samuelparlindungan/ML-Q-Learning/Artifacts/task.md

# Project Restoration: Hydroponic AI (Q-Learning)

## 📋 Task Checklist
- [x] Analyze workspace files (ESP32, Python, MD docs)
- [x] Identify hardware & software architecture
- [x] Read [summary_all.txt](file:///d:/GitHub/Tes%20Antigravity+Opencode/summary_all.txt) for academic & theoretical alignment
- [x] Complete comprehensive codebase analysis (.ino & .py)
- [x] Develop [ESP32_Aktuator_Maintenance.ino](file:///d:/GitHub/Tes%20Antigravity+Opencode/ESP32_Aktuator_Maintenance/ESP32_Aktuator_Maintenance.ino)
- [x] Verify Maintenance Mode (Serial & MQTT)
- [x] Align with user on next steps (Training vs Testing Bab 4)
- [x] Reorganize files into `Sistem_Kontrol_AI` folder
- [x] Mapping Data Collection Workflow for Thesis
- [x] Aligning Maintenance Firmware with Hardware Changes
- [x] Refining Data Collection Robustness
- [x] Troubleshooting EC Calibration Failure
- [x] Integrate Safety Interlock into Maintenance Firmware
- [x] Implement Training Versioning (Output Folders)
- [x] Relocate and Update Visualization Tools (Training & Dataset)
- [x] Implement Session-Aware Resume & Retry in Random Explorer
- [x] Synchronize stable Moving Average filter to [ESP_Sensor.ino](file:///d:/GitHub/Tes%20Antigravity+Opencode/ESP_Sensor.ino)
- [x] Verify EC/TDS high-point (12.88) with K:1.34
- [x] Calibrate EC low-point (1413) to sync TDS Pen 2x ratio
- [x] Collect 20-30 cycles of factual data via [random_explorer_v1.py](file:///d:/GitHub/Tes%20Antigravity+Opencode/random_explorer_v1.py)
- [x] Update [env_ph_ec.py](file:///d:/GitHub/Tes%20Antigravity+Opencode/env_ph_ec.py) with factual Delta_pH and Delta_EC values
- [x] Implement `ACTIVE_VERSION` switch in [env_ph_ec.py](file:///d:/GitHub/Tes%20Antigravity+Opencode/env_ph_ec.py)
- [x] Automate Output Directory Naming in [main_training.py](file:///d:/GitHub/Tes%20Antigravity+Opencode/main_training.py)
- [x] Automate PNG Generation in [visualize.py](file:///d:/GitHub/Tes%20Antigravity+Opencode/visualize.py)
- [x] Automate [buat_grafik.py](file:///d:/GitHub/Tes%20Antigravity+Opencode/buat_grafik.py) and [cek_nilai_q.py](file:///d:/GitHub/Tes%20Antigravity+Opencode/cek_nilai_q.py) naming
- [x] Create and Automate [main_test_model.py](file:///d:/GitHub/Tes%20Antigravity+Opencode/Sistem_Kontrol_AI/main_test_model.py)
- [x] Upgrade Reporting Scripts to Batch Processing (v1, v2, v3)
- [x] Hardware Safety Optimization (Non-Blocking Reconnect)
- [x] Final Auto-Control Deployment (Model v3 + Retry Logic)
- [x] Digital Twin ([env_ph_ec.py](file:///d:/GitHub/Tes%20Antigravity+Opencode/env_ph_ec.py)) Refactoring (Toggle-Friendly)

## 🏗️ Core Components Identified
- **Hardware**: ESP32 (Sensors & Actuators), Raspberry Pi (RL Agent).
- **Firmware**: 
    - [ESP32_Sensor.ino](file:///d:/GitHub/Tes%20Antigravity+Opencode/ESP32_Sensor/ESP32_Sensor.ino): 40-sample averaging, temperature compensation, MQTT.
    - `ESP32_Aktuator_Bypass`: JSON-based pump control.
- **AI Logic**: 
    - [env_ph_ec.py](file:///d:/GitHub/Tes%20Antigravity+Opencode/env_ph_ec.py): Gymnasium environment with real-world delta values.
    - [qlearning_agent.py](file:///d:/GitHub/Tes%20Antigravity+Opencode/qlearning_agent.py): Agent with Dual Decay (Alpha & Epsilon).
    - [main_training.py](file:///d:/GitHub/Tes%20Antigravity+Opencode/main_training.py): Training script.
- **Next Step Goal**: Finalize simulation vs real-tank data synchronization.
