samuelparlindungan/ML-Q-Learning/STABILITAS_Q_VALUE.md

# 📊 Analisis & Solusi Stabilitas Q-Value

## ❓ Masalah Awal

**Pertanyaan**: Mengapa nilai konvergensi Q tidak pernah mencapai stabil?

**Grafik Sebelumnya**: Q-max berfluktuasi di 120-180 tanpa stabilitas

---

## 🔍 Penyebab Fluktuasi Q-Value

### 1. **Environment Stochastic**

```python
# Natural drift
drift_ph = random.uniform(-0.1, 0.1)
drift_ec = random.uniform(-0.1, 0.1)

# Sensor noise
measured_ph = self.ph + random.uniform(-0.05, 0.05)
measured_ec = self.ec + random.uniform(-0.05, 0.05)
```

- Setiap step memiliki variasi acak
- Q-values terus di-update dengan pengalaman berbeda

### 2. **Learning Rate Konstan**

```python
# Sebelumnya
alpha = 0.15  # Konstan sepanjang training
```

- Learning rate tinggi → Q-values berubah drastis
- Tidak ada penurunan → terus "belajar" dengan intensitas sama

### 3. **Exploration Masih Aktif**

```python
epsilon = 0.089  # Di akhir training masih 8.9%
```

- Agent masih explore → mencoba action suboptimal
- Menghasilkan Q-value updates yang bervariasi

---

## ✅ Solusi Implementasi

### **1. Adaptive Learning Rate**

```python
class QLearningAgent:
    def __init__(self, alpha=0.1, alpha_decay=0.9995, alpha_min=0.01):
        self.alpha = alpha
        self.alpha_decay = alpha_decay
        self.alpha_min = alpha_min
        self.visit_count = np.zeros((n_states, n_actions))

    def update(self, state, action, reward, next_state):
        # Adaptive learning berdasarkan visit count
        self.visit_count[state, action] += 1
        adaptive_alpha = self.alpha / (1 + 0.001 * self.visit_count[state, action])

        # Q-learning update
        best_next = np.max(self.Q[next_state])
        td_target = reward + self.gamma * best_next
        td_error = td_target - self.Q[state, action]
        self.Q[state, action] += adaptive_alpha * td_error

    def decay_alpha(self):
        self.alpha = max(self.alpha_min, self.alpha * self.alpha_decay)
```

**Keuntungan**:

- ✅ Learning rate menurun seiring waktu
- ✅ State yang sering dikunjungi → learning rate lebih kecil
- ✅ Q-values lebih stabil di akhir training

### **2. Epsilon Scheduling yang Lebih Agresif**

```python
epsilon = 1.0           # Start: 100% exploration
epsilon_decay = 0.995   # Decay lebih cepat
epsilon_min = 0.01      # Minimum 1% exploration
```

**Hasil**:

```
Ep 150  | Eps: 0.471  (47.1%)
Ep 300  | Eps: 0.222  (22.2%)
Ep 450  | Eps: 0.105  (10.5%)
Ep 600  | Eps: 0.049  (4.9%)
Ep 750+ | Eps: 0.010  (1.0% - minimum)
```

### **3. Dual Decay (Alpha + Epsilon)**

```python
for ep in range(episodes):
    # ... training loop ...
    agent.decay_epsilon()  # Decay exploration
    agent.decay_alpha()    # Decay learning rate
```

**Hasil Alpha Decay**:

```
Ep 150  | Alpha: 0.0928
Ep 300  | Alpha: 0.0861
Ep 600  | Alpha: 0.0741
Ep 900  | Alpha: 0.0638
Ep 1200 | Alpha: 0.0549
Ep 1500 | Alpha: 0.0472
```

---

## 📈 Hasil Perbandingan

### **Sebelum (Fluktuasi Tinggi)**

```
Hyperparameters:
- alpha = 0.15 (konstan)
- epsilon = 0.4 → 0.01
- epsilon_decay = 0.999

Hasil:
- Q-max: 120-180 (fluktuasi ±30)
- Tidak stabil sampai akhir
```

### **Sesudah (Lebih Stabil)**

```
Hyperparameters:
- alpha = 0.1 → 0.0472 (adaptive decay)
- epsilon = 1.0 → 0.01
- epsilon_decay = 0.995
- visit_count adaptive learning

Hasil:
- Q-max: Lebih smooth dengan moving average
- Stabilitas meningkat di episode 900+
- Learning rate menurun → perubahan lebih kecil
```

---

## 🎯 Mengapa Masih Ada Fluktuasi Kecil?

**NORMAL dan DIHARAPKAN** karena:

1. **Environment Stochastic**
   - Natural drift dan sensor noise tetap ada
   - Ini mencerminkan kondisi real-world

2. **Exploration Minimum (1%)**
   - Agent masih explore sedikit
   - Mencegah overfitting ke satu policy

3. **Continuous Adaptation**
   - Agent tetap adaptif terhadap variasi
   - Tidak "frozen" pada satu nilai

---

## 📊 Cara Membaca Grafik Q-max

### **Dengan Moving Average (Window=50)**

```python
qmax_ma = np.convolve(qmax, np.ones(50)/50, mode="valid")
plt.plot(qmax, alpha=0.3, label="Q-max")
plt.plot(qmax_ma, linewidth=2, label="Moving Avg")
```

**Interpretasi**:

- ✅ Moving average menunjukkan trend stabil
- ✅ Fluktuasi kecil di sekitar trend = normal
- ✅ Tidak ada drift naik/turun drastis = konvergen

---

## 🔧 Tuning Lebih Lanjut (Opsional)

### **Jika Ingin Stabilitas Lebih Tinggi**:

```python
# Opsi 1: Alpha decay lebih agresif
alpha_decay = 0.999  # Dari 0.9995

# Opsi 2: Epsilon minimum lebih kecil
epsilon_min = 0.001  # Dari 0.01

# Opsi 3: Tambah episodes dengan frozen epsilon
for ep in range(1500, 2000):
    agent.epsilon = 0.001  # Frozen
    # ... training ...
```

### **Jika Ingin Learning Lebih Cepat**:

```python
# Alpha awal lebih tinggi
alpha = 0.15  # Dari 0.1

# Tapi decay lebih cepat
alpha_decay = 0.998  # Dari 0.9995
```

---

## ✅ Kesimpulan

### **Fluktuasi Q-Value adalah NORMAL jika**:

1. ✅ Moving average menunjukkan konvergensi
2. ✅ Reward sudah stabil dan meningkat
3. ✅ Learning rate menurun seiring waktu
4. ✅ Fluktuasi berkurang di akhir training

### **Implementasi Saat Ini**:

- ✅ Adaptive learning rate (0.1 → 0.047)
- ✅ Epsilon decay agresif (1.0 → 0.01)
- ✅ Visit-count based adaptation
- ✅ Dual decay (alpha + epsilon)

### **Hasil**:

- ✅ Reward konvergen: -1307 → 34 (stabil)
- ✅ Q-max lebih smooth dengan moving average
- ✅ Stabilitas meningkat signifikan di episode 900+

---

## 📚 Referensi

**Sutton & Barto (2018)**: Reinforcement Learning: An Introduction

- Chapter 2.5: Tracking a Nonstationary Problem
- Chapter 6.5: Q-Learning

**Best Practices**:

- Adaptive learning rates untuk stabilitas
- Epsilon decay untuk balance exploration-exploitation
- Moving average untuk visualisasi trend
