samuelparlindungan/ML-Q-Learning/output/PROJECT_ALL_FILES.md

# KUMPULAN ISI FILE — PROYEK HIDROPONIK RL Q-LEARNING

---

## BAGIAN 1: KODE SUMBER PYTHON (.py)

### `env_ph_ec.py`

```python
import gymnasium as gym  # Import gymnasium library for creating reinforcement learning environments
from gymnasium import (
    spaces,
)  # Import spaces module for defining observation and action spaces
import numpy as np  # Import numpy for numerical operations and arrays

# random sudah diganti np.random.normal() di v5

class PhEcEnv(
    gym.Env
):  # Define the PhEcEnv class inheriting from gym.Env for custom environment
    def __init__(self):  # Initialize the environment instance
        super().__init__()  # Call parent class initializer
        # self.ACTIVE_VERSION = "v5_normal_sesi3"
        self.ACTIVE_VERSION = (
            "v6_final"  # v6: Gabungan Sesi 1-4 (Cleaned) + Anti-Hacking Logic
        )
        # 25 states: 5 pH levels x 5 EC levels (sesuai Tabel 3.3)
        self.observation_space = spaces.Discrete(
            25
        )  # Define observation space as 25 discrete states
        # 9 actions: sesuai Tabel 3.4 (Idle, pH Up Short/Long, dll.)
        self.action_space = spaces.Discrete(
            9
        )  # Define action space as 9 discrete actions
        # Target state: pH index 2, EC index 2 (State 13, indeks 12 di 0-based)
        self.optimal_ph = 2  # Set optimal pH index
        self.optimal_ec = 2  # Set optimal EC index
        # Critical states untuk inisialisasi training (zona Kritis/Kritis Ekstrem)
        self.critical_states = [
            0,
            1,
            2,
            3,
            4,
            5,
            9,
            10,
            14,
            15,
            19,
            20,
            21,
            22,
            23,
            24,
        ]  # List of critical states for initialization
        # Reward table sesuai Tabel 3.6 (zona-based)
        self.reward_table = self._build_reward()  # Build and assign reward table

    def _build_reward(self):  # Private method to build the reward table
        r = np.full(25, 0.0)  # Initialize reward array with 25 zeros

        # Kritis Ekstrem: -40 (States 1,5,21,25 -> indeks 0,4,20,24)
        extreme = [0, 4, 20, 24]  # List of extreme critical state indices
        for s in extreme:  # Loop through extreme states
            # r[s] = -120.0  # Assign reward for extreme states
            r[s] = -40.0  # Assign reward for extreme states (Reward Shaping)

        # Kritis: -20 (States 2,3,4,6,10,11,15,16,20,22,23,24 -> indeks 1,2,3,5,9,10,14,15,19,21,22,23)
        kritis = [
            1,
            2,
            3,
            5,
            9,
            10,
            14,
            15,
            19,
            21,
            22,
            23,
        ]  # List of critical state indices
        for s in kritis:  # Loop through critical states
            # r[s] = -80.0  # Assign reward for critical states
            r[s] = -20.0  # Assign reward for critical states (Reward Shaping)

        # Transisi: -2 (States 7,9,17,19 -> indeks 6,8,16,18)
        transisi = [6, 8, 16, 18]  # List of transition state indices
        for s in transisi:  # Loop through transition states
            # r[s] = -5.0  # Assign reward for transition states
            r[s] = -2.0  # Assign reward for transition states (Reward Shaping)

        # Sub-Optimal: -1 (States 8,12,14,18 -> indeks 7,11,13,17)
        sub_optimal = [7, 11, 13, 17]  # List of sub-optimal state indices
        for s in sub_optimal:  # Loop through sub-optimal states
            # r[s] = 10.0  # Assign reward for sub-optimal states
            r[s] = -1.0  # Paksa agen untuk bergerak ke State 13 (Penalty per step)

        # Target: +100 (State 13 -> indeks 12)
        # r[12] = (
        #    50.0  # [AI BOOSTER] Hadiah Jackpot agar AI sangat termotivasi (aslinya 50)
        # )
        r[12] = (
            100.0  # [Reward Shaping] Insentif tinggi agar AI keluar dari local optima
        )
        return r  # Return the reward array

    def reset(self, seed=None, options=None):  # Reset the environment to initial state
        # Inisialisasi acak dari critical states untuk training
        crit_idx = np.random.choice(
            self.critical_states
        )  # Randomly choose a critical state index
        self.ph = crit_idx // 5 + np.random.uniform(
            -0.4, 0.4
        )  # Set initial pH with random variation
        self.ec = crit_idx % 5 + np.random.uniform(
            -0.4, 0.4
        )  # Set initial EC with random variation
        state = int(
            np.clip(round(self.ph), 0, 4)
        ) * 5 + int(  # Calculate discrete state from pH and EC
            np.clip(round(self.ec), 0, 4)  # Clip EC to valid range
        )
        return state, {}  # Return initial state and empty info dict

    def step(self, action):  # Execute one step in the environment
        delta_ph, delta_ec = 0.0, 0.0  # Initialize changes in pH and EC

        # ======================================================================
        # DATA EMPIRIS TRANSISI (Delta pH & Delta EC) - CLEANED
        # Diambil dari dataset_acak_qlearning.csv (Gabungan Sesi 1-4)
        # Filter: Membuang anomali sensor & lonjakan fisik yang mustahil
        # Tanggal: 2026-04-29
        # ======================================================================
        EC_SCALE = 0.01

        if action == 1:  # pH Up Short
            # delta_ph, delta_ec = 0.50, 0.0    # v1 (Teori)
            # delta_ph, delta_ec = 0.15, 25.6   # v2 (Sesi 1)
            # delta_ph, delta_ec = 0.20, 0.0    # v3 (Sesi 2)
            # delta_ph, delta_ec = 0.15, 40.0   # v4 (Sesi 3)
            # delta_ph = np.random.normal(0.095, 0.01)  # v5 (Sesi 3 Normal)
            # delta_ec = np.random.normal(40.88 * EC_SCALE, 16.11 * EC_SCALE) # v5
            delta_ph = np.random.normal(0.1311, 0.0813)  # v6 (Final: Sesi 1-4 Cleaned)
            delta_ec = np.random.normal(40.90 * EC_SCALE, 47.91 * EC_SCALE)

        elif action == 2:  # pH Up Long
            # delta_ph, delta_ec = 1.00, 0.0    # v1 (Teori)
            # delta_ph, delta_ec = 0.50, 48.2   # v2 (Sesi 1)
            # delta_ph, delta_ec = 0.45, 10.0   # v3 (Sesi 2)
            # delta_ph, delta_ec = 0.40, 27.5   # v4 (Sesi 3)
            # delta_ph = np.random.normal(0.404, 0.198)  # v5 (Sesi 3 Normal)
            # delta_ec = np.random.normal(27.53 * EC_SCALE, 17.29 * EC_SCALE) # v5
            delta_ph = np.random.normal(0.3315, 0.1679)  # v6 (Final: Sesi 1-4 Cleaned)
            delta_ec = np.random.normal(32.88 * EC_SCALE, 33.30 * EC_SCALE)

        elif action == 3:  # pH Down Short
            # delta_ph, delta_ec = -0.50, 0.0   # v1 (Teori)
            # delta_ph, delta_ec = -0.21, 2.0    # v2 (Sesi 1)
            # delta_ph, delta_ec = -0.25, 30.0  # v3 (Sesi 2)
            # delta_ph, delta_ec = -0.20, 2.0   # v4 (Sesi 3)
            # delta_ph = np.random.normal(-0.211, 0.112) # v5 (Sesi 3 Normal)
            # delta_ec = np.random.normal(2.39 * EC_SCALE, 20.22 * EC_SCALE) # v5
            delta_ph = np.random.normal(-0.1672, 0.1018)  # v6 (Final: Sesi 1-4 Cleaned)
            delta_ec = np.random.normal(26.50 * EC_SCALE, 54.25 * EC_SCALE)

        elif action == 4:  # pH Down Long
            # delta_ph, delta_ec = -1.00, 0.0   # v1 (Teori)
            # delta_ph, delta_ec = -0.42, 11.4   # v2 (Sesi 1)
            # delta_ph, delta_ec = -0.16, 40.0  # v3 (Sesi 2)
            # delta_ph, delta_ec = -0.60, 1.7   # v4 (Sesi 3)
            # delta_ph = np.random.normal(-0.594, 0.523) # v5 (Sesi 3 Normal)
            # delta_ec = np.random.normal(1.71 * EC_SCALE, 6.91 * EC_SCALE) # v5
            delta_ph = np.random.normal(-0.4015, 0.3578)  # v6 (Final: Sesi 1-4 Cleaned)
            delta_ec = np.random.normal(26.36 * EC_SCALE, 49.63 * EC_SCALE)

        elif action == 5:  # Nutrisi Short
            # delta_ph, delta_ec = 0.00, 0.50   # v1 (Teori)
            # delta_ph, delta_ec = -0.03, 78.8  # v2 (Sesi 1)
            # delta_ph, delta_ec = -0.02, 75.0  # v3 (Sesi 2)
            # delta_ph, delta_ec = -0.01, 30.0  # v4 (Sesi 3)
            # delta_ph = np.random.normal(-0.013, 0.054) # v5 (Sesi 3 Normal)
            # delta_ec = np.random.normal(29.68 * EC_SCALE, 30.33 * EC_SCALE) # v5
            delta_ph = np.random.normal(-0.0161, 0.0344)  # v6 (Final: Sesi 1-4 Cleaned)
            delta_ec = np.random.normal(57.68 * EC_SCALE, 53.26 * EC_SCALE)

        elif action == 6:  # Nutrisi Long
            # delta_ph, delta_ec = 0.00, 1.00   # v1 (Teori)
            # delta_ph, delta_ec = -0.15, 132.0 # v2 (Sesi 1)
            # delta_ph, delta_ec = -0.18, 276.0 # v3 (Sesi 2)
            # delta_ph, delta_ec = -0.05, 112.0 # v4 (Sesi 3)
            # delta_ph = np.random.normal(-0.050, 0.01)  # v5 (Sesi 3 Normal)
            # delta_ec = np.random.normal(112.74 * EC_SCALE, 35.45 * EC_SCALE) # v5
            delta_ph = np.random.normal(-0.1006, 0.1035)  # v6 (Final: Sesi 1-4 Cleaned)
            delta_ec = np.random.normal(163.92 * EC_SCALE, 78.06 * EC_SCALE)

        elif action == 7:  # Air Baku Short
            # delta_ph, delta_ec = 0.00, -0.50  # v1 (Teori)
            # delta_ph, delta_ec = -0.02, 17.2  # v2 (Sesi 1)
            # delta_ph, delta_ec = -0.02, -290.0 # v3 (Sesi 2)
            # delta_ph, delta_ec = 0.01, -3.1   # v4 (Sesi 3)
            # delta_ph = np.random.normal(0.013, 0.021)  # v5 (Sesi 3 Normal)
            # delta_ec = np.random.normal(-3.13 * EC_SCALE, 3.62 * EC_SCALE) # v5
            delta_ph = np.random.normal(-0.0039, 0.0246)  # v6 (Final: Sesi 1-4 Cleaned)
            delta_ec = np.random.normal(-30.32 * EC_SCALE, 94.89 * EC_SCALE)

        elif action == 8:  # Air Baku Long
            # delta_ph, delta_ec = 0.00, -1.00  # v1 (Teori)
            # delta_ph, delta_ec = -0.00, 13.4  # v2 (Sesi 1)
            # delta_ph, delta_ec = -0.00, -400.0 # v3 (Sesi 2)
            # delta_ph, delta_ec = 0.01, -1.8   # v4 (Sesi 3)
            # delta_ph = np.random.normal(0.015, 0.015)  # v5 (Sesi 3 Normal)
            # delta_ec = np.random.normal(-1.76 * EC_SCALE, 2.84 * EC_SCALE) # v5
            delta_ph = np.random.normal(0.0023, 0.0190)  # v6 (Final: Sesi 1-4 Cleaned)
            delta_ec = np.random.normal(3.58 * EC_SCALE, 31.70 * EC_SCALE)
        # ======================================================================

        # Natural drift (noise empiris dari tandon asli)
        drift_ph = np.random.normal(0.0, 0.01)  # Drift pH alami
        drift_ec = np.random.normal(
            0.0, 3.0 * EC_SCALE
        )  # Drift EC alami (homogenisasi)
        self.ph += delta_ph + drift_ph
        self.ec += delta_ec + drift_ec

        # Sensor noise (Akurasi pembacaan sensor)
        measured_ph = self.ph + np.random.normal(0.0, 0.005)
        measured_ec = self.ec + np.random.normal(0.0, 1.0 * EC_SCALE)

        # Discretization
        ph_d = int(np.clip(round(measured_ph), 0, 4))  # Discretize pH to 0-4
        ec_d = int(np.clip(round(measured_ec), 0, 4))  # Discretize EC to 0-4
        state = ph_d * 5 + ec_d  # Calculate new state index
        reward = self.reward_table[state]  # Get reward for current state

        # Sesuai instruksi Engineer: Jangan mati di State 13 (Non-Episodic Control)
        # Episode berakhir hanya jika masuk ke zona bahaya fisik (Extreme Critical)
        # extreme = [0, 4, 20, 24]
        terminated = state in [0, 4, 20, 24]

        truncated = False  # Set truncated to False (not used)
        return state, reward, terminated, truncated, {}  # Return step results

# ==========================================
# FUNGSI PEMBANTU GLOBAL (Untuk Deploy)
# ==========================================
def get_ph_idx(ph):
    """Konversi nilai pH ke index 0-4 sesuai Tabel 3.3 TA"""
    if ph < 5.5:
        return 0
    if ph < 5.8:
        return 1
    if ph <= 6.2:
        return 2  # Optimal
    if ph <= 6.5:
        return 3
    return 4

def get_ec_idx(ec):
    """Konversi nilai EC ke index 0-4 sesuai Tabel 3.3 TA"""
    if ec < 800:
        return 0
    if ec < 1100:
        return 1
    if ec <= 1300:
        return 2  # Optimal
    if ec <= 1600:
        return 3
    return 4

def get_reward(ph, ec):
    """Hitung reward menggunakan reward_table dari env yang sudah diinisialisasi"""
    env = PhEcEnv()
    state = get_ph_idx(ph) * 5 + get_ec_idx(ec)
    return env.reward_table[state]

```

---

### `qlearning_agent.py`

```python
import numpy as np  # Import numpy for numerical operations and arrays
import random  # Import random for generating random numbers

class QLearningAgent:  # Define the QLearningAgent class for Q-learning algorithm
    def __init__(  # Initialize the Q-learning agent
        self,
        n_states=25,  # Number of states in the environment
        n_actions=9,  # Number of actions available
        alpha=0.1,  # Ekploration 10%, Eksploitation 90%
        #alpha_decay=0.9995,  # Decay rate for alpha
        alpha_decay=0.9998,  # Decay rate for alpha
        alpha_min=0.01,  # Minimum value for alpha
        #gamma=0.95,  # Jika agent
        # persamaan bellman equation notasi gamma adalah diskon faktor
        #gamma=0.90,  # Diskon faktor (Bellman Equation)
        gamma=0.95,  # Visi jangka panjang (Sesuai draf B600)
        epsilon=1.0,  # Initial exploration rate
        #epsilon_decay=0.995,  # Decay rate for epsilon
        #epsilon_decay=0.9995,  # Decay rate for epsilon
        epsilon_decay=0.9999,  # Eksplorasi awet sampai 50rb episode (Sesuai draf B600)
        epsilon_min=0.01,  # Minimum value for epsilon
    ):
        self.Q = np.zeros((n_states, n_actions))  # 25x9 sesuai Tabel 3.5
        #self.alpha = 0.05  # Learning rate lebih stabil untuk reward besar
        self.alpha = alpha  # Menggunakan parameter (0.10)
        self.alpha_decay = alpha_decay  # Decay untuk learning rate
        self.alpha_min = alpha_min  # Minimum learning rate
        #self.gamma = 0.999  # Visi jangka sangat panjang
        #self.gamma = 0.90  # Menggunakan parameter (0.90)
        self.gamma = gamma  # Menggunakan parameter (0.95)
        self.epsilon = epsilon  # Initial exploration rate
        #self.epsilon_decay = 0.9999  # Eksplorasi awet sampai 50rb episode
        #self.epsilon_decay = 0.9995  # eps -> 0.01 di ~ep 9200
        self.epsilon_decay = epsilon_decay  # Eksplorasi awet (0.9999)
        self.epsilon_min = epsilon_min  # Minimum exploration rate
        self.n_actions = n_actions  # Number of actions

        # Track visit count untuk adaptive learning
        self.visit_count = np.zeros(
            (n_states, n_actions)
        )  # Initialize visit count array

    def select_action(self, state):  # Select an action based on epsilon-greedy policy
        if (
            random.random() < self.epsilon
        ):  # If random number less than epsilon, explore
            return random.randint(0, self.n_actions - 1)  # Return random action
        return np.argmax(self.Q[state])  # Return action with highest Q-value

    def update(
        self, state, action, reward, next_state
    ):  # Update Q-table using Q-learning update rule
        # Adaptive learning rate berdasarkan visit count
        self.visit_count[
            state, action
        ] += 1  # Increment visit count for state-action pair
        # adaptive_alpha = self.alpha / (1 + 0.001 * self.visit_count[state, action])  # v1
        adaptive_alpha = self.alpha / (
            1 + 0.01 * self.visit_count[state, action]
        )  # v2: Lebih responsif

        best_next = np.max(self.Q[next_state])  # Get maximum Q-value for next state
        td_target = reward + self.gamma * best_next  # Calculate TD target
        td_error = td_target - self.Q[state, action]  # Calculate TD error
        self.Q[state, action] += adaptive_alpha * td_error  # Update Q-value

    def decay_epsilon(self):  # Decay the exploration rate
        self.epsilon = max(
            self.epsilon_min, self.epsilon * self.epsilon_decay
        )  # Update epsilon with decay

    def decay_alpha(self):  # Decay learning rate for stability at end of training
        """Decay learning rate untuk stabilitas di akhir training"""
        self.alpha = max(
            self.alpha_min, self.alpha * self.alpha_decay
        )  # Update alpha with decay

```

---

### `main_training.py`

```python
import numpy as np  # Import numpy for numerical operations and arrays
import json  # Import json for saving policy data
import os  # Import os for file system operations
from env_ph_ec import PhEcEnv  # Import the custom PhEcEnv environment
from qlearning_agent import QLearningAgent  # Import the QLearningAgent class

# ==========================================
# 0. KONFIGURASI VERSI (Manual)
# ==========================================
# Sesuaikan nama versi ini dengan yang Anda pilih di env_ph_ec.py
VERSION = "v6_lama"  # Hasil Akhir: Sesi 1-4 Cleaned + Anti-Hacking + New Reward
# VERSION = "v5_normal_sesi3"

# Gunakan path absolut agar folder output selalu berada di dalam project
SCRIPT_DIR = os.path.dirname(os.path.abspath(__file__))
OUT_DIR = os.path.normpath(os.path.join(SCRIPT_DIR, "..", "output", VERSION))
os.makedirs(OUT_DIR, exist_ok=True)
env = PhEcEnv()  # Initialize the PhEc environment
agent = QLearningAgent(n_states=25, n_actions=9)  # Initialize the Q-learning agent

episodes = 10000  # [AI BOOSTER] Ditambah agar AI punya waktu latihan yang cukup
max_steps = 200  # [AI BOOSTER] Ditambah agar AI punya napas panjang mencapai target

reward_log = []  # List to log total rewards per episode
step_log = []  # List to log steps per episode
qmax_log = []  # List to log maximum Q-values per episode
alpha_log = []  # List to log alpha values per episode
state_visit = np.zeros(25)  # Array to count visits to each state
action_count = np.zeros(9)  # Array to count actions taken
trajectory = []  # List to store state trajectories

print("Critical states:", env.critical_states)  # Print critical states
print("Reward grid:\n", env.reward_table.reshape(5, 5))  # Print reward grid
print(
    f"Initial: Alpha={agent.alpha:.3f}, Epsilon={agent.epsilon:.3f}\n"
)  # Print initial parameters

for ep in range(episodes):  # Loop over episodes
    state, _ = env.reset()  # Reset environment and get initial state
    total_reward = 0  # Initialize total reward for episode
    steps = 0  # Initialize step count

    for _ in range(max_steps):  # Loop over maximum steps
        action = agent.select_action(state)  # Select action using agent
        next_state, reward, done, _, _ = env.step(action)  # Take step in environment
        agent.update(state, action, reward, next_state)  # Update agent Q-table
        state_visit[state] += 1  # Increment state visit count
        action_count[action] += 1  # Increment action count
        trajectory.append(state)  # Append state to trajectory
        state = next_state  # Update current state
        total_reward += reward  # Accumulate reward
        steps += 1  # Increment step count
        if done:  # If episode is done
            state_visit[next_state] += 1  # Count visit to terminal state
            trajectory.append(next_state)  # Append terminal state to trajectory
            break  # Break the loop

        state = next_state  # Update state for next iteration

    agent.decay_epsilon()  # Decay epsilon
    agent.decay_alpha()  # Decay learning rate juga

    reward_log.append(total_reward)  # Append total reward to log
    step_log.append(steps)  # Append steps to log
    qmax_log.append(np.max(agent.Q))  # Append max Q to log
    alpha_log.append(agent.alpha)  # Append alpha to log

    if (ep + 1) % 150 == 0:  # Every 150 episodes
        avg_r = np.mean(
            reward_log[-150:]
        )  # Calculate average reward of last 150 episodes
        print(  # Print progress
            f"Ep {ep+1} | AvgR:{avg_r:.1f} | Eps:{agent.epsilon:.3f} | Alpha:{agent.alpha:.4f}"
        )

# Save ke folder output/
np.save(f"{OUT_DIR}/Q_table.npy", agent.Q)  # Save Q-table
np.save(f"{OUT_DIR}/reward_log.npy", reward_log)  # Save reward log
np.save(f"{OUT_DIR}/step_log.npy", step_log)  # Save step log
np.save(f"{OUT_DIR}/qmax_log.npy", qmax_log)  # Save qmax log
np.save(f"{OUT_DIR}/alpha_log.npy", alpha_log)  # Save alpha log
np.save(f"{OUT_DIR}/state_visit.npy", state_visit)  # Save state visit counts
np.save(f"{OUT_DIR}/action_count.npy", action_count)  # Save action counts
np.save(f"{OUT_DIR}/trajectory.npy", trajectory)  # Save trajectory

# Buat policy.json
policy = {}  # Initialize policy dictionary
for state in range(25):  # Loop over all states
    ph_idx = state // 5  # Calculate pH index
    ec_idx = state % 5  # Calculate EC index
    best_action = int(np.argmax(agent.Q[state]))  # Get best action
    q_values = agent.Q[state].tolist()  # Get Q-values as list
    policy[f"state_{state+1}"] = {  # Add to policy dict
        "pH_index": ph_idx,
        "EC_index": ec_idx,
        "best_action": best_action,
        "q_values": q_values,
        "max_q": float(np.max(agent.Q[state])),
    }

with open(f"{OUT_DIR}/policy.json", "w") as f:  # Open policy.json file
    json.dump(policy, f, indent=2)  # Dump policy to JSON

print("\n[OK] TRAINING SELESAI!")  # Print completion message
print(
    f"Final: Alpha={agent.alpha:.4f}, Epsilon={agent.epsilon:.3f}"
)  # Print final parameters
print(
    "File output: Q_table.npy, reward_log.npy, step_log.npy, qmax_log.npy,"
)  # Print output files
print(  # Continue printing output files
    "             alpha_log.npy, state_visit.npy, action_count.npy, trajectory.npy, policy.json"
)

```

---

### `random_explorer_v1.py`

```python
import paho.mqtt.client as mqtt
import time
import pandas as pd
import os
import json
import random
from datetime import datetime

# ==========================================
# 1. KONFIGURASI MQTT & FILE
# ==========================================
MQTT_BROKER = "192.168.100.10"
MQTT_PORT = 1883
TOPIC_SENSOR = "hidroponik/sensor"
TOPIC_ACTION = "hidroponik/action"
TOPIC_STATUS = "hidroponik/status"

CSV_FILENAME = "../dataset_acak_qlearning.csv"
WAKTU_MIXING = 180  # 3 Menit jeda pelarutan
WAKTU_SAMP = 60  # 1 Menit pengambilan data per state (sesuai Skripsi)

# ==========================================
# 2. VARIABEL GLOBAL
# ==========================================
buffer_ph = []
buffer_ec = []
pompa_selesai = False
current_tx_id = ""  # ID unik untuk mencegah double-dosing

# ==========================================
# 3. CALLBACK MQTT
# ==========================================
def on_connect(client, userdata, flags, rc):
    print(f"✅ Terhubung ke Broker MQTT (RC: {rc})")
    client.subscribe(TOPIC_SENSOR)
    client.subscribe(TOPIC_STATUS)

def on_message(client, userdata, msg):
    global pompa_selesai, buffer_ph, buffer_ec
    payload = msg.payload.decode("utf-8")

    if msg.topic == TOPIC_STATUS:
        # Verifikasi apakah DONE ini milik perintah yang baru saja dikirim
        if payload == f"DONE:{current_tx_id}":
            pompa_selesai = True
            print(f"   [MQTT] Konfirmasi Diterima: {payload}")
        elif payload.startswith("DONE:"):
            print(f"   [MQTT] Abaikan konfirmasi lama: {payload}")

    elif msg.topic == TOPIC_SENSOR:
        try:
            data = json.loads(payload)
            ph = float(data.get("ph", data.get("pH", 0.0)))
            ec = float(data.get("ec", data.get("EC", 0.0)))
            buffer_ph.append(ph)
            buffer_ec.append(ec)
        except:
            pass

# ==========================================
# 4. FUNGSI HELPER
# ==========================================
def ambil_rata_rata(durasi_detik):
    global buffer_ph, buffer_ec
    buffer_ph.clear()
    buffer_ec.clear()

    print(f"   [Sampling] Mengambil data selama {durasi_detik} detik...")
    for i in range(durasi_detik, 0, -1):
        if i % 15 == 0:
            print(f"   Sisa waktu sampling: {i}s")
        time.sleep(1)

    if len(buffer_ph) == 0:
        return None, None

    avg_ph = round(sum(buffer_ph) / len(buffer_ph), 2)
    avg_ec = round(sum(buffer_ec) / len(buffer_ec), 2)
    return avg_ph, avg_ec

def inisialisasi_csv(session_name):
    if not os.path.exists(CSV_FILENAME):
        df = pd.DataFrame(
            columns=[
                "Sesi_Eksperimen",
                "Cycle",
                "pH_St",
                "EC_St",
                "Action",
                "pH_St1",
                "EC_St1",
                "Delta_pH",
                "Delta_EC",
                "Timestamp",
            ]
        )
        df.to_csv(CSV_FILENAME, index=False)
        return 0
    try:
        df = pd.read_csv(CSV_FILENAME)
        if df.empty:
            return 0
        session_data = df[df["Sesi_Eksperimen"] == session_name]
        if session_data.empty:
            return 0
        return int(session_data["Cycle"].max())
    except:
        return 0

# ==========================================
# 5. PROGRAM UTAMA (RANDOM EXPLORER)
# ==========================================
if __name__ == "__main__":
    client = mqtt.Client()
    client.on_connect, client.on_message = on_connect, on_message

    try:
        client.connect(MQTT_BROKER, MQTT_PORT, 60)
        client.loop_start()

        print("\n" + "=" * 55)
        print("🤖   ROBOT EKSPLORASI ACAK (RELIABLE VERSION)   🤖")
        print("=" * 55)

        sesi_name = input("Masukkan Nama Sesi (Misal: Sesi_2): ")
        if not sesi_name:
            sesi_name = "Default_Session"

        CYCLES_TO_RUN = 50
        last_cycle = inisialisasi_csv(sesi_name)
        start_cycle = last_cycle + 1

        for cycle in range(start_cycle, CYCLES_TO_RUN + 1):
            print(f"\n🚀 >>> SIKLUS: {cycle}/{CYCLES_TO_RUN} <<<")

            # --- LANGKAH 1: STATE AWAL ---
            ph_st, ec_st = ambil_rata_rata(WAKTU_SAMP)
            if ph_st is None:
                print("❌ [ERROR] Sensor Offline! Berhenti.")
                break
            print(f"   [State St] pH: {ph_st} | EC: {ec_st}")

            # --- LANGKAH 2: AKSI ACAK DENGAN TXID ---
            aksi = random.randint(1, 8)
            current_tx_id = str(int(time.time()))[-6:]  # Unique ID
            payload = f"{aksi}:{current_tx_id}"

            # Pastikan Koneksi MQTT Aktif sebelum kirim
            if not client.is_connected():
                print("   ⚠️ [MQTT] Terputus! Menunggu koneksi kembali...")
                for _ in range(10):  # Tunggu max 10 detik
                    time.sleep(1)
                    if client.is_connected():
                        break

            success_sent = False
            for attempt in range(1, 5):  # Maks 4 kali percobaan
                if not client.is_connected():
                    print(f"   ❌ [MQTT] Percobaan {attempt} gagal: Broker Offline.")
                    time.sleep(2)
                    continue

                print(f"   [Action] Percobaan {attempt}/4: Kirim {payload}")
                pompa_selesai = False
                client.publish(TOPIC_ACTION, payload)

                start_wait = time.time()
                while not pompa_selesai:
                    if time.time() - start_wait > 20:  # Timeout 20 detik
                        print(f"   ⚠️ [TIMEOUT] Percobaan {attempt} gagal.")
                        break
                    time.sleep(0.5)

                if pompa_selesai:
                    success_sent = True
                    break

            if not success_sent:
                print(
                    "❌ [FAILED] Gagal mendapatkan konfirmasi hardware. Lewati siklus."
                )
                continue

            # --- LANGKAH 3: HOMOGENISASI ---
            print(f"   [Mixing] Homogenisasi {WAKTU_MIXING} detik...")
            time.sleep(WAKTU_MIXING)

            # --- LANGKAH 4: STATE AKHIR ---
            ph_st1, ec_st1 = ambil_rata_rata(WAKTU_SAMP)
            if ph_st1 is None:
                continue
            print(f"   [State St1] pH: {ph_st1} | EC: {ec_st1}")

            # --- LANGKAH 5: SIMPAN ---
            delta_ph, delta_ec = round(ph_st1 - ph_st, 2), round(ec_st1 - ec_st, 2)
            row = [
                sesi_name,
                cycle,
                ph_st,
                ec_st,
                aksi,
                ph_st1,
                ec_st1,
                delta_ph,
                delta_ec,
                datetime.now(),
            ]

            pd.DataFrame([row]).to_csv(
                CSV_FILENAME, mode="a", header=False, index=False
            )
            print(f"✅ [SUCCESS] Data Siklus {cycle} tersimpan.")

    except KeyboardInterrupt:
        print("\n🛑 Dihentikan manual.")
    finally:
        client.loop_stop()
        client.disconnect()
        print("Koneksi ditutup. File CSV Anda siap diolah!")

```

---

### `main_auto_control.py`

```python
import paho.mqtt.client as mqtt
import time, json, os, pandas as pd
import csv, threading
from datetime import datetime
from env_ph_ec import PhEcEnv

# ==========================================
# 0. KONFIGURASI SISTEM
# ==========================================
SCRIPT_DIR = os.path.dirname(os.path.abspath(__file__))
MQTT_BROKER, MQTT_PORT = "192.168.100.10", 1883
TOPICS = {
    "sensor": "hidroponik/sensor",
    "action": "hidroponik/action",
    "status": "hidroponik/status",
}
VERSION_LOAD = "v6_final"
CSV_AUTO = os.path.normpath(
    os.path.join(SCRIPT_DIR, "..", "output", "data_transisi_otomatis.csv")
)
POLICY_FILE = os.path.normpath(
    os.path.join(SCRIPT_DIR, "..", "output", VERSION_LOAD, "policy.json")
)
LOG_FILE = os.path.normpath(os.path.join(SCRIPT_DIR, "..", "output", "system_log.csv"))

MAX_STEPS = 50  # <-- Diganti dari MAX_ACTIONS
WAKTU_HOMO = 180
WAKTU_SAMPLING = 60

# --- Shared State (dilindungi RLock) ---
lock = threading.RLock()

status = "SAMPLING"
waktu_homo_end = 0
waktu_sampling_end = time.time() + WAKTU_SAMPLING
waktu_resend_next = 0
waktu_kirim = 0
current_tx_id = ""
policy_ai = {}
sampling_buffer = {"ph": [], "ec": []}
tracking = {
    "wait_st1": False,
    "st_ph": 0.0,
    "st_ec": 0.0,
    "act": -1,
    "q": 0.0,
    "total_steps": 0,  # <-- Diganti dari total_actions
}

SAFETY_SWITCH = [True, True, True, True, True]

ACTIONS = {
    0: "IDLE",
    1: "pH Up S",
    2: "pH Up L",
    3: "pH Down S",
    4: "pH Down L",
    5: "Nutrisi S",
    6: "Nutrisi L",
    7: "Air S",
    8: "Air L",
}

MAX_RETRIES = 3
retry_count = 0

# Throttle [LEVELS]
_last_level_print = 0
LEVEL_PRINT_INTERVAL = 5
_level_printed = False  # Cetak level hanya sekali di awal

# ==========================================
# 1. FUNGSI PEMBANTU
# ==========================================
def get_ph_idx(v):
    """Konversi pH ke indeks 0-4 sesuai Tabel 3.1"""
    if v < 5.5:
        return 0
    elif v < 5.8:
        return 1
    elif v <= 6.2:
        return 2
    elif v <= 6.5:
        return 3
    else:
        return 4

def get_ec_idx(v):
    """Konversi EC ke indeks 0-4 sesuai Tabel 3.2"""
    if v < 800:
        return 0
    elif v < 1100:
        return 1
    elif v <= 1300:
        return 2
    elif v <= 1600:
        return 3
    else:
        return 4

def get_reward(ph, ec):
    """Hitung reward berdasarkan Tabel 3.6 Bab 3"""
    env = PhEcEnv()
    state = get_ph_idx(ph) * 5 + get_ec_idx(ec)
    return env.reward_table[state]

def write_log(event_type, topic, detail=""):
    file_exists = os.path.isfile(LOG_FILE)
    os.makedirs(os.path.dirname(LOG_FILE), exist_ok=True)
    with open(LOG_FILE, mode="a", newline="") as f:
        writer = csv.writer(f)
        if not file_exists:
            writer.writerow(["timestamp", "event_type", "topic", "detail"])
        writer.writerow([datetime.now().isoformat(), event_type, topic, detail])

def log_transition(ph_now, ec_now):
    with lock:
        if not tracking["wait_st1"]:
            return
        reward = get_reward(ph_now, ec_now)
        data = {
            "Sesi": f"AUTO_{VERSION_LOAD}",
            "Aksi": tracking["act"],
            "pH_St": tracking["st_ph"],
            "EC_St": tracking["st_ec"],
            "pH_St+1": ph_now,
            "EC_St+1": ec_now,
            "Delta_pH": round(ph_now - tracking["st_ph"], 2),
            "Delta_EC": round(ec_now - tracking["st_ec"], 2),
            "Reward": reward,
            "Max_Q": tracking["q"],
            "Timestamp": datetime.now().strftime("%Y-%m-%d %H:%M:%S"),
        }
        tracking["wait_st1"] = False
    df = pd.DataFrame([data])
    df.to_csv(CSV_AUTO, mode="a", header=not os.path.exists(CSV_AUTO), index=False)
    print(
        f"[LOG] DATA DISIMPAN: {ACTIONS[data['Aksi']]} | D_pH:{data['Delta_pH']} | D_EC:{data['Delta_EC']} | R:{data['Reward']}"
    )

def push_action(action_id, is_retry=False):
    """Harus dipanggil di dalam 'with lock'."""
    global waktu_resend_next, current_tx_id, waktu_kirim, retry_count

    if not is_retry:
        current_tx_id = str(int(time.time()))[-6:]
        waktu_kirim = time.time()
        retry_count = 0

    payload = f"{action_id}:{current_tx_id}"
    client.publish(TOPICS["action"], payload)
    write_log("SEND_ACTION", TOPICS["action"], payload)

    timeout_map = {7: 65, 8: 185}
    timeout = timeout_map.get(action_id, 15)
    waktu_resend_next = time.time() + timeout

    if not is_retry:
        print(f"[ACTION] Perintah Terkirim: {ACTIONS.get(action_id)} (ID:{payload})")
    return True

# ==========================================
# 2. HANDLER MQTT
# ==========================================
def on_connect(client, userdata, flags, reason_code, properties):
    print(f"[MQTT] Terhubung ke Broker! Model Aktif: {VERSION_LOAD}")
    for t in TOPICS.values():
        client.subscribe(t)

def on_message(client, userdata, msg):
    global status, waktu_homo_end, waktu_sampling_end, retry_count, _last_level_print, _level_printed
    payload = msg.payload.decode("utf-8")

    # --- Guard HALT & Snapshot status (dengan lock) ---
    with lock:
        if status == "HALT":
            return
        current_status = status  # snapshot untuk konsistensi di cabang pertama

    # A. Feedback Selesai dari ESP32
    if msg.topic == TOPICS["status"] and current_status == "DOSING":
        try:
            res = json.loads(payload)
            if res.get("tx") == current_tx_id and res.get("status") == "DONE":
                write_log("RECV_STATUS", msg.topic, payload)
                latensi = int((time.time() - waktu_kirim) * 1000)
                print(f"[STATUS] Selesai! ID: {res.get('tx')} | Latensi: {latensi}ms")
                with lock:
                    status = "HOMO"
                    waktu_homo_end = time.time() + WAKTU_HOMO
                    retry_count = 0
        except Exception:
            if payload == f"DONE:{current_tx_id}":
                with lock:
                    status = "HOMO"
                    waktu_homo_end = time.time() + WAKTU_HOMO
                    retry_count = 0
            else:
                print(f"[MQTT] Gagal parse status: {payload[:50]}")
        return  # Selesai proses status feedback

    # B. Monitoring Sensor & Keputusan AI
    if msg.topic != TOPICS["sensor"]:
        return

    write_log("RECV_SENSOR", msg.topic, payload)
    try:
        data = json.loads(payload)
        ph, ec = float(data.get("ph", 0)), float(data.get("ec", 0))

        v1, v2, v3, v4, v5 = (
            data.get("t1", 0),
            data.get("t2", 0),
            data.get("t3", 0),
            data.get("t4", 0),
            data.get("t5", 0),
        )
        vb = data.get("box", 0)

        if ph < 3 or ph > 9 or ec < 0 or ec > 3000:
            return

        tabung_levels = [v1, v2, v3, v4, v5]

        # Safety interlock
        low_level = False
        if vb < 5.0:
            print(f"[WAIT] Tandon Utama KRITIS ({vb:.1f}L)! Menunggu pengisian...")
            low_level = True
        for i, vol in enumerate(tabung_levels):
            if SAFETY_SWITCH[i] and vol < 100.0:
                print(
                    f"[WAIT] Tabung T{i+1} KRITIS ({vol:.0f}ml)! Menunggu pengisian..."
                )
                low_level = True

        # Cetak level hanya sekali di awal
        with lock:
            if not _level_printed:
                level_str = " | ".join(
                    [
                        f"T{i+1}:{v:.0f}ml" if SAFETY_SWITCH[i] else f"T{i+1}:OFF"
                        for i, v in enumerate(tabung_levels)
                    ]
                )
                print(f"[LEVELS] {level_str} | Box:{vb:.1f}L")
                _level_printed = True

        # --- State Management dengan re-snapshot setiap langkah ---

        # 1. Cek low level & transisi WAITING_REFILL
        if low_level:
            with lock:
                status = "WAITING_REFILL"
            return

        # 2. Jika tadi WAITING_REFILL, sekarang low_level sudah False -> resume langsung ke SAMPLING
        with lock:
            if status == "WAITING_REFILL":
                print("[RESUME] Air sudah terisi! Melanjutkan sistem...")
                status = "SAMPLING"
                waktu_sampling_end = time.time() + WAKTU_SAMPLING
                sampling_buffer["ph"], sampling_buffer["ec"] = [], []
                retry_count = 0
            # Ambil snapshot ulang karena status bisa berubah
            current_status = status

        # 3. State HOMO
        if current_status == "HOMO":
            with lock:
                if waktu_homo_end <= time.time():
                    status = "SAMPLING"
                    waktu_sampling_end = time.time() + WAKTU_SAMPLING
                    sampling_buffer["ph"], sampling_buffer["ec"] = [], []
                    retry_count = 0
                    current_status = status
                else:
                    current_status = "HOMO"
            if current_status != "SAMPLING":
                return
            return

        # 4. State SAMPLING
        if current_status == "SAMPLING":
            with lock:
                sampling_buffer["ph"].append(ph)
                sampling_buffer["ec"].append(ec)
                sisa = waktu_sampling_end - time.time()
            if sisa > 0:
                return

            # Guard buffer kosong
            if not sampling_buffer["ph"]:
                print("[WARN] Buffer sampling kosong, skip siklus ini.")
                with lock:
                    waktu_sampling_end = time.time() + WAKTU_SAMPLING
                return

            # Hitung rata-rata
            with lock:
                avg_ph = sum(sampling_buffer["ph"]) / len(sampling_buffer["ph"])
                avg_ec = sum(sampling_buffer["ec"]) / len(sampling_buffer["ec"])
                sampling_buffer["ph"], sampling_buffer["ec"] = [], []

            print(f"[SENSOR] Hasil Pembacaan: pH:{avg_ph:.2f}, EC:{avg_ec:.0f}")

            # Log transisi sebelumnya
            log_transition(avg_ph, avg_ec)

            # Keputusan AI
            s_idx = get_ph_idx(avg_ph) * 5 + get_ec_idx(avg_ec)
            state_key = f"state_{s_idx + 1}"

            if state_key not in policy_ai:
                print(f"[WARN] State {state_key} tidak ditemukan di policy!")
                with lock:
                    waktu_sampling_end = time.time() + WAKTU_SAMPLING
                return

            best_act = policy_ai[state_key]["best_action"]
            p_idx, e_idx = get_ph_idx(avg_ph), get_ec_idx(avg_ec)
            ph_labels = ["S.Rendah", "Rendah", "Optimal", "Tinggi", "S.Tinggi"]
            ec_labels = ["S.Rendah", "Rendah", "Optimal", "Tinggi", "S.Tinggi"]

            # Batas langkah (STEP)
            with lock:
                total_steps = tracking["total_steps"]
            if MAX_STEPS > 0 and total_steps >= MAX_STEPS:
                print(f"[FINISH] Uji Keandalan {MAX_STEPS} Step Selesai.")
                with lock:
                    status = "FINISH"
                return

            # --- Increment step (SETIAP SIKLUS) ---
            with lock:
                tracking["total_steps"] += 1
                total_steps = tracking["total_steps"]
                tracking.update(
                    {
                        "wait_st1": True,
                        "st_ph": avg_ph,
                        "st_ec": avg_ec,
                        "act": best_act,
                        "q": policy_ai[state_key]["max_q"],
                    }
                )

            if best_act == 0:  # IDLE
                print(
                    f"[STEP {total_steps}/{MAX_STEPS}] IDLE | State: {state_key} (pH:{ph_labels[p_idx]}, EC:{ec_labels[e_idx]}) | Kondisi Optimal."
                )
                with lock:
                    waktu_sampling_end = time.time() + WAKTU_SAMPLING
                    retry_count = 0
                return

            # NON-IDLE
            print(
                f"[STEP {total_steps}/{MAX_STEPS}] {ACTIONS[best_act]} | State: {state_key} (pH:{ph_labels[p_idx]}, EC:{ec_labels[e_idx]})"
            )
            with lock:
                if push_action(best_act):
                    status = "DOSING"
            return

    except Exception as e:
        print(f"[ERROR] on_message exception: {e}")

# ==========================================
# 3. MAIN RUN LOOP
# ==========================================
if __name__ == "__main__":
    print("\n" + "=" * 55)
    print("    SISTEM KONTROL OTOMATIS: RL Q-Learning    ")
    print("=" * 55)

    if not os.path.exists(POLICY_FILE):
        print(f"[ERROR] File {POLICY_FILE} tidak ditemukan!")
        exit()

    with open(POLICY_FILE, "r") as f:
        policy_ai = json.load(f)
    print(f"[DATA] Memuat {len(policy_ai)} skenario kecerdasan AI.")

    client = mqtt.Client(mqtt.CallbackAPIVersion.VERSION2)
    client.on_connect, client.on_message = on_connect, on_message

    try:
        client.connect(MQTT_BROKER, MQTT_PORT, 60)
        client.loop_start()

        while True:
            with lock:
                if status == "DOSING" and time.time() > waktu_resend_next:
                    if retry_count < MAX_RETRIES:
                        print(
                            f"[RETRY] ESP32 tidak merespon. Mengirim ulang ID:{current_tx_id} "
                            f"(percobaan ke-{retry_count+1}/{MAX_RETRIES})..."
                        )
                        write_log(
                            "RETRY_ACTION", TOPICS["action"], f"resend {current_tx_id}"
                        )
                        push_action(tracking["act"], is_retry=True)
                        retry_count += 1
                    else:
                        print(
                            "[ERROR] ESP32 tidak merespon setelah 3 kali percobaan. Sistem HALT sementara."
                        )
                        status = "HALT"
            time.sleep(1)

    except KeyboardInterrupt:
        print("\n[STOP] Sistem dimatikan secara manual.")
        client.loop_stop()
        client.disconnect()

```

---

## BAGIAN 2: DATA EKSPERIMEN (.csv)

### `dataset_acak_qlearning.csv`

```
Sesi_Eksperimen,Cycle,pH_St,EC_St,Action,pH_St1,EC_St1,Delta_pH,Delta_EC,Timestamp
Sesi_1,1,7.88,0.0,6,7.5,16.18,-0.38,16.18,2026-04-16 03:53:06
Sesi_1,2,7.5,15.75,6,7.28,164.45,-0.22,148.7,2026-04-16 03:58:13
Sesi_1,3,7.27,161.58,8,7.28,192.45,0.01,30.87,2026-04-16 04:03:29
Sesi_1,4,7.29,191.18,4,6.27,216.83,-1.02,25.65,2026-04-16 04:08:34
Sesi_1,5,6.26,215.82,3,6.07,212.0,-0.19,-3.82,2026-04-16 04:13:37
Sesi_1,6,6.04,212.91,8,6.05,238.09,0.01,25.18,2026-04-16 04:18:52
Sesi_1,7,6.05,239.08,4,5.38,235.18,-0.67,-3.9,2026-04-16 04:23:58
Sesi_1,8,5.36,240.0,1,5.71,263.55,0.35,23.55,2026-04-16 04:29:00
Sesi_1,9,5.7,278.27,2,6.26,310.5,0.56,32.23,2026-04-16 04:34:06
Sesi_1,10,6.26,309.55,8,6.26,338.55,0.0,29.0,2026-04-16 04:39:21
Sesi_1,11,6.28,339.45,2,6.67,372.0,0.39,32.55,2026-04-16 04:44:27
Sesi_1,12,6.68,389.18,8,6.67,387.82,-0.01,-1.36,2026-04-16 04:49:42
Sesi_1,13,6.67,388.58,6,6.61,514.82,-0.06,126.24,2026-04-16 04:54:49
Sesi_1,14,6.62,513.0,4,6.23,512.25,-0.39,-0.75,2026-04-16 04:59:54
Sesi_1,15,6.21,513.09,8,6.19,511.09,-0.02,-2.0,2026-04-16 05:05:10
Sesi_1,16,6.22,512.67,1,6.38,512.09,0.16,-0.58,2026-04-16 05:10:13
Sesi_1,17,6.38,514.0,1,6.52,537.18,0.14,23.18,2026-04-16 05:15:15
Sesi_1,18,6.51,538.42,5,6.5,628.5,-0.01,90.08,2026-04-16 05:20:18
Sesi_1,19,6.49,642.36,7,6.48,712.18,-0.01,69.82,2026-04-16 05:25:23
Sesi_1,20,6.48,736.45,5,6.47,785.73,-0.01,49.28,2026-04-16 05:30:26
Sesi_1,21,6.47,798.08,1,6.59,811.91,0.12,13.83,2026-04-16 05:35:28
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
0.0000
0.0000
0.0000
0.0000
0.0000
0.0000
0.0000
0.0000
0.0000
0.0000
0.0000
0.0000
0.0000
0.0000
0.0000
0.0000
0.0000
0.0000
0.0000
0.0000
0.0000
0.0000
0.0000
9.8555
9.8555
9.8555
9.8555
9.8555
9.8555
9.8555
9.8555
9.8555
9.8555
9.8555
9.8555
9.8555
9.8555
39.3760
39.3760
39.3760
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

```

---
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
