samuelparlindungan/ML-Q-Learning/B100_TA_01_Revisi 3.docx

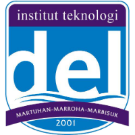
[picture p4: figure]
Image result for INSTITUT TEKNOLOGI DEL

| INSTITUT TEKNOLOGI DEL PROGRAM STUDI TEKNIK ELEKTRO Jl. Sisingamangaraja, Laguboti, Kabupaten Toba, Sumatera Utara 🕿 (0632) 331234, 🖷 (0632)331116

Dokumentasi Produk Tugas Akhir

Lembar Sampul Dokumen

Judul Dokumen | TUGAS AKHIR TEKNIK ELEKTRO: Design and Implementation of Q-Learning Control for pH and EC Stability with Real-Time Monitoring based on IoT
Jenis Dokumen | PROPOSAL
| Catatan: Dokumen ini dikendalikan penyebarannya oleh Prodi Teknik Elektro ITDel
Nomor Dokumen | B100- 01-TA25/26
Nomor Revisi | 01
Nama File | B100
Tanggal Penerbitan
Unit Penerbit | Prodi Teknik Elektro – ITDel
Jumlah Halaman | | (termasuk lembar sampul ini)

Data Pengusul
Pengusul | Nama | Josh Delon | | | Jabatan | | Anggota
| Tanggal | | | | Tanda Tangan
| Nama | SAMUEL P. | | | Jabatan | | Anggota
| Tanggal | | | | Tanda Tangan
| Nama | | | | Jabatan | | Anggota
| Tanggal | | | | Tanda Tangan
Pembimbing | Nama | Albert Sagala, S.T., M.T. | | | Jabatan Tanda Tangan | | Dosen Pembimbing 1
| Tanggal
| Nama Tanggal | | | | Jabatan Tanda Tangan | | Dosen Pembimbing 2
Lembaga | | | Tanggal 31 Oktober 2025

Program Studi Teknik Elektro

Fakultas Informatika dan Teknik Elektro

Institut Teknologi Del
Alamat

Jalan Sisingamangaraja, Laguboti, Kabupaten Toba, Sumatera Utara 22381
Telepon : +62 632 331234 | | | | Faks :+62 632 331116 | | Email:s1te@del.ac.id

# DAFTAR ISI

# Catatan Sejarah Perbaikan Dokumen

Versi, Tgl, Oleh | Perbaikan

# Proposal Proyek Design and Implementation of Q-Learning Control for pH and EC Stability with Real-Time Monitoring based on IoT

# 1 Pengantar

## 1.1 RINGKASAN ISI DOKUMEN

Dokumen ini menjelaskan tentang kebutuhan dasar untuk proyek “Design and Implementation of Q-Learning Control for pH and EC Stability with Real-Time Monitoring and Data Visualization based on IoT”. alam dokumen ini akan dilampirkan dan dijelaskan tentang tujuan penulisan, masalah dan tujuan yang melatarbelakangi proyek ini, mekanisme sistem dan karakteristik sistem yang akan dipakai dan dirancang. Pada dokumen ini juga, akan dijelaskan mengenai estimasi biaya, analisis aspek finansial, pemanfaatan sistem dan pengembangan sistem atau produk.

Secara spesifik, produk ini menggabungkan algoritma kecerdasan buatan Reinforcement Learning (Q-Learning) untuk pengendalian nutrisi otomatis yang adaptif, serta sistem monitoring mandiri berbasis IoT yang menyediakan visualisasi data real-time tanpa ketergantungan pada server pihak ketiga.

## 1.2 Tujuan Penulisan dan Aplikasi/Kegunaan Dokumen

Tujuan penulisan dokumen ini adalah sebagai berikut:

- Menguraikan latar belakang dan solusi integratif menjelaskan permasalahan ketidakstabilan parameter nutrisi pada sistem hidroponik konvensional serta mengusulkan solusi terintegrasi yang menggabungkan kecerdasan buatan (Reinforcement Learning) untuk pengendalian presisi dan sistem monitoring berbasis visualisasi data untuk pemantauan yang informatif dan andal.
- Menyajikan rancangan mekanisme sistem memaparkan mekanisme kerja sistem secara menyeluruh, mencakup algoritma Q-Learning dalam menentukan aksi dosing otomatis, serta alur pemrosesan data sensor pada unit pemrosesan mandiri (Standalone Processing Unit) yang menjamin keamanan data dan visualisasi secara real-time tanpa ketergantungan pada server eksternal.
- Menjelaskan kebutuhan komponen dan estimasi biaya merinci spesifikasi komponen perangkat keras dan perangkat lunak yang diperlukan, serta menyajikan analisis estimasi biaya produksi untuk mengimplementasikan sistem ini.
- Sebagai bahan evaluasi dalam aspek biaya yang dibutuhkan untuk merancang sistem kendali adaptif berbasis Reinforcement Learning dan infrastruktur monitoring dengan visualisasi data mandiri.

Dokumen ini ditujukan kepada dosen pembimbing tugas akhir dan tim tugas akhir Program Studi Teknik Elektro ITDel sebagai bahan penilaian tugas akhir.

## 1.3 REFERENSI

[1] H. Sulaiman, A. A. Yusof, and M. K. Mohamed Nor, “Automated Hydroponic Nutrient Dosing System: A Scoping Review of pH and Electrical Conductivity Dosing Frameworks,” Feb. 01, 2025, Multidisciplinary Digital Publishing Institute (MDPI). doi: 10.3390/agriengineering7020043.

[2] C. Panjapornpon, P. Chinchalongporn, S. Bardeeniz, R. Makkayatorn, and W. Wongpunnawat, “Reinforcement Learning Control with Deep Deterministic Policy Gradient Algorithm for Multivariable pH Process,” Processes, vol. 10, no. 12, Dec. 2022, doi: 10.3390/pr10122514.

[3] Y. Cai et al., “Smart Nutrient Solution Temperature Control System for Oversummering Lettuce Cultivation Based on Adaptive Dung Beetle Optimizer-Fuzzy PID,” Applied Sciences (Switzerland), vol. 15, no. 10, May 2025, doi: 10.3390/app15105381.

[4] A. M. Ridwan, A. S. Milah, L. Kamelia, and M. R. Renaldi Gunawan, “Sistem Kendali Fuzzy Logic untuk Kestabilan pH dan EC Nutrisi Pada Hidroponik,” Jurnal Teknologi Elektro, vol. 15, no. 3, p. 152, Jun. 2025, doi: 10.22441/jte.2024.v15i3.002.

[5] P. Catota-Ocapana, C. Minaya-Andino, P. Astudillo, and D. Pichoasamin, “Smart Control Models Used for Nutrient Management in Hydroponic Crops: A Systematic Review,” 2025, Institute of Electrical and Electronics Engineers Inc. doi: 10.1109/ACCESS.2025.3526171.

[6] S. Dakshinamurthy and B. Mohan, “Adaptive Control of Smart Hydroponic Systems Using Reinforcement Learning: A Comparative Study with PID,” 2024. doi: https://doi.org/10.36948/ijfmr.2025.v07i03.42424.

[7] C. Lukito, R. B. Lukito, and E. Ernawati, “Implementation of IoT Edge Computing for Control and Monitoring System of Hydroponic Plant Water Quality Using Raspberry Pi,” International Journal of Computer Science and Humanitarian AI, vol. 1, no. 1, pp. 25–32, 2024, doi: 10.21512/ijcshaijournal.v1i1.12153.

[8] P. Yu, F. Teng, W. Zhu, C. Shen, Z. Chen, and J. Song, “Cloud–edge–device collaborative computing in smart agriculture: architectures, applications, and future perspectives,” 2025, Frontiers Media SA. doi: 10.3389/fpls.2025.1668545.

[9] K. Tatas et al., “Reliable IoT-Based Monitoring and Control of Hydroponic Systems,” Technologies (Basel), vol. 10, no. 1, Feb. 2022, doi: 10.3390/technologies10010026.

[10] C. H. Chen, S. Y. Jeng, and C. J. Lin, “Fuzzy Logic Controller for Automating Electrical Conductivity and pH in Hydroponic Cultivation,” Applied Sciences (Switzerland), vol. 12, no. 1, Jan. 2022, doi: 10.3390/app12010405.

[11] S. Jain and M. Kaur, “Design and Implementation of an IoT-based automated EC and pH Control System in an NFT-based Hydroponic Farm,” Engineering, Technology and Applied Science Research, vol. 14, no. 1, pp. 13078–13081, Feb. 2024, doi: 10.48084/etasr.6393.

[12] U. Shareef, A. U. Rehman, and R. Ahmad, “A Systematic Literature Review on Parameters Optimization for Smart Hydroponic Systems,” Sep. 01, 2024, Multidisciplinary Digital Publishing Institute (MDPI). doi: 10.3390/ai5030073.

[13] A. Abu Sneineh and A. A. A. Shabaneh, “Design of a smart hydroponics monitoring system using an ESP32 microcontroller and the Internet of Things,” MethodsX, vol. 11, Dec. 2023, doi: 10.1016/j.mex.2023.102401.

[14] W. Muhammad, L. Faridah, and S. Sutisna, “AUTOMATED NUTRIENT CONTROL AND MONITORING SYSTEM FOR INTERNET OF THINGS (IOT)-BASED HYDROPONIC TOWERS,” Jurnal Informatika dan Teknik Elektro Terapan, vol. 13, no. 3S1, Oct. 2025, doi: 10.23960/jitet.v13i3S1.8101.

[15] P. Yu, F. Teng, W. Zhu, C. Shen, Z. Chen, and J. Song, “Cloud–edge–device collaborative computing in smart agriculture: architectures, applications, and future perspectives,” 2025, Frontiers Media SA. doi: 10.3389/fpls.2025.1668545.

## 1.4 DAFTAR SINGKATAN

Singkatan | Arti
ITDel | Institut Teknologi Del
RL | Reinforcement Learning
pH | Potential of Hydrogen
EC | Electrical Conductivity
MCU | Micro Controller Unit
AI | Artificial Intelligence
IoT | Internet of Things
PID | Proportional-Integral-Derivative
TA | Tugas Akhir

# 2 PROPOSAL PENGEMBANGAN PRODUK TEKNOLOGI

## 2.1 MASALAH DAN TUJUAN

Keberhasilan sistem budidaya hidroponik sangat bergantung pada presisi parameter larutan nutrisi, khususnya derajat keasaman (pH) dan konduktivitas listrik (EC), yang secara langsung mempengaruhi penyerapan unsur hara oleh tanaman. Namun, menjaga stabilitas kedua parameter ini menghadapi tantangan teknis karena karakteristik proses kimia air yang sangat non-linear, time-varying, dan memiliki interaksi silang (coupling) yang kuat antara pH dan konsentrasi nutrisi [1], [2]. Metode pengendalian konvensional seperti PID (Proportional-Integral-Derivative) sering kali memiliki keterbatasan dalam menangani dinamika ini; studi terbaru menunjukkan bahwa kontroler PID cenderung kaku dan menghasilkan overshoot yang tinggi serta waktu penyelesaian (settling time) yang lambat ketika terjadi gangguan lingkungan [3]. Selain itu, metode seperti Fuzzy Logic sangat bergantung pada aturan pakar yang statis dan tidak memiliki kemampuan belajar untuk beradaptasi terhadap perubahan kondisi alat seiring waktu [4], [5].

Untuk mengatasi keterbatasan tersebut, penelitian ini menerapkan pendekatan kontrol cerdas menggunakan algoritma Reinforcement Learning (Q-Learning). Berbeda dengan PID, Q-Learning merupakan metode model-free yang memungkinkan sistem belajar kebijakan dosing (durasi pompa) secara mandiri melalui interaksi trial-and-error dengan lingkungan untuk mencapai target yang optimal. Penelitian komparatif menunjukkan bahwa pendekatan berbasis Reinforcement Learning mampu meningkatkan efisiensi penggunaan sumber daya hingga 10% dan hasil panen sebesar 12,5% dibandingkan kontroler PID konvensional karena kemampuannya beradaptasi secara dinamis [6].

Namun, penerapan algoritma kontrol cerdas ini menuntut infrastruktur data yang andal dan responsif. Sistem monitoring hidroponik konvensional yang bergantung sepenuhnya pada Cloud Computing sering menghadapi masalah latensi jaringan dan risiko kegagalan sistem kontrol saat koneksi internet tidak stabil [7]. Oleh karena itu, diperlukan integrasi arsitektur Edge Computing. Dengan menempatkan komputasi pada Edge (Raspberry Pi), sistem dapat memproses data sensor dan menjalankan algoritma Q-Learning secara lokal dengan latensi yang sangat rendah (turun dari ~257ms menjadi ~10ms), menjamin respons aktuator yang real-time [7]. Sementara itu, lapisan jaringan difokuskan untuk akses visualisasi data jarak jauh yang aman melalui secure tunneling tanpa membebani proses kontrol kritis [8].

Berdasarkan permasalahan di atas, tujuan utama dari penelitian Tugas Akhir ini adalah merancang bangun sistem hidroponik cerdas yang terintegrasi. Secara spesifik, penelitian ini bertujuan untuk mengimplementasikan algoritma Q-Learning guna mengendalikan pH dan EC secara adaptif demi meminimalkan error dan osilasi, serta mengembangkan arsitektur Edge Computing yang membagi beban kerja antara node sensor (ESP32) dan Edge Server (Raspberry Pi) untuk menjamin keandalan data. Selain itu, penelitian ini juga menyediakan antarmuka monitoring berbasis web yang menampilkan status nutrisi dan kinerja sistem secara real-time untuk memudahkan evaluasi dan pemeliharaan.

## 2.2 ANALISIS UMUM

Proyek ini mengeksplorasi penggunaan algoritma Q-Learning, salah satu metode fundamental dalam Reinforcement Learning (RL), untuk mengotomatiskan kontrol pH dan EC dalam sistem hidroponik. Q-Learning adalah algoritma model-free yang belajar nilai dari pasangan state-action (nilai Q) melalui interaksi coba-coba dengan lingkungan, dipandu oleh reward [6]. Pendekatan ini menarik karena tidak memerlukan model matematis yang kompleks dari dinamika pH dan EC dalam sistem hidroponik, yang seringkali sulit diperoleh secara akurat [6], [9]. Q-Learning berpotensi menemukan strategi kontrol yang efektif hanya berdasarkan observasi (state) dan konsekuensi dari aksi (reward).

Namun, penerapan Q-Learning standar (yang menggunakan tabel Q) menghadapi tantangan signifikan dalam konteks ini. Parameter pH dan EC adalah variabel kontinu, demikian pula dengan durasi aktivasi pompa yang idealnya bisa bervariasi secara halus untuk presisi dosing [10]. Q-Learning standar dirancang untuk ruang state dan action yang diskrit [6]. Oleh karena itu, implementasi langsung memerlukan diskritisasi, yaitu membagi rentang nilai pH, EC, dan durasi pompa menjadi sejumlah interval atau level terbatas [4], [6]. Proses diskritisasi ini membawa trade-off jika interval terlalu lebar, presisi kontrol akan berkurang jika interval terlalu sempit, ukuran tabel Q akan menjadi sangat besar (masalah curse of dimensionality), membuat proses pembelajaran menjadi lambat atau bahkan tidak praktis [6]. Meskipun Q-Learning telah diterapkan dalam kontrol pH [6], presisi yang dapat dicapai mungkin terbatas oleh tingkat diskritisasi yang dipilih.

Alternatif untuk mengatasi batasan state kontinu adalah menggunakan Q-Learning dengan function approximation, seperti Deep Q-Networks (DQN), di mana nilai Q diestimasi oleh jaringan saraf [6]. Namun, DQN standar masih menghasilkan aksi diskrit. Mengingat keterbatasan ini, analisis umum menunjukkan bahwa Q-Learning (baik standar maupun dengan adaptasi) mungkin lebih mudah diimplementasikan secara konseptual dibandingkan algoritma aksi kontinu seperti Deep Deterministic Policy Gradient (DDPG) [6], tetapi efektivitasnya dalam mencapai "kontrol presisi" akan sangat bergantung pada bagaimana tantangan diskritisasi state dan action ditangani. Proyek ini akan mengimplementasikan Q-Learning (kemungkinan dengan diskritisasi), menganalisis kinerjanya, dan membandingkannya dengan PID untuk memahami secara praktis kapabilitas dan keterbatasannya dalam aplikasi kontrol hidroponik ini [6], [11], [12].

Selain aspek kontrol, sistem hidroponik modern menuntut adanya infrastruktur monitoring real-time yang mampu menyediakan data sensor yang akurat, historis, dan mudah diakses untuk mendukung evaluasi kinerja kontrol. Oleh karena itu, proyek ini juga mengintegrasikan sistem Internet of Things (IoT) berbasis arsitektur Edge Computing untuk memantau variabel pH, EC, dan level air secara berkelanjutan. Node ESP32 bertindak sebagai edge device yang membaca data sensor dan mengirimkan data melalui protokol MQTT menuju Raspberry Pi sebagai edge gateway. Raspberry Pi menjalankan Telegraf sebagai data collector, InfluxDB sebagai basis data time-series, dan Grafana sebagai platform visualisasi. Pendekatan ini mengikuti praktik sistem monitoring hidroponik modern yang menekankan pemrosesan edge untuk mengurangi latensi dan meningkatkan keandalan [13], [14].

Arsitektur Edge Computing memungkinkan pengguna mengakses dashboard secara aman melalui mekanisme Cloudflare HTTPS untuk memantau sensor, histori data, performa jaringan, serta respon sistem terhadap aksi RL. Integrasi monitoring ini sangat penting untuk melakukan performance validation, seperti mengukur latensi komunikasi, kestabilan broker MQTT, dan akurasi sensor terhadap pembacaan referensi. Banyak studi menegaskan bahwa integrasi kontrol otomatis dan monitoring berbasis cloud dapat meningkatkan efisiensi dan kualitas keputusan dalam sistem pertanian presisi [9], [15].

## 2.3 KARAKTERISTIK PRODUK

Produk yang dikembangkan adalah prototipe sistem kendali skala laboratorium (Laboratory Scale Prototype) dengan kapasitas tandon 15 Liter. Sistem ini dirancang untuk mensimulasikan logika kontrol otomatis menggunakan algoritma Q-Learning pada lingkungan terbatas, bukan untuk implementasi industri perkebunan luas. Karena kemampuannya belajar dari interaksi tanpa model, sistem ini difokuskan untuk menemukan kebijakan dosing yang efektif pada volume air terkecil yang terkendali, meskipun dengan potensi keterbatasan presisi akibat sifat diskrit algoritma.

- Fitur Utama Kontrol Q-Learning:

Menggunakan algoritma O-Learning untuk mempelajari nilai dari setiap kombinasi state (kondisi pH/EC yang didiskritisasi) dan action (dosing yang didiskritisasi).

- Fitur Dasar Sistem:
- Input Sensor, menerima data dari sensor pH dan sensor EC, di mana nilai kontinu dari sensor ini kemudian didiskritisasi menjadi lima kategori level (yaitu: Very Low, Low, Optimal, High, dan Very High) untuk membentuk ruang keadaan (State-Space) bagi agen Q-Learning.
- Input Sensor Level Cairan, menggunakan sensor ultrasonik yang dipasang pada tandon utama serta pada masing-masing botol stok larutan (Nutrisi, pH, dan Air). Data level ini digunakan sebagai logika pengaman (safety interlock) untuk mencegah aktivasi pompa saat cairan habis dan untuk memantau sisa stok via dashboard.
- Platform Komputasi dan Komunikasi.
- Raspberry Pi, sebagai unit pemrosesan utama yang menjalan algoritma Q-Learning inti dan logika pengambilan keputusan. Raspberry Pi memiliki kemampuan komputasi yang memadai untuk tugas Q-Learning dan mengelola komunikasi MQTT. Pi akan menerima data sensor dari MCU publisher dan mengirimkan perintah kontrol ke MCU subscriber melalui protokol MQTT.
- MCU Publisher: Sebuah MCU (Microcontroller Unit) bertugas membaca data dari Sensor pH dan Sensor EC secara berkala, kemudian memublikasikan (publish) data tersebut ke broker MQTT.
- MCU Subscriber: Sebuah MCU bertugas berlangganan (subscribe) perintah kontrol dari Raspberry Pi melalui broker MQTT. Setelah menerima perintah, MCU ini akan mengendalikan aktuator pompa peristaltik dan menjalankan logika pengaman level cairan.
- Algoritma Inti, yang merupakan implementasi algoritma Q-Learning pada Raspberry Pi untuk memperbarui nilai Q dalam tabel berdasarkan reward yang diterima setelah melakukan aksi dosing.
- Output Kontrol, berupa pemilihan perintah dosing dari sejumlah opsi durasi yang telah ditentukan sebelumnya, seperti “menyalakan Pompa X selama 5 detik”, “menyalakan Pompa Y selama 10 detik”, atau “tidak melakukan tindakan apa pun”. Pemilihan aksi dilakukan berdasarkan nilai Q tertinggi pada kondisi (state) saat ini, kemudian perintah tersebut dikirim ke sistem eksekusi melalui protokol MQTT.
- Aktuator yang mengendalikan lima unit pompa peristaltik, yang terdiri dari pompa pH Up, pompa pH Down, dua pompa untuk stok Nutrisi (A dan B), serta satu pompa untuk penambahan Air Baku. Pengoperasian pompa dilakukan melalui modul relay yang dikendalikan oleh MCU subscriber berdasarkan perintah durasi (dosing) dari agen Q-Learning dan validasi dari logika pengaman level cairan.
- Sifat solusi yang diharapkan dari Sistem Kontrol Q-Learning:
- Otomatis yang mampu mengatur pH dan EC secara mandiri tanpa intervensi manual berkelanjutan
  - Adaptif meski terbatas diharapkan mampu menyesuaikan kebijakan seiring waktu berdasarkan reward, meskipun adaptasinya mungkin lebih lambat dibandingkan dengan metode aksi kontinu.
  - Fitur Sistem IoT dan Monitoring:
- Sensor Monitoring: pH, EC, dan level cairan air.
- Edge Processing: ESP32 membaca data sensor dan mengirimkan ke broker MQTT di Raspberry Pi.
- Data Management: Raspberry Pi menjalankan Telegraf dan InfluxDB untuk menyimpan data.
- Visualization Layer: Dashboard Grafana menampilkan data real-time dan historis.
- Cloud Access: Cloudflare Tunnel digunakan untuk akses jarak jauh yang aman.
- Performance Evaluation: Sistem mengukur latensi, stabilitas koneksi, dan akurasi sensor.

## 2.4 PERKIRAAN BIAYA PRODUKSI

Perkiraan biaya yang akan diperlukan untuk mengembangkan produk ......akan disajikan melalui tabel berikut. Adapun biaya yang perlu dihitung, antara lain :

1. Biaya produk

Tabel Estimasi Biaya Produk

Material | Kuantitas | Harga Satuan | Harga
Sensor pH | 1 | Rp 915.000,00 | Rp 915.000,00
Sensor EC | 1 | Rp 1.600.000,00 | Rp 1.600.000,00
Sensor Ultrasonic | 6 | Rp 20.000,00 | Rp 120.000,00
Analog Signal Isolator | 1 | Rp 425.000,00 | Rp 425.000,00
Raspberry Pi 4 | 1 | Rp 1.350.000,00 | Rp 1.350.000,00
ESP 32 | 2 | Rp 95.000,00 | Rp 190.000,00
ESP 32 Expansion | 2 | Rp 40.000,00 | Rp 80.000,00
Relay 6 Channel 5V | 1 | Rp 50.000,00 | Rp 50.000,00
Pompa Peristaltik 12V | 5 | Rp 125.000,00 | Rp 625.000,00
Power Supply 12V 10A | 1 | Rp 80.000,00 | Rp 80.000,00
Total Biaya | Rp 5.435.000,00

2. Biaya rekayasa

Perhitungan biaya rekayasa dilakukan dengan asumsi pengembangan produk dilakukan oleh sebuah tim mahasiswa setara startup dengan 2 orang engineer. Waktu pengerjaan proyek diperkirakan selama 5 bulan dengan alokasi waktu per minggu 40 jam. Diasumsikan tarif satu jam engineer bekerja adalah upah Rp15.000,00. Sehingga untuk menyelesaikan produk ini dibutuhkan biaya sebesar Rp6.000.000,00.

## 2.5 Analisis Finansial

Sistem hidroponik terintegrasi berbasis Q-Learning dan IoT Edge Computing ini memiliki potensi untuk dipasarkan kepada berbagai segmen, seperti petani hidroponik skala kecil hingga menengah, institusi pendidikan, pegiat hobi, maupun peneliti pemula yang membutuhkan solusi otomatisasi nutrisi yang terjangkau. Kombinasi teknologi Q-Learning dan IoT memberikan keunggulan berupa kemampuan kontrol pH dan EC secara otomatis, stabil, serta dapat dipantau secara real-time melalui dashboard berbasis web.

Dari sisi operasional, sistem ini mampu mengurangi kebutuhan pengecekan manual dan dosing nutrisi secara konvensional, sehingga menekan beban kerja pengguna serta meningkatkan konsistensi parameter larutan. Penggunaan kontrol berbasis Q-Learning juga meningkatkan adaptabilitas sistem terhadap dinamika perubahan pH dan EC dibandingkan kontrol manual.

Estimasi biaya perangkat keras utama untuk pengembangan satu unit prototipe berada di kisaran Rp 5.435.000,00, yang mencakup mikrokontroler, sensor pH dan EC, aktuator dosing, modul komunikasi, serta perangkat pendukung lainnya. Sementara itu, biaya pengembangan perangkat lunak termasuk integrasi IoT, perancangan dashboard, serta implementasi algoritma Q-Learning perlu dihitung secara terpisah, terutama jika sistem ini akan dikembangkan sebagai solusi komersial. Nilai akhirnya akan bergantung pada kompleksitas fitur, proses kalibrasi, dan skala produksi.

## 2.6 SKENARIO PEMANFAATAN PRODUK

Produk ini dimanfaatkan secara spesifik sebagai alat peraga edukasi dan riset (Research & Educational Kit) untuk laboratorium sistem kendali cerdas. Fungsi utamanya adalah mendemonstrasikan penerapan algoritma Reinforcement Learning (Q-Learning) dalam menjaga stabilitas parameter pH dan EC pada skala volume terkecil yang terkendali (15 Liter). Sistem ini dirancang untuk lingkungan laboratorium pendidikan, bukan untuk menggantikan sistem irigasi pada greenhouse komersial skala menengah atau industri vertical farming yang membutuhkan debit fluida besar.

Pihak yang paling potensial memanfaatkan produk ini adalah Institusi Pendidikan Vokasi dan Program Studi Teknik yang membutuhkan modul praktikum IoT dan AI. Bagi mahasiswa dan peneliti, alat ini menyediakan transparansi data melalui dashboard visual (Grafana) untuk memvalidasi perilaku agen cerdas dalam mengambil keputusan dosing, tanpa risiko kerugian biologis pada tanaman skala produksi massal. Target pengguna utama adalah teknisi laboratorium dan mahasiswa yang mempelajari sistem kendali terdistribusi, bukan petani komersial skala industri.

## 2.7 SKENARIO PENGEMBANGAN PRODUKSI DAN PEMASARAN

Produksi sistem ini dapat dikembangkan lebih lanjut dengan meningkatkan kapabilitas algoritma dari Tabular Q-Learning menuju Deep Reinforcement Learning (DRL) untuk presisi kendali yang lebih halus (kontinu), serta integrasi Computer Vision untuk memantau kesehatan fisik tanaman secara visual. Dari sisi perangkat keras, pengembangan akan mengarah pada penggunaan Custom PCB berstandar industri untuk menekan biaya produksi massal.

Untuk pemasaran, target utamanya adalah institusi pendidikan (SMK Pertanian/Teknik) sebagai alat edukasi riset, serta industri agrikultur komersial yang membutuhkan sistem kendali andal yang tetap beroperasi meskipun koneksi internet terputus (Edge Computing reliability). Strategi pemasaran akan menonjolkan keunggulan keamanan data (Zero Trust) dan efisiensi nutrisi dibandingkan sistem IoT konvensional.

## 2.8 KESIMPULAN DAN RINGKASAN

Melalui pengembangan 'Sistem Kontrol Adaptif pH dan EC Berbasis Q-Learning dan Arsitektur IoT Edge Computing', penelitian ini diharapkan mampu mengatasi dinamika non-linear larutan nutrisi secara otonom serta menjamin integritas data tanpa ketergantungan pada server pihak ketiga. Integrasi ini tidak hanya meningkatkan efisiensi penggunaan nutrisi dan meminimalkan risiko kegagalan panen, tetapi juga mempercepat pengambilan keputusan melalui pemantauan real-time yang aman dan mandiri (standalone), sehingga menghasilkan keuntungan jangka panjang dan keberlanjutan produksi bagi pelaku industri hidroponik modern.".

# 3 Lampiran

Personal Information

Full Name : Josh Delon

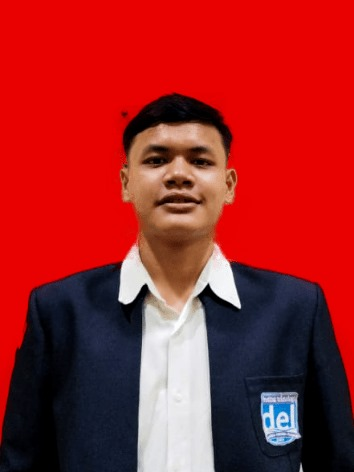
[picture p5: figure]

Gender : Male

Birth Place andDate : Laguboti, 11 Oktober 2004

Nationality : Indonesia

Religion : Christian Protestant

Phone Number : 082261022927

Email : joshdelon990@gmail.com

Academic Status

University: Institut Teknologi Del

Major :Electrical Engineering

Semester :7th

Education

Institutions | City and Province | Year
Institut Teknologi Del | Laguboti, North Sumatera | 2022-present

Personal Achievements

Awards | Year | Description

Supporting Activities and Trainings

Activities and Trainings | Period | Place

Organizational Experience

Organizations | Title | Period | Descriptions
Member Deliberation Council (HME IT Del) | Leader | Oktober 2024 - Present

Student Association of Electrical Engineering (HME) | Member | November 2022 - Present

Work Experience

Work | Year | Description
Electronic and Mechanical Production Staff | 2025 | Electronic and Mechanical Production Staff at PT. Helber Elektronika Indonesia
Internship Trine Statistics and Cryptography Division | 2021 | Internship Trine at Kominfo Toba

Skills and Hobbies

Language Skills : Indonesian (Native), English (Intermediate)

Computer Skills : Ms Word. Proteus, Arduino IDE, Python, Computer Maintenance, Cisco Packet Tracer, Linux

Hobbies and interests : Badminton, Music, Travelling

Personal Information

Full Name : SAMUEL P.

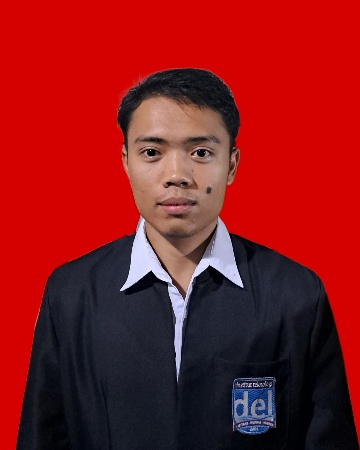
[picture p6: figure]

Gender : Male

Birth Place and Date : Sei Buatan, 10 January 2003

Nationality : Indonesia

Religion : Christian Protestant

Phone Number : 082352297148

Email : samuelparlin3321@gmail.com

Academic Status

University: Institut Teknologi Del

Major :Electrical Engineering

Semester :7th

Education

Institutions | City and Province | Year
Institut Teknologi Del | Laguboti, North Sumatera | 2022-present

Personal Achievements

Awards | Year | Description

Supporting Activities and Trainings

Activities and Trainings | Period | Place

Organizational Experience

Organizations | Title | Period | Descriptions
Student Association of Electrical Engineering (HME) | Member | November 2022 - Present

Work Experience

Work | Year | Description
Engineering Division | 2025 | Field Engineer at PT Solar Energy Power

Skills and Hobbies

Language Skills | : Indonesian (Native), English (Intermediate), Deutsch (Beginner)
Computer Skills | : Ms Word. . Ms Excel. C Language, Arduino IDE, Python, Cisco Packet Tracer, Linux
Hobbies and interests | Badminton, Solving logic puzzles or Sudoku and Playing music

Nomor Dokumen: B100-01-TA2025 Nomor Revisi: Tanggal: Halaman 1 dari 2 © 2020Prodi Teknik Elektro-ITDel. Pengungkapan dan penggunaan seluruh isi dokumen hanya dapat dilakukan atas ijin tertulisProdi Teknik Elektro -ITDel Laguboti, 22381 Indonesia.
