samuelparlindungan/ML-Q-Learning/output/output_grafik/gambar_4_1_reward.png

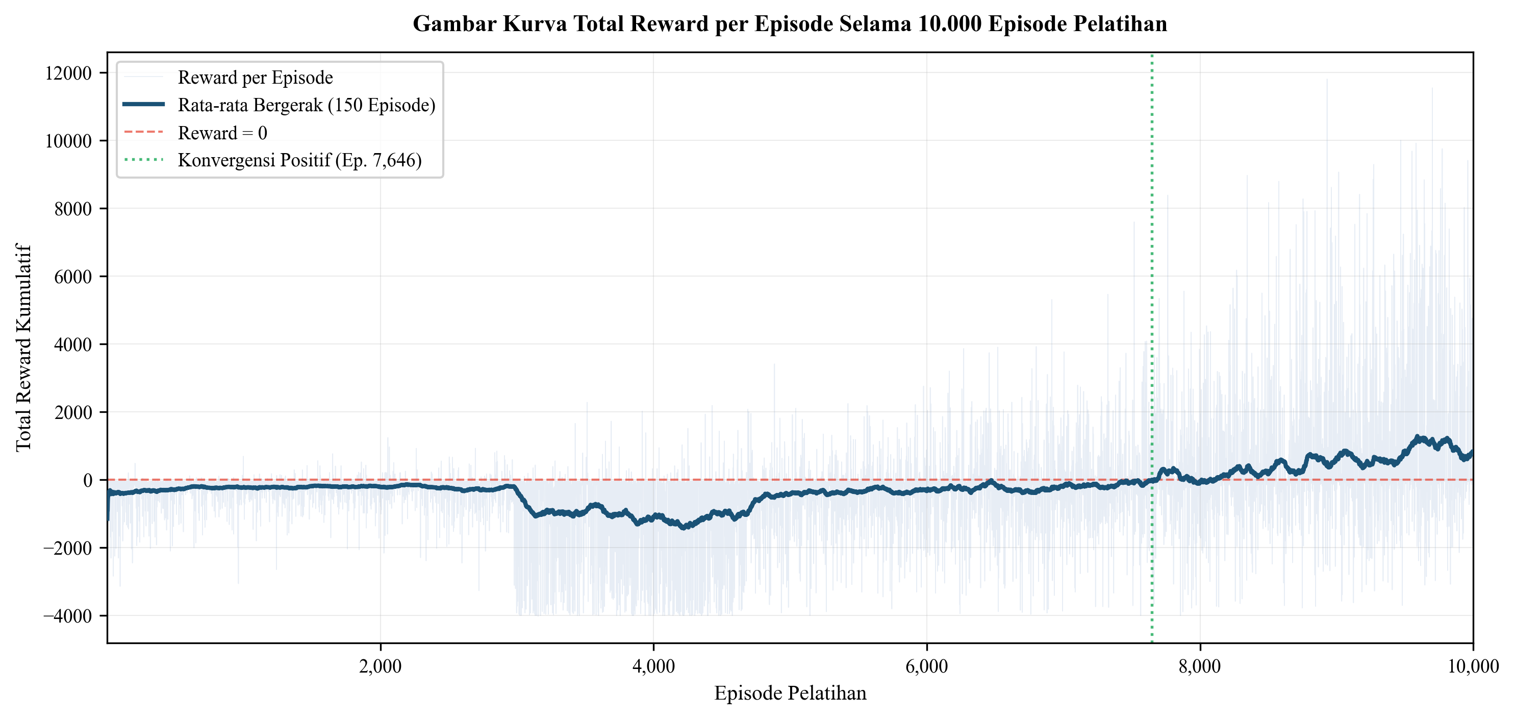
output/output_grafik/gambar_4_1_reward.png
