samuelparlindungan/ML-Q-Learning/output/output_grafik/gambar_4_3_respon.png

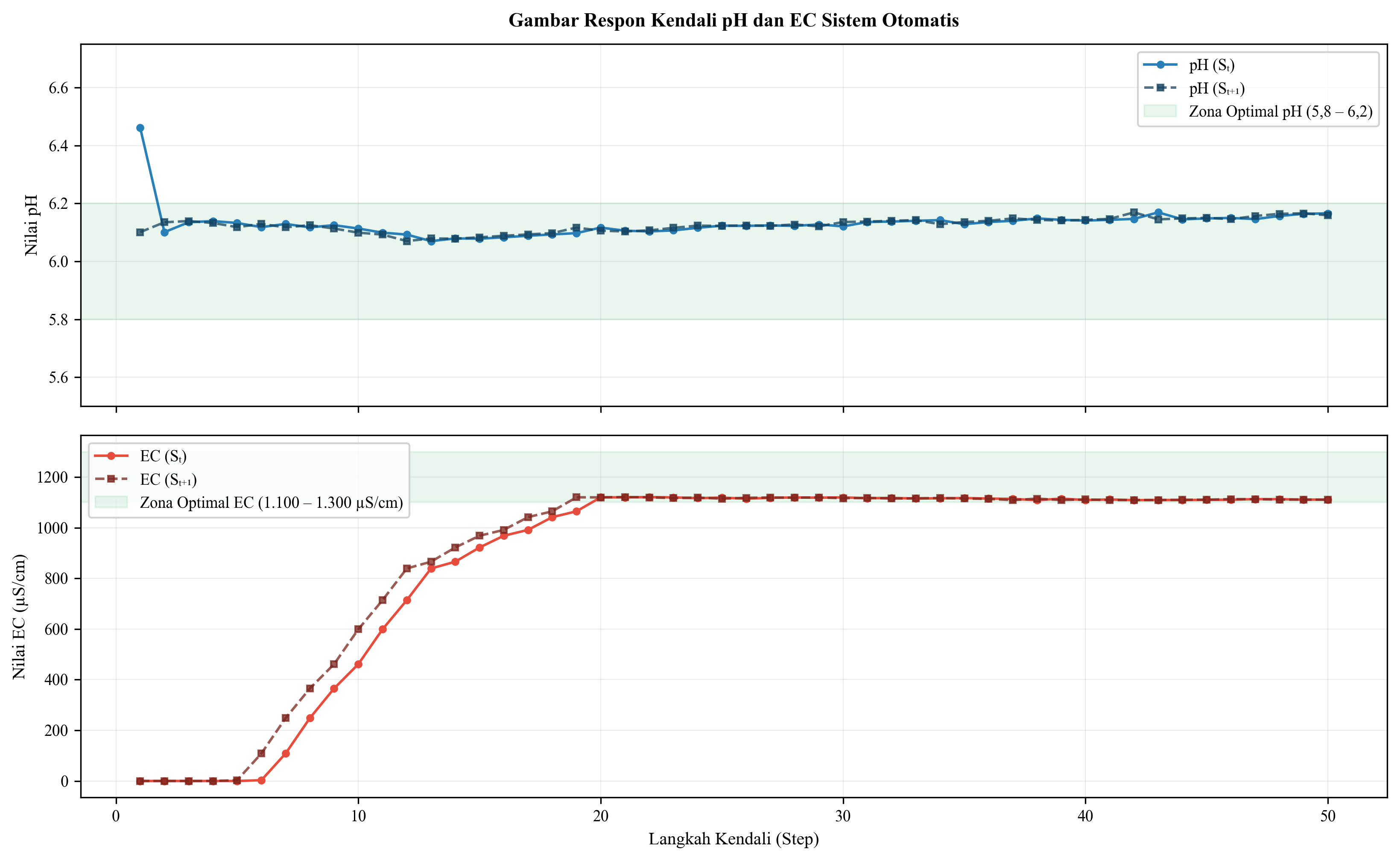
output/output_grafik/gambar_4_3_respon.png
