samuelparlindungan/ML-Q-Learning/output/output_grafik/gambar_4_4_state_dist.png

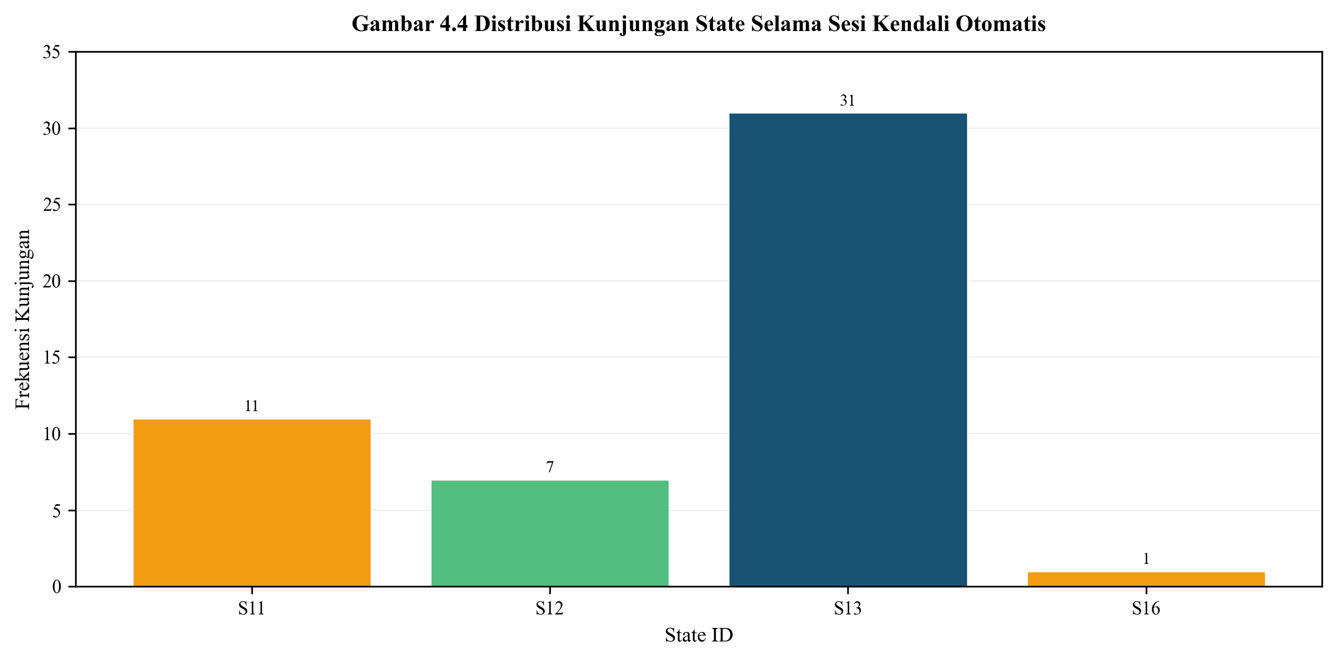
output/output_grafik/gambar_4_4_state_dist.png
