samuelparlindungan/ML-Q-Learning/output/output_grafik_qtable/qtable_best_action_per_state.png

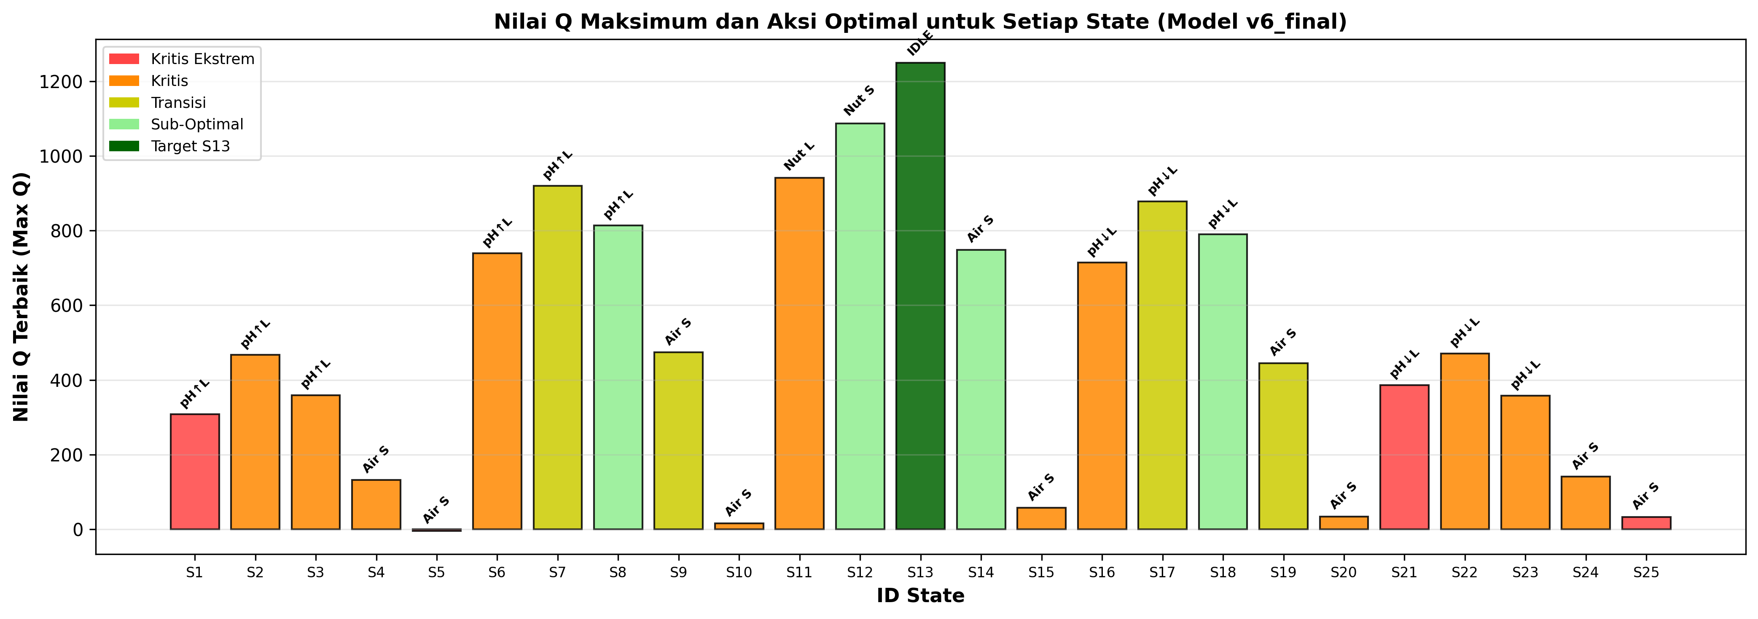
output/output_grafik_qtable/qtable_best_action_per_state.png
