samuelparlindungan/ML-Q-Learning/output/output_grafik_qtable/qtable_heatmap_nilai.png

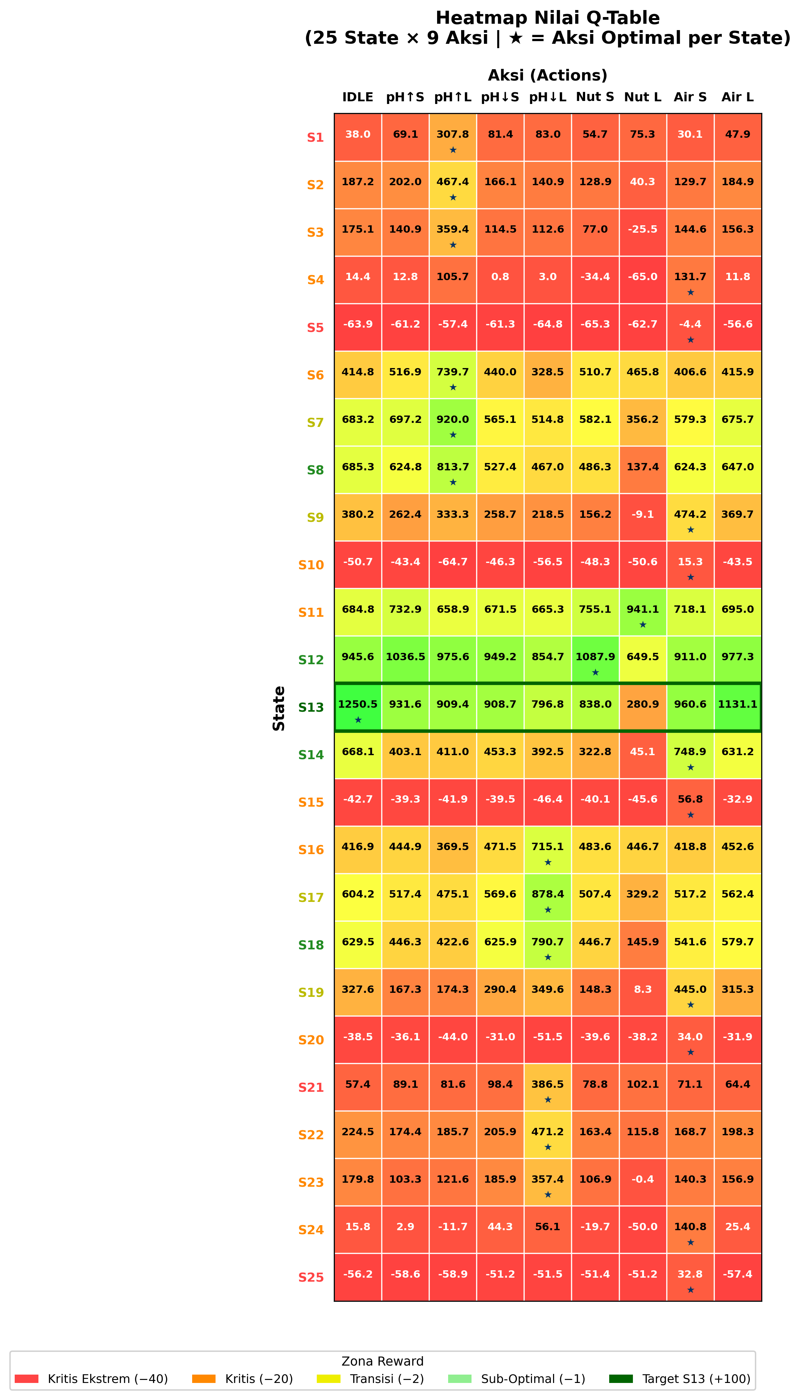
output/output_grafik_qtable/qtable_heatmap_nilai.png
