samuelparlindungan/ML-Q-Learning/output/output_grafik_qtable/qtable_tabel_bersih.png

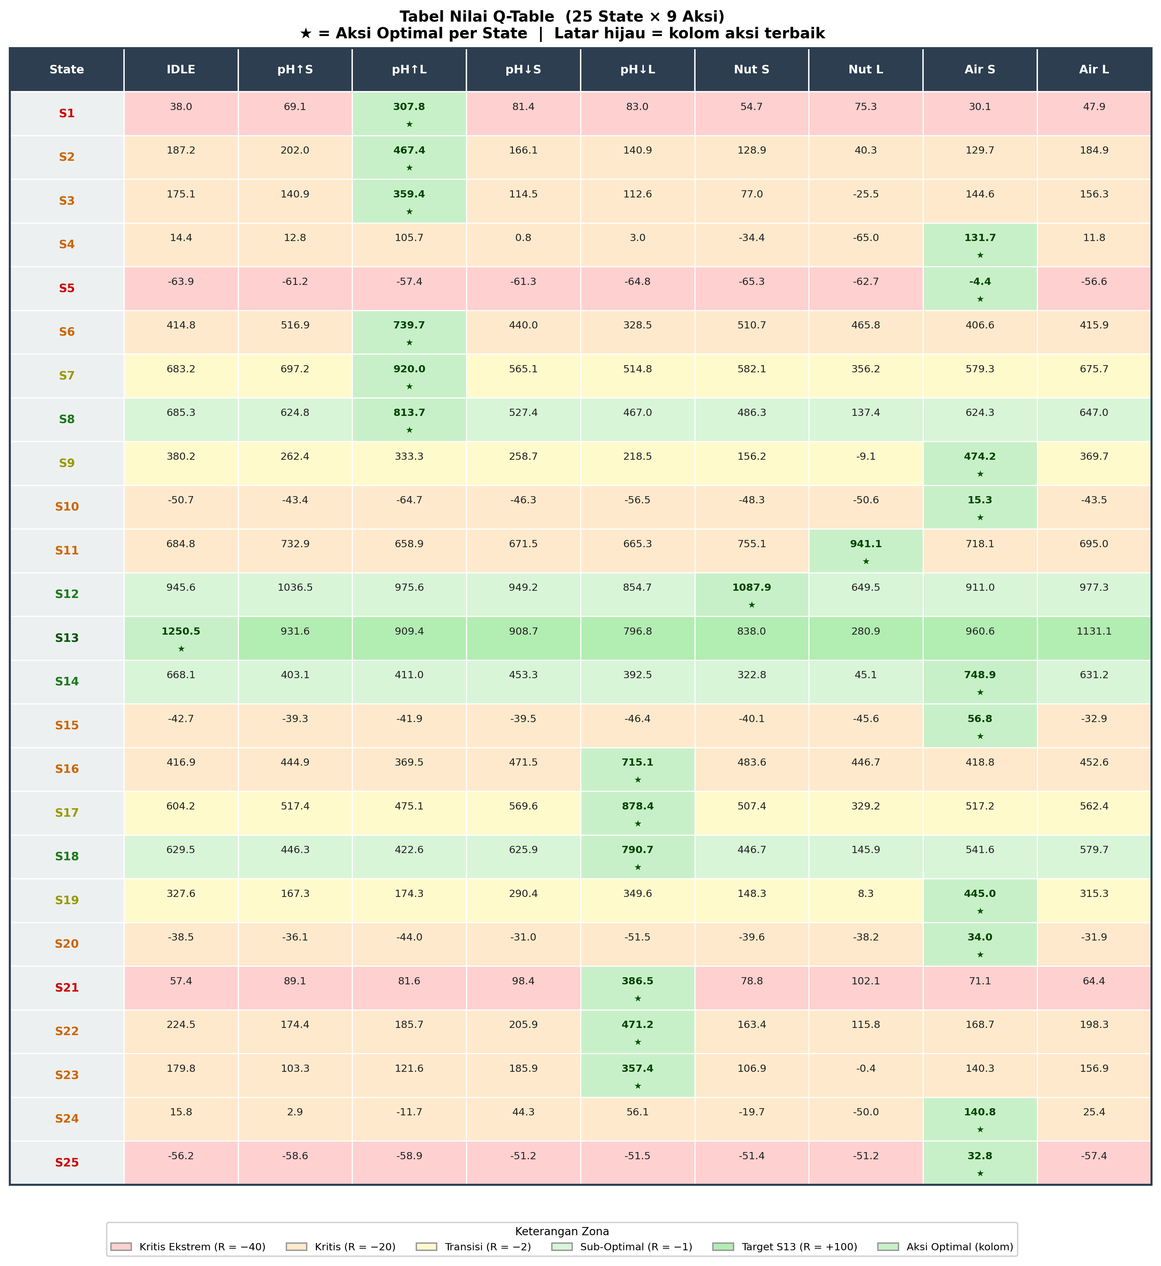
output/output_grafik_qtable/qtable_tabel_bersih.png
