samuelparlindungan/ML-Q-Learning/output/output_grafik_transisi/gambar_4_9_state_line_path.png

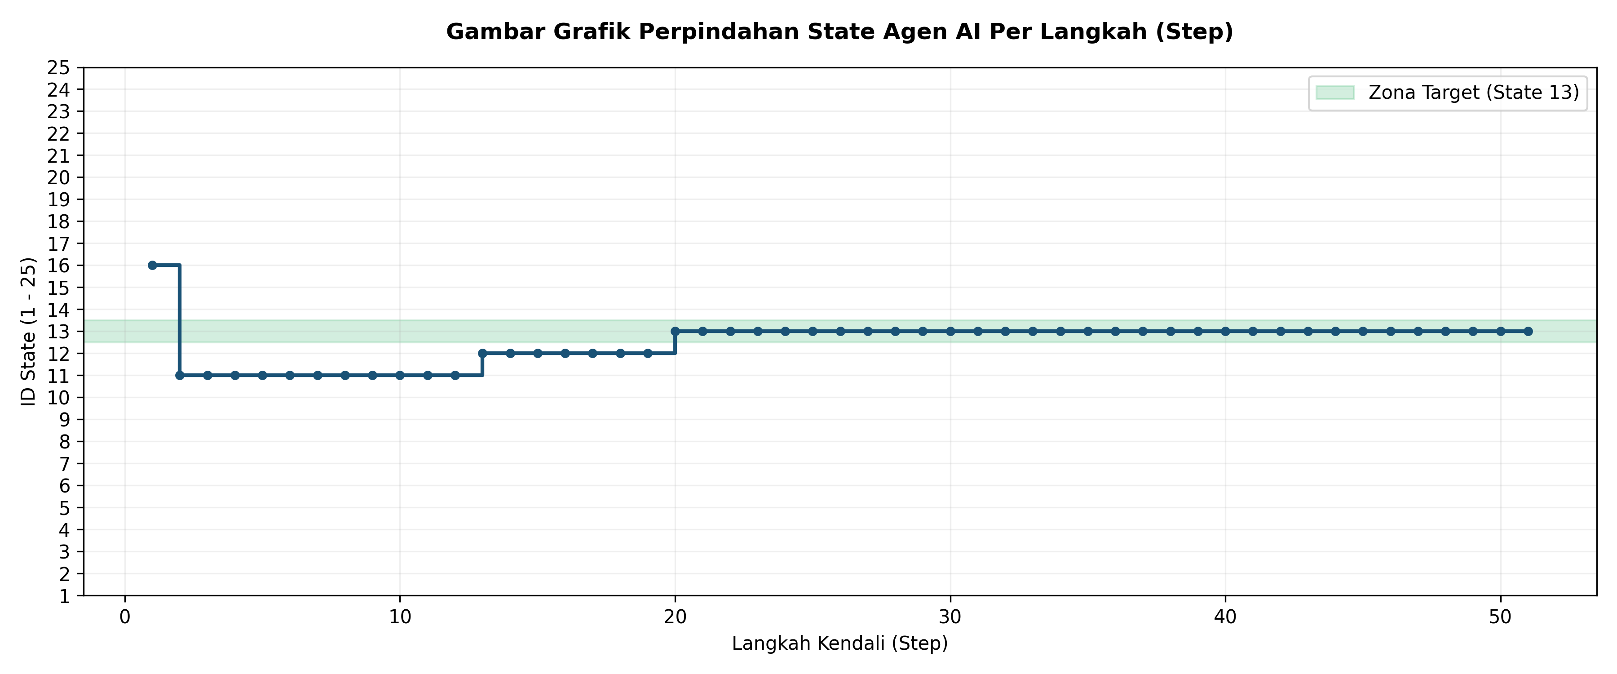
output/output_grafik_transisi/gambar_4_9_state_line_path.png
