samuelparlindungan/ML-Q-Learning/output/output_grafik_transisi/gambar_4_10_state_movement_map.png

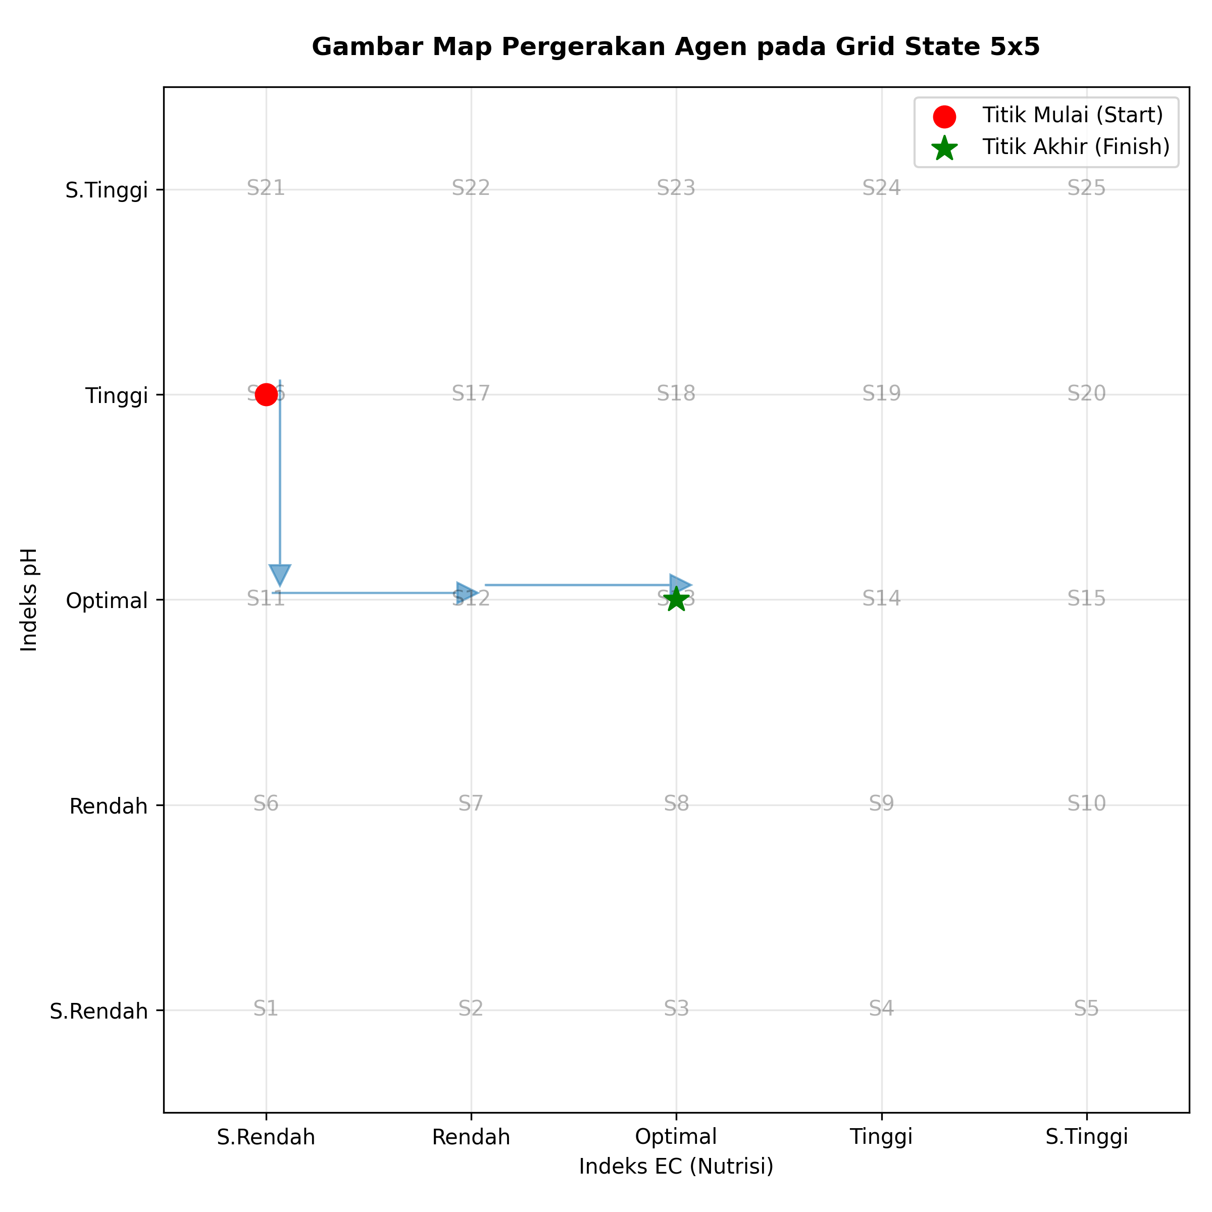
output/output_grafik_transisi/gambar_4_10_state_movement_map.png
