samuelparlindungan/ML-Q-Learning/output/output_lampiran/lampiran_sesi_1.png

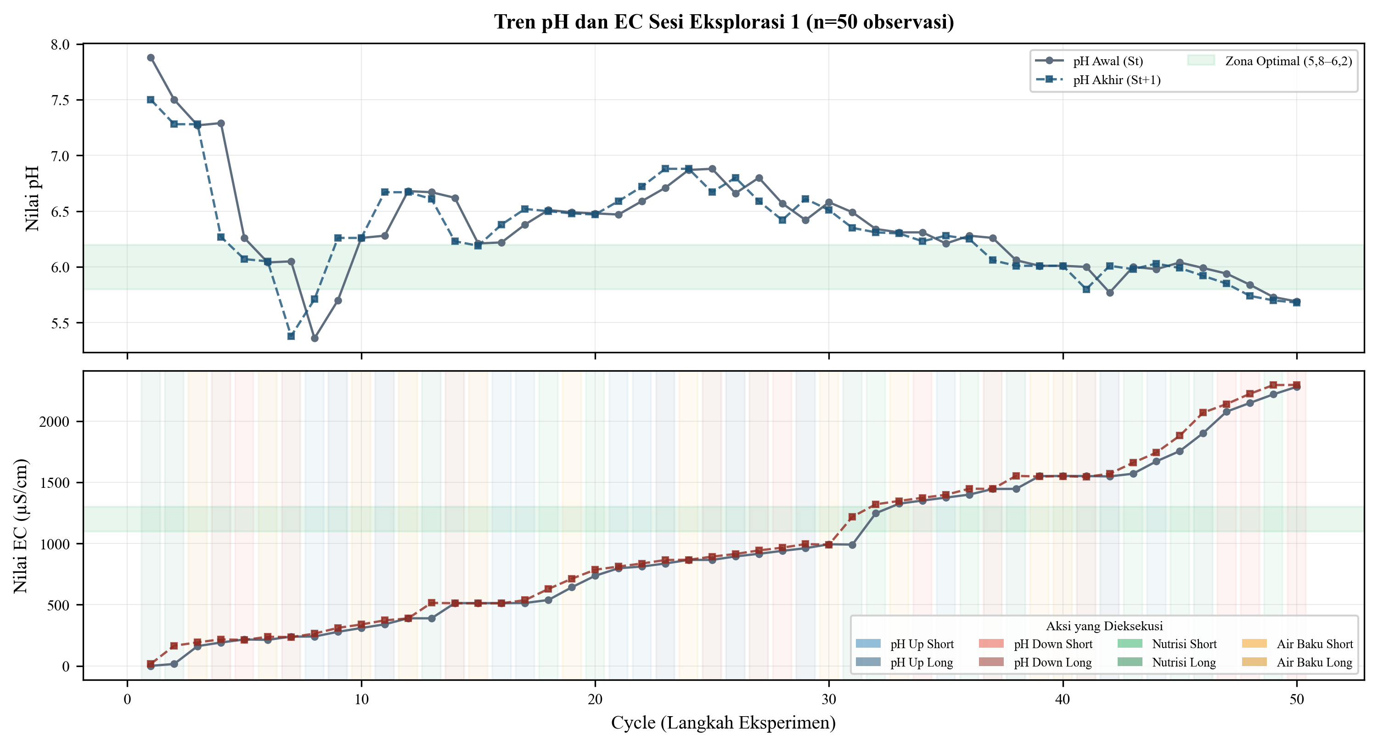
output/output_lampiran/lampiran_sesi_1.png
