samuelparlindungan/ML-Q-Learning/output/output_lampiran/lampiran_sesi_2.png

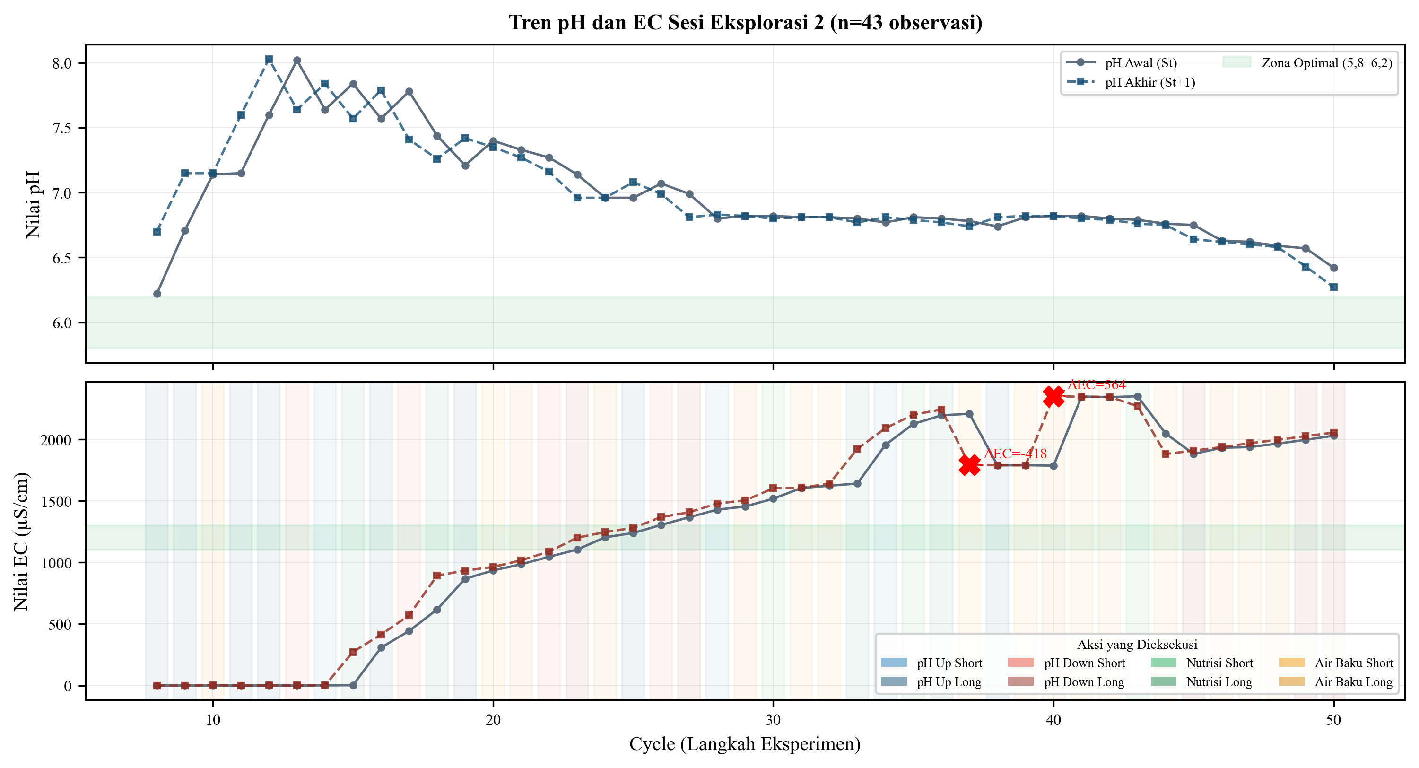
output/output_lampiran/lampiran_sesi_2.png
