samuelparlindungan/ML-Q-Learning/output/output_lampiran/lampiran_sesi_3.png

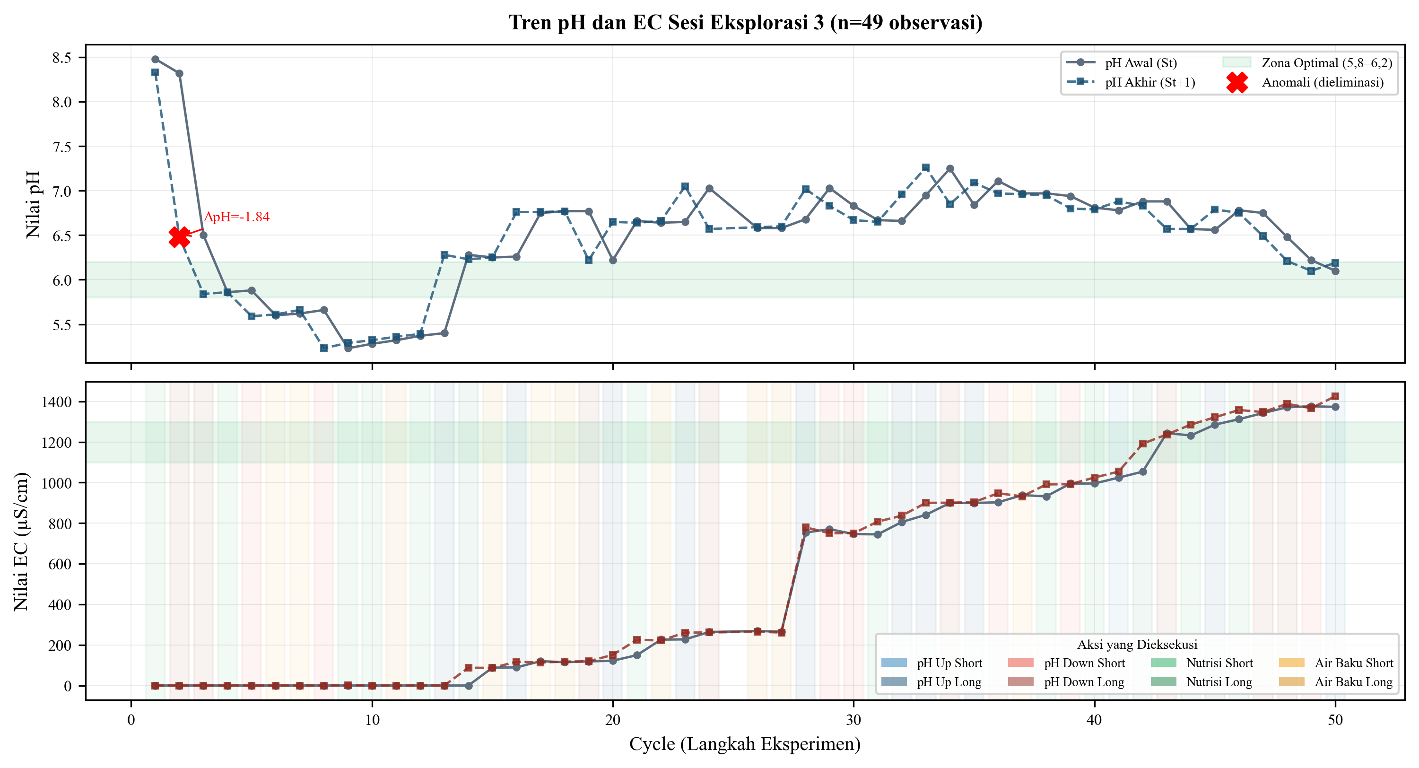
output/output_lampiran/lampiran_sesi_3.png
