samuelparlindungan/ML-Q-Learning/output/output_lampiran/lampiran_sesi_4.png

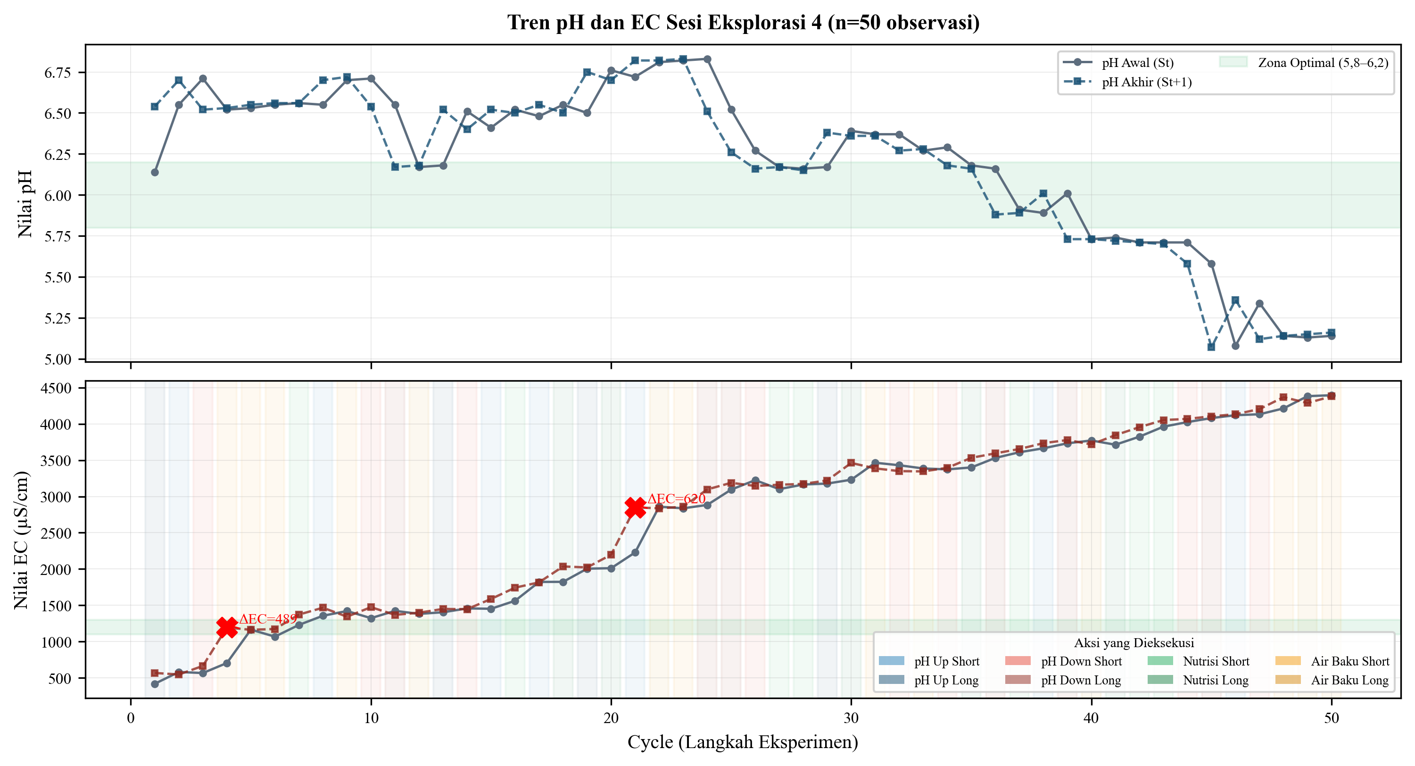
output/output_lampiran/lampiran_sesi_4.png
