samuelparlindungan/ML-Q-Learning/output/Renamed_Backup/Grafik_1_Konvergensi_Reward_v6_lama.png

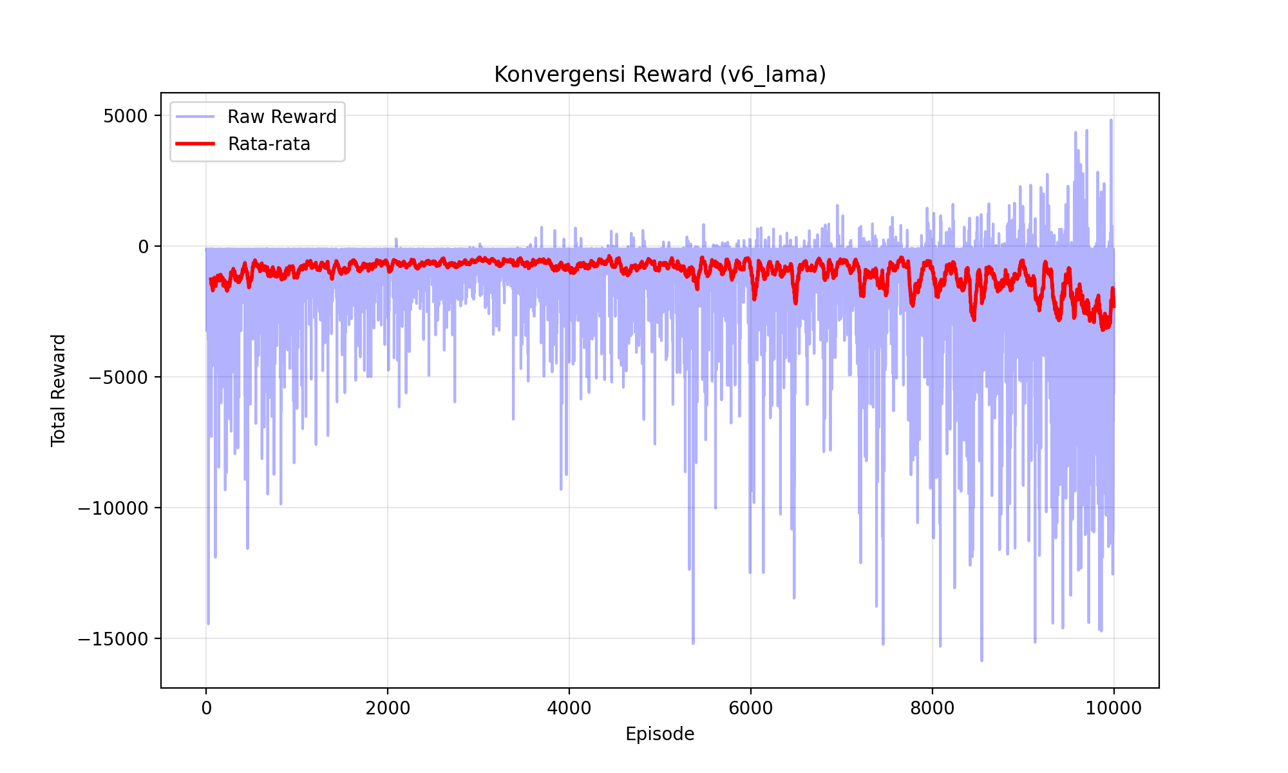
output/Renamed_Backup/Grafik_1_Konvergensi_Reward_v6_lama.png
