samuelparlindungan/ML-Q-Learning/output/Renamed_Backup/Grafik_3_Alpha_Decay_v6_final.png

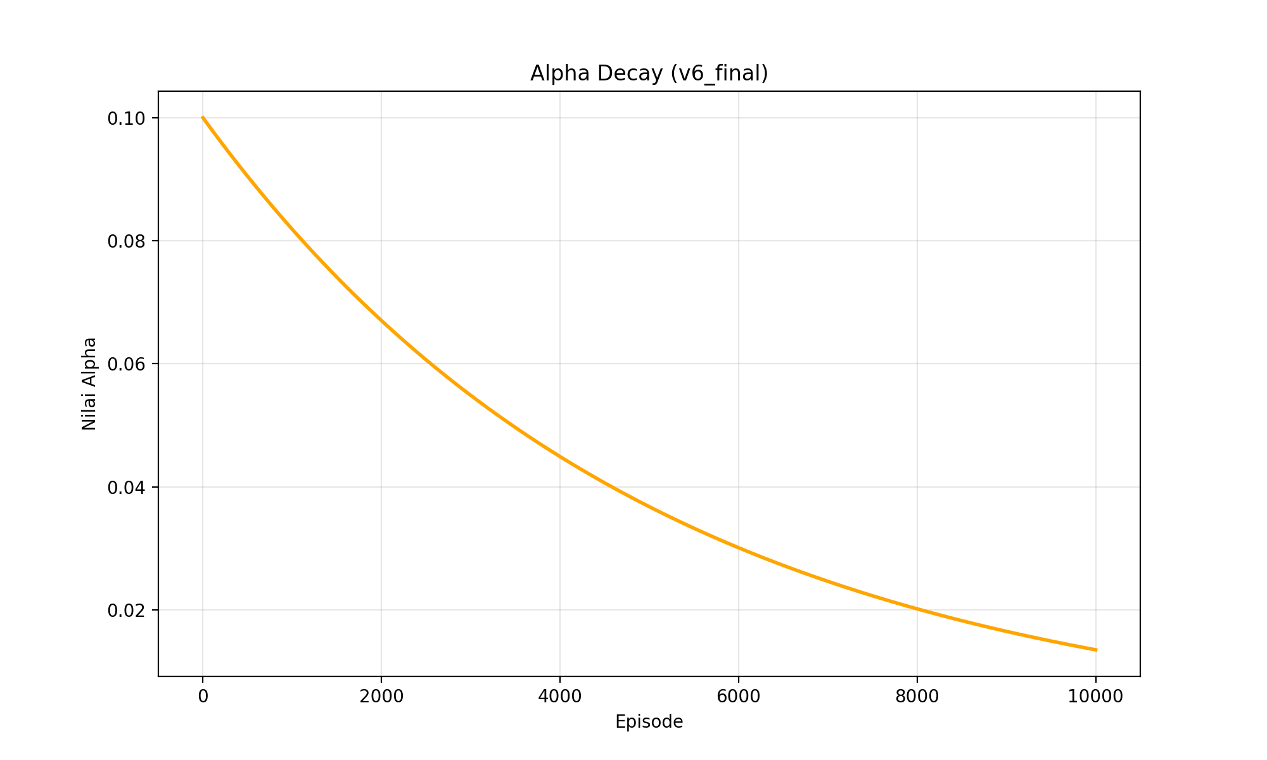
output/Renamed_Backup/Grafik_3_Alpha_Decay_v6_final.png
