samuelparlindungan/ML-Q-Learning/output/Renamed_Backup/Grafik_4_Heatmap_State_v6_final.png

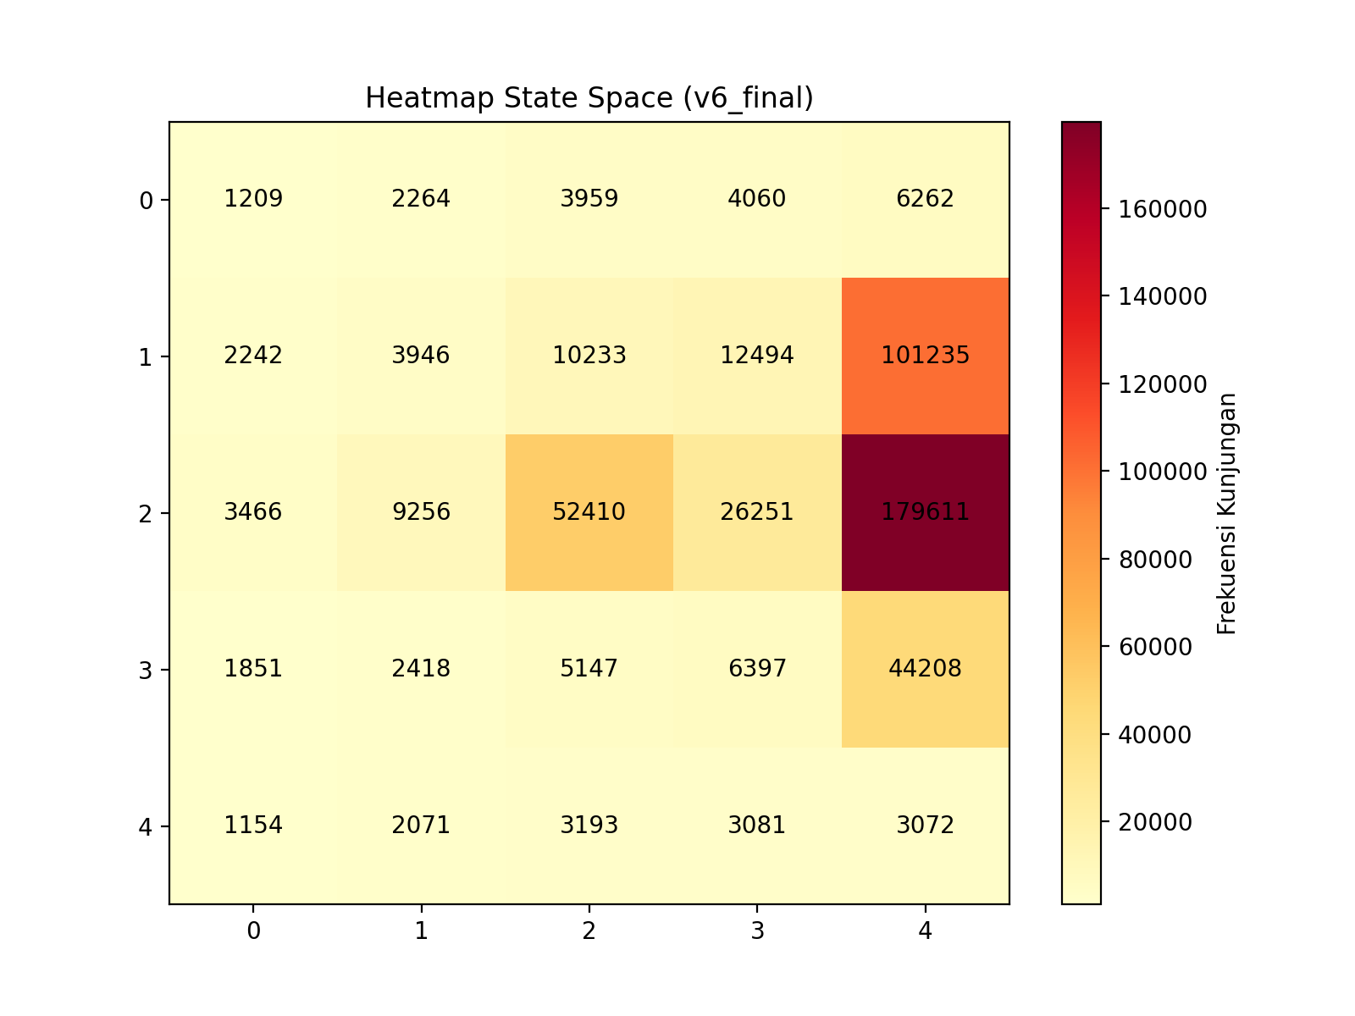
output/Renamed_Backup/Grafik_4_Heatmap_State_v6_final.png
