samuelparlindungan/ML-Q-Learning/output/Renamed_Backup/Grafik_5_Distribusi_Aksi_v6_final.png

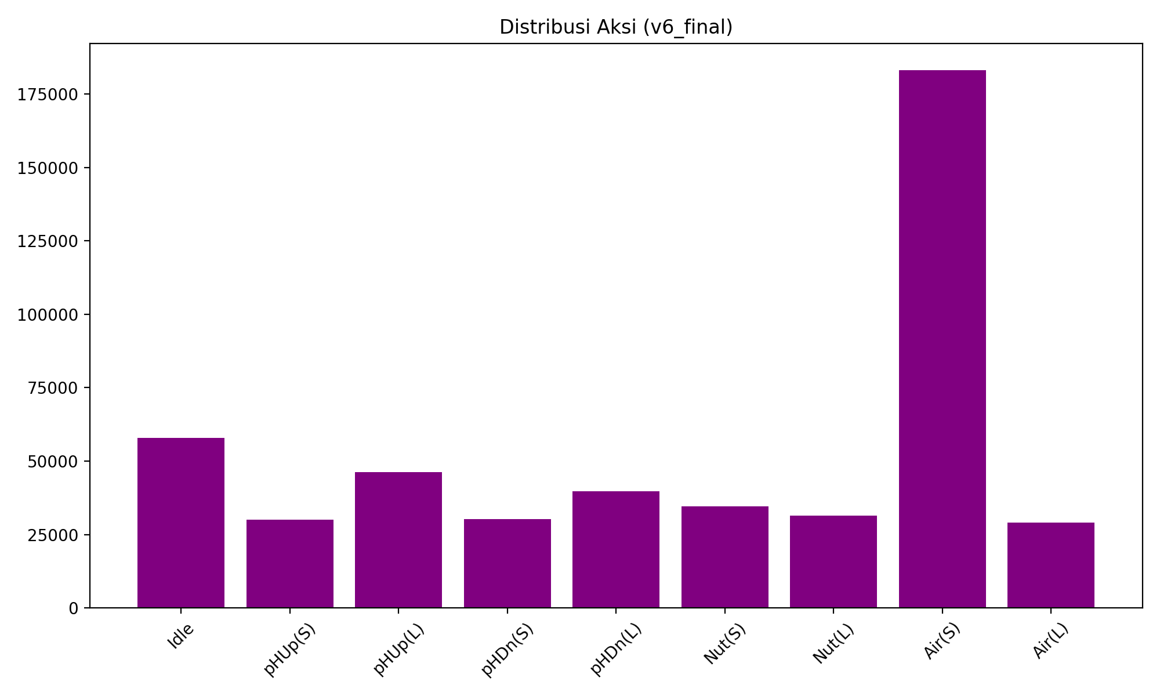
output/Renamed_Backup/Grafik_5_Distribusi_Aksi_v6_final.png
