samuelparlindungan/ML-Q-Learning/output/v4_dataset_asli/1_reward_convergence.png

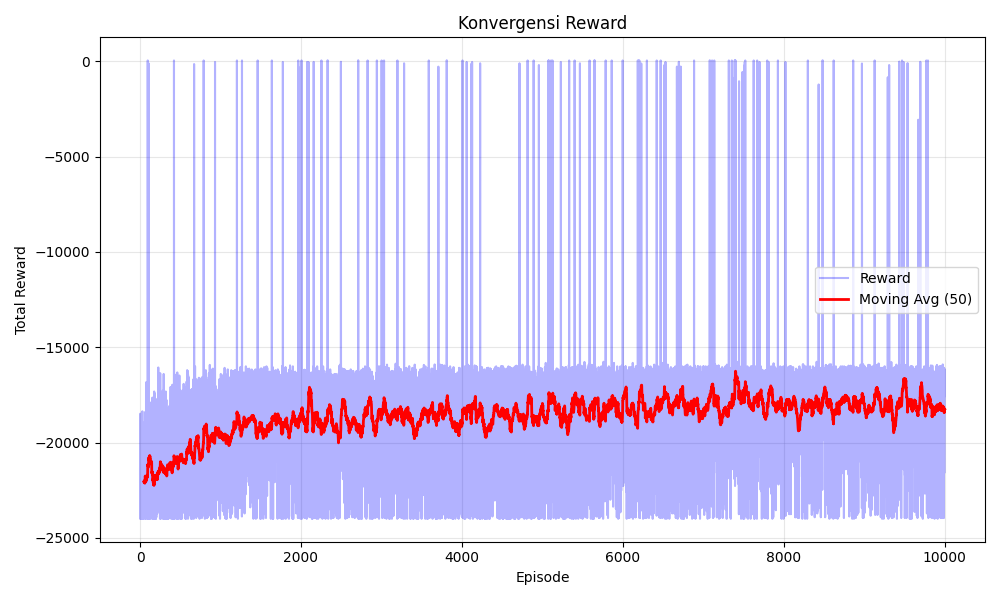
output/v4_dataset_asli/1_reward_convergence.png
