samuelparlindungan/ML-Q-Learning/output/v4_dataset_asli/2_qmax_convergence.png

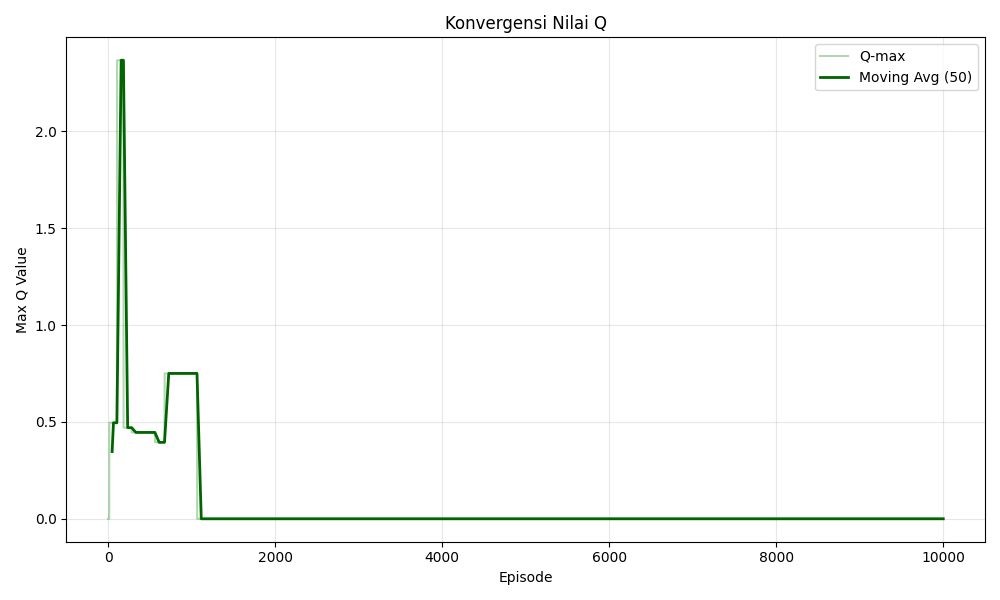
output/v4_dataset_asli/2_qmax_convergence.png
