samuelparlindungan/ML-Q-Learning/output/v4_dataset_asli/3_alpha_decay.png

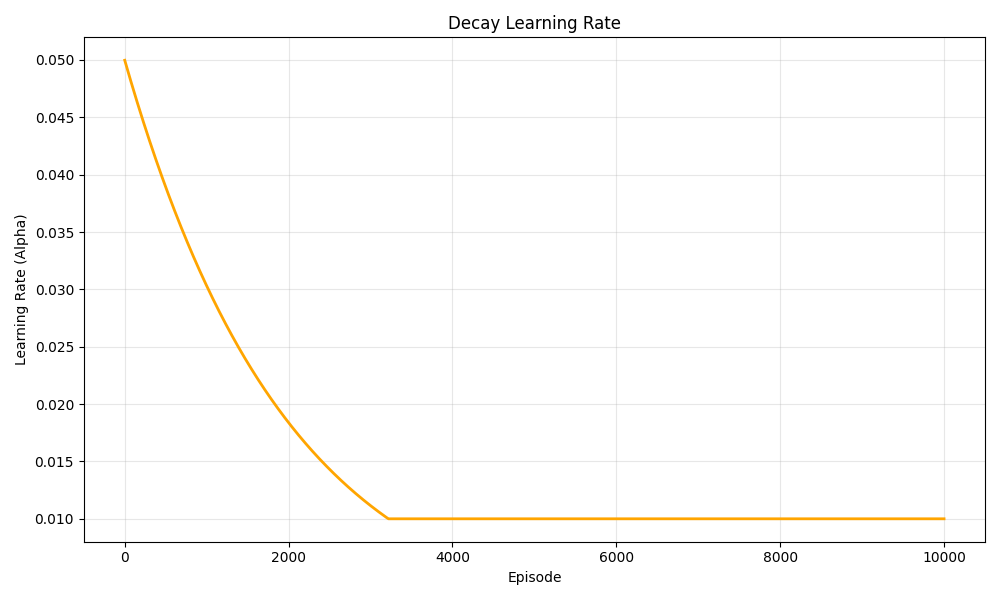
output/v4_dataset_asli/3_alpha_decay.png
