samuelparlindungan/ML-Q-Learning/output/v4_dataset_asli/5_state_heatmap.png

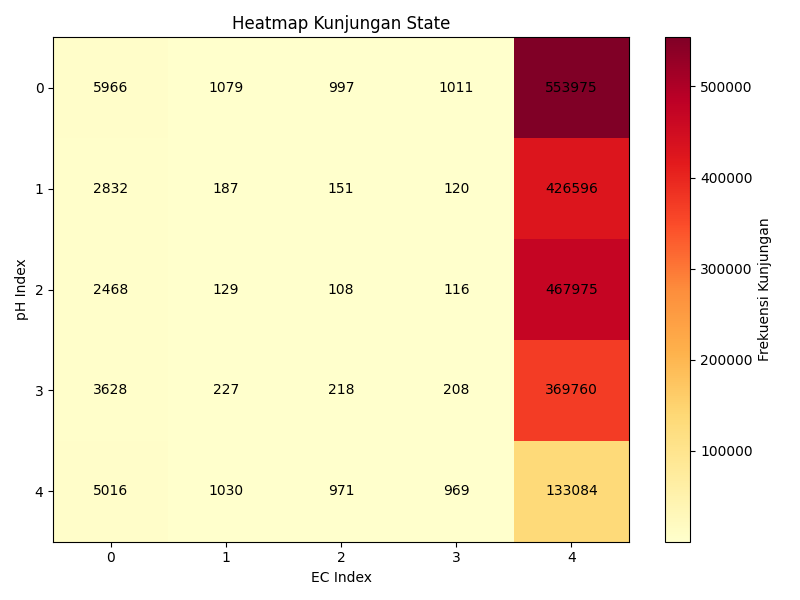
output/v4_dataset_asli/5_state_heatmap.png
