samuelparlindungan/ML-Q-Learning/output/v4_dataset_asli/6_action_dist.png

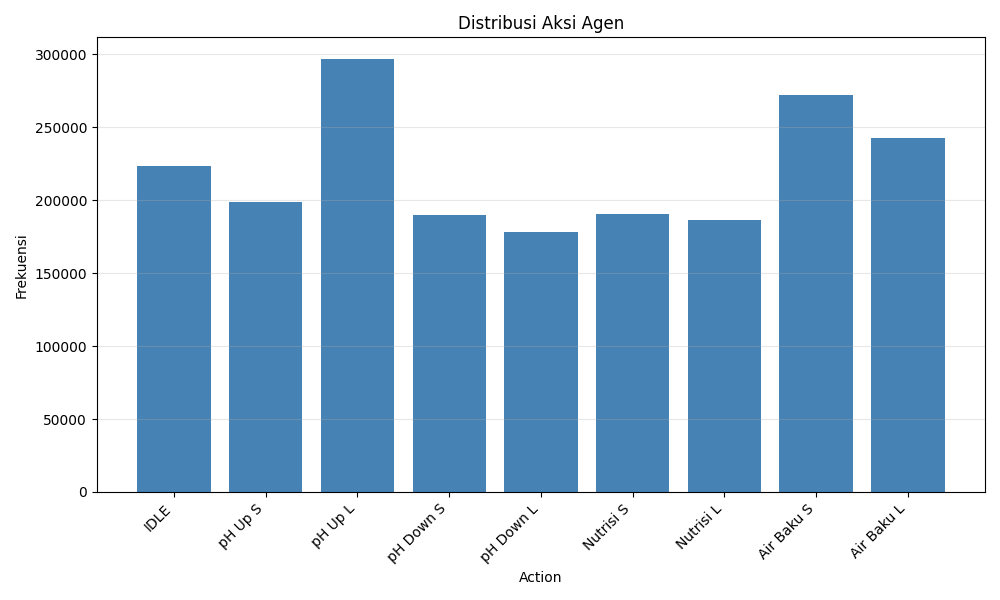
output/v4_dataset_asli/6_action_dist.png
