samuelparlindungan/ML-Q-Learning/output/v4_dataset_asli/Grafik_1_Konvergensi_Reward.png

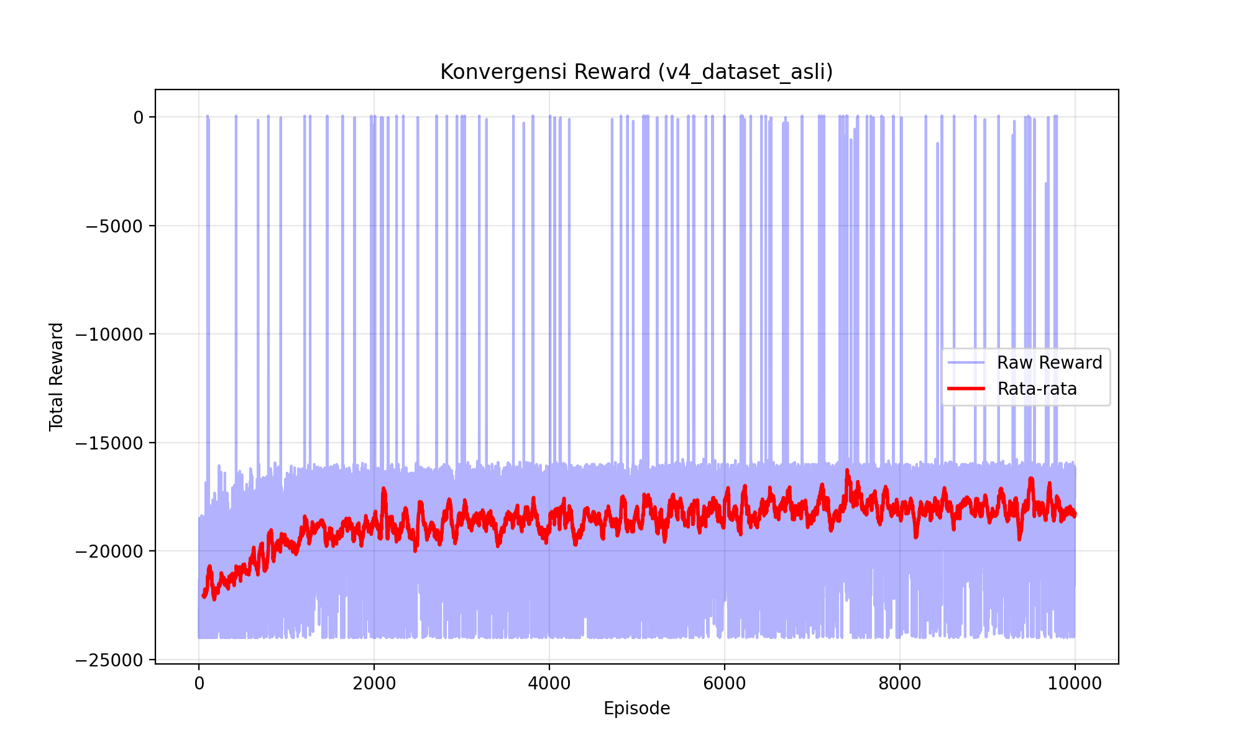
output/v4_dataset_asli/Grafik_1_Konvergensi_Reward.png
