samuelparlindungan/ML-Q-Learning/output/v4_dataset_asli/Grafik_3_Alpha_Decay.png

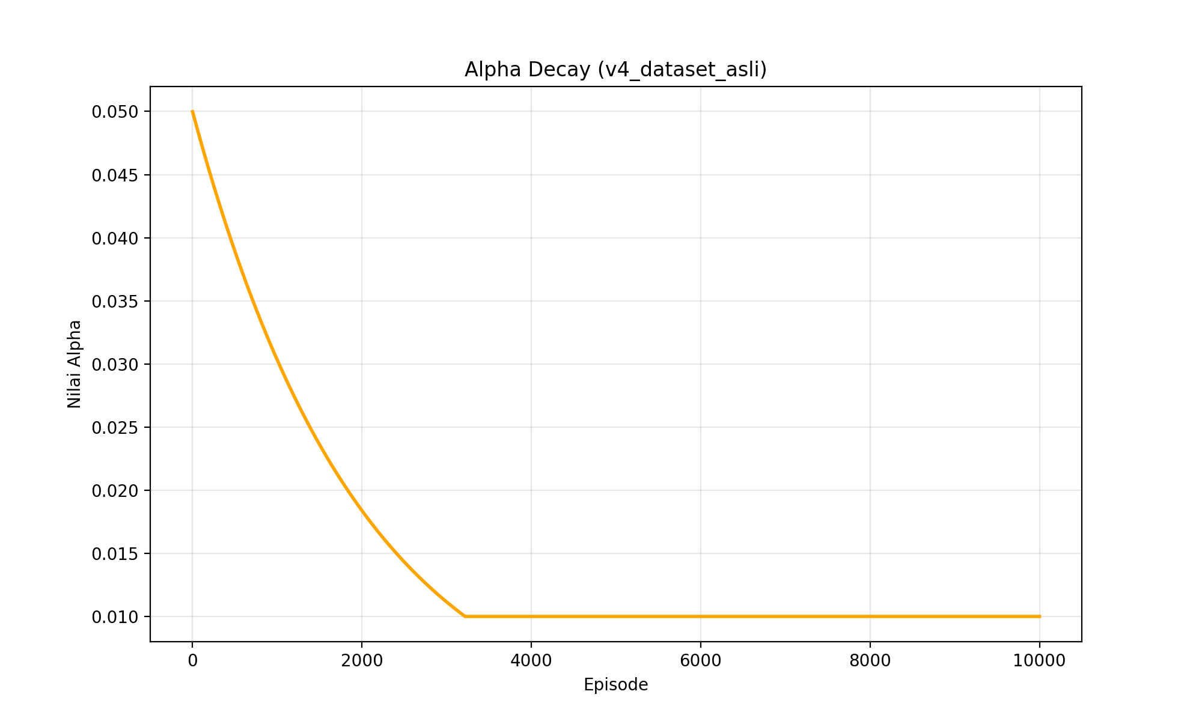
output/v4_dataset_asli/Grafik_3_Alpha_Decay.png
