samuelparlindungan/ML-Q-Learning/output/v4_dataset_asli/Grafik_4_Heatmap_State.png

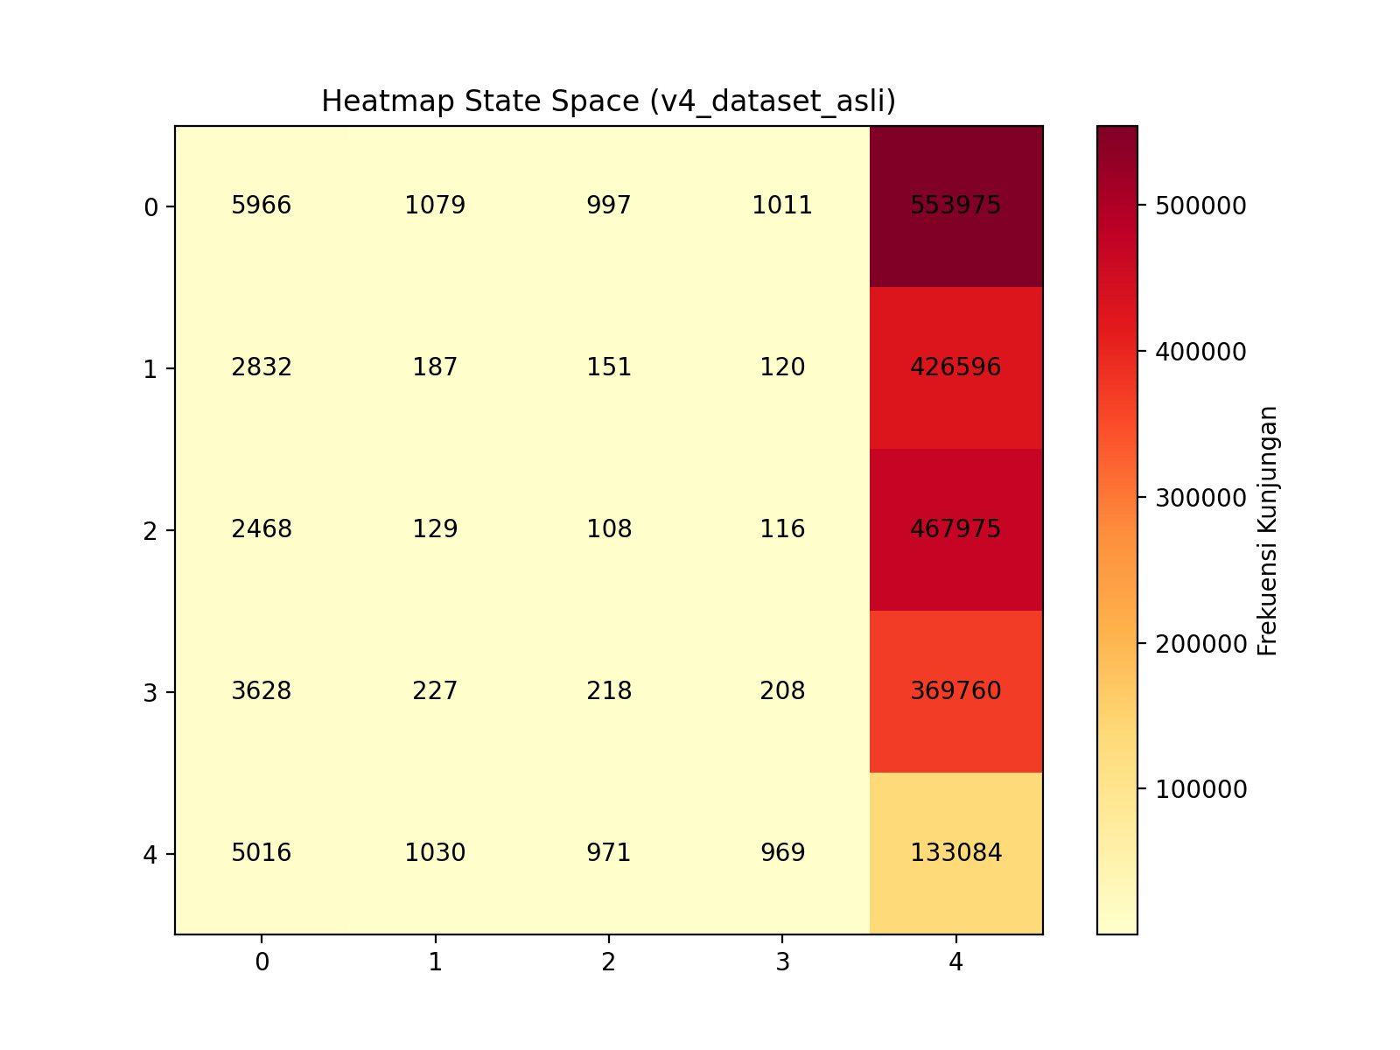
output/v4_dataset_asli/Grafik_4_Heatmap_State.png
