samuelparlindungan/ML-Q-Learning/output/v4_dataset_asli/Grafik_5_Distribusi_Aksi.png

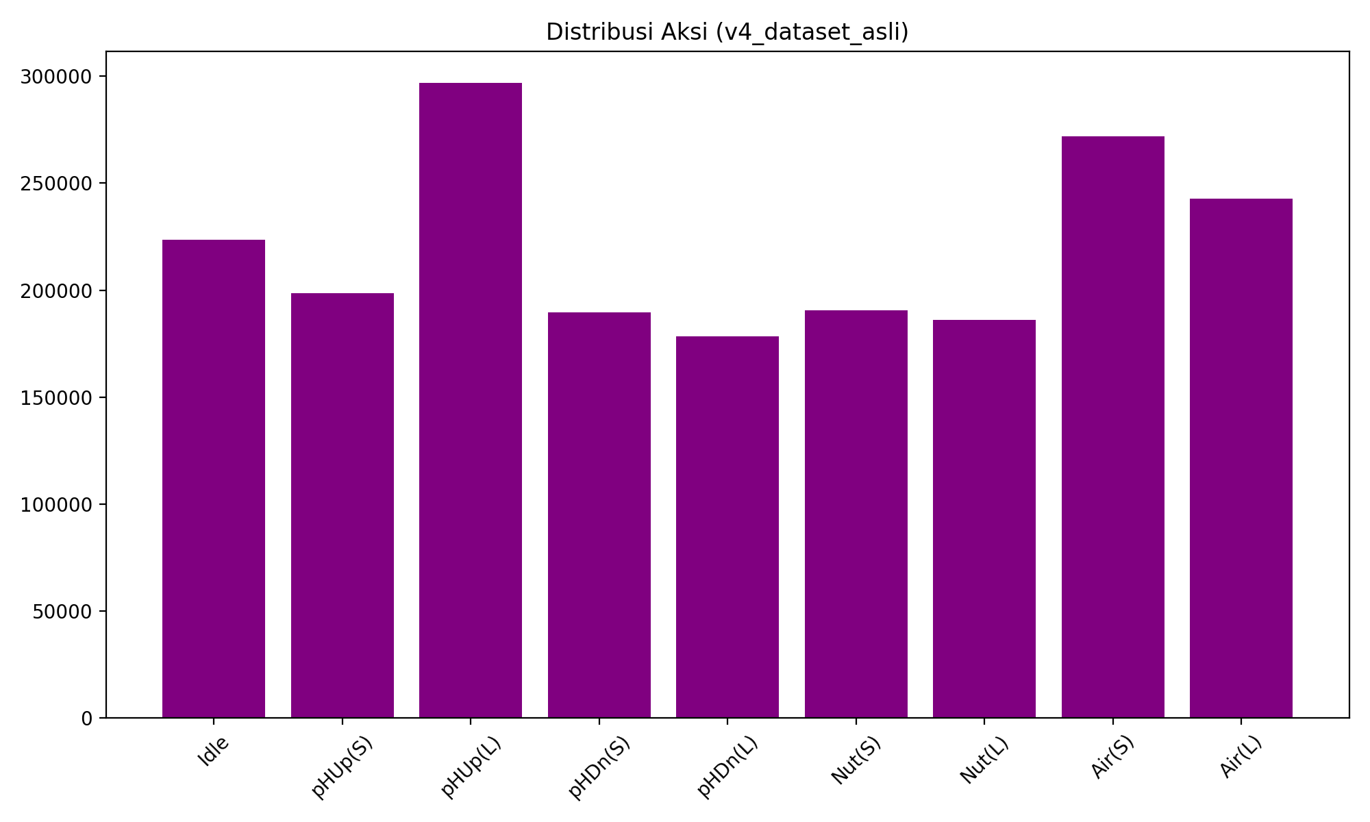
output/v4_dataset_asli/Grafik_5_Distribusi_Aksi.png
