samuelparlindungan/ML-Q-Learning/output/v5_normal_sesi3/Grafik_1_Konvergensi_Reward.png

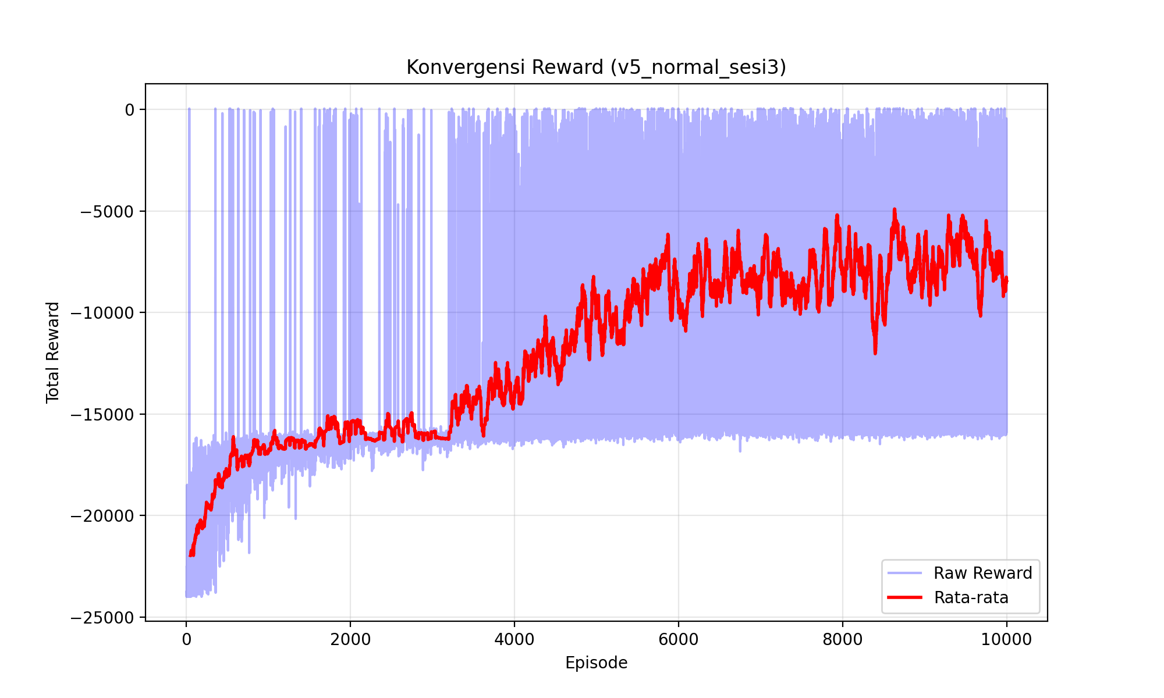
output/v5_normal_sesi3/Grafik_1_Konvergensi_Reward.png
