samuelparlindungan/ML-Q-Learning/output/v5_normal_sesi3/Grafik_4_Heatmap_State.png

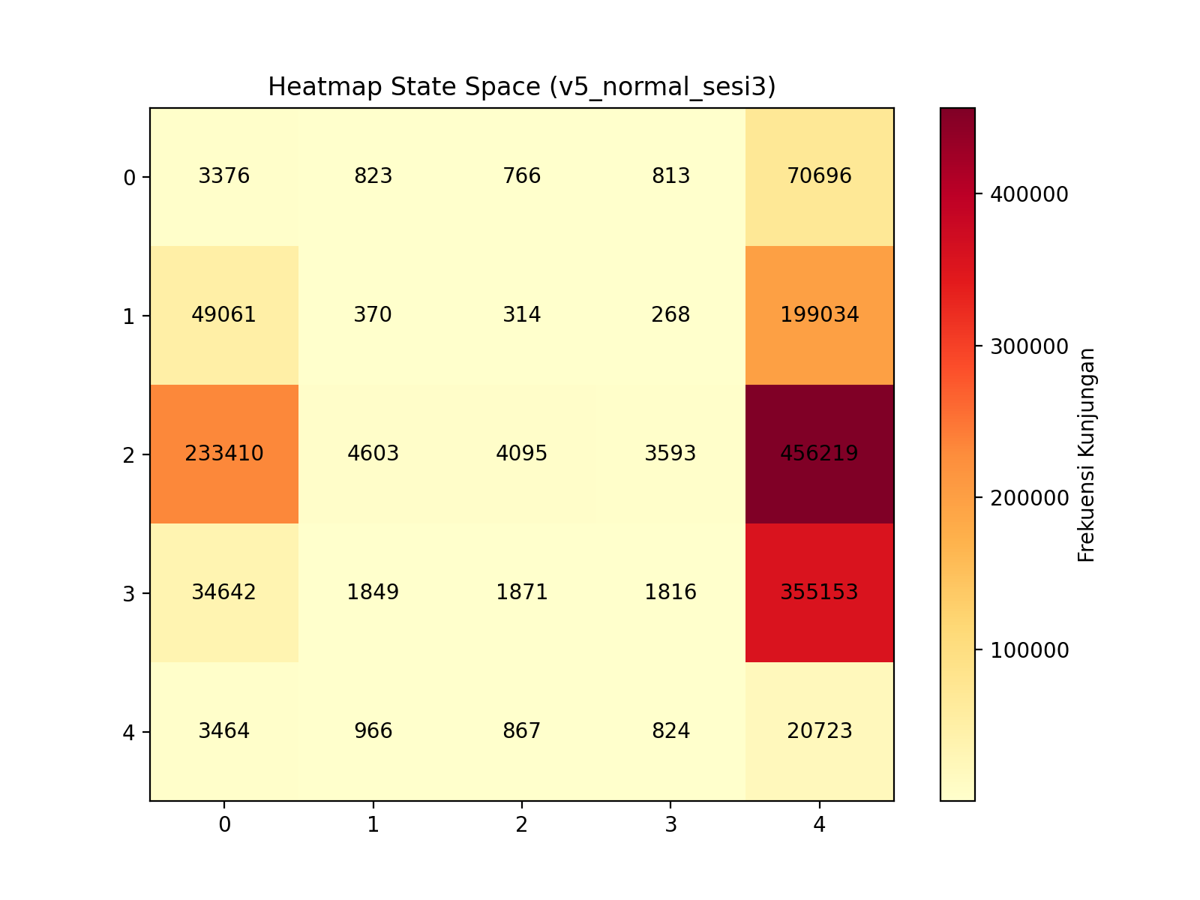
output/v5_normal_sesi3/Grafik_4_Heatmap_State.png
