samuelparlindungan/ML-Q-Learning/output/v5_normal_sesi3/Grafik_5_Distribusi_Aksi.png

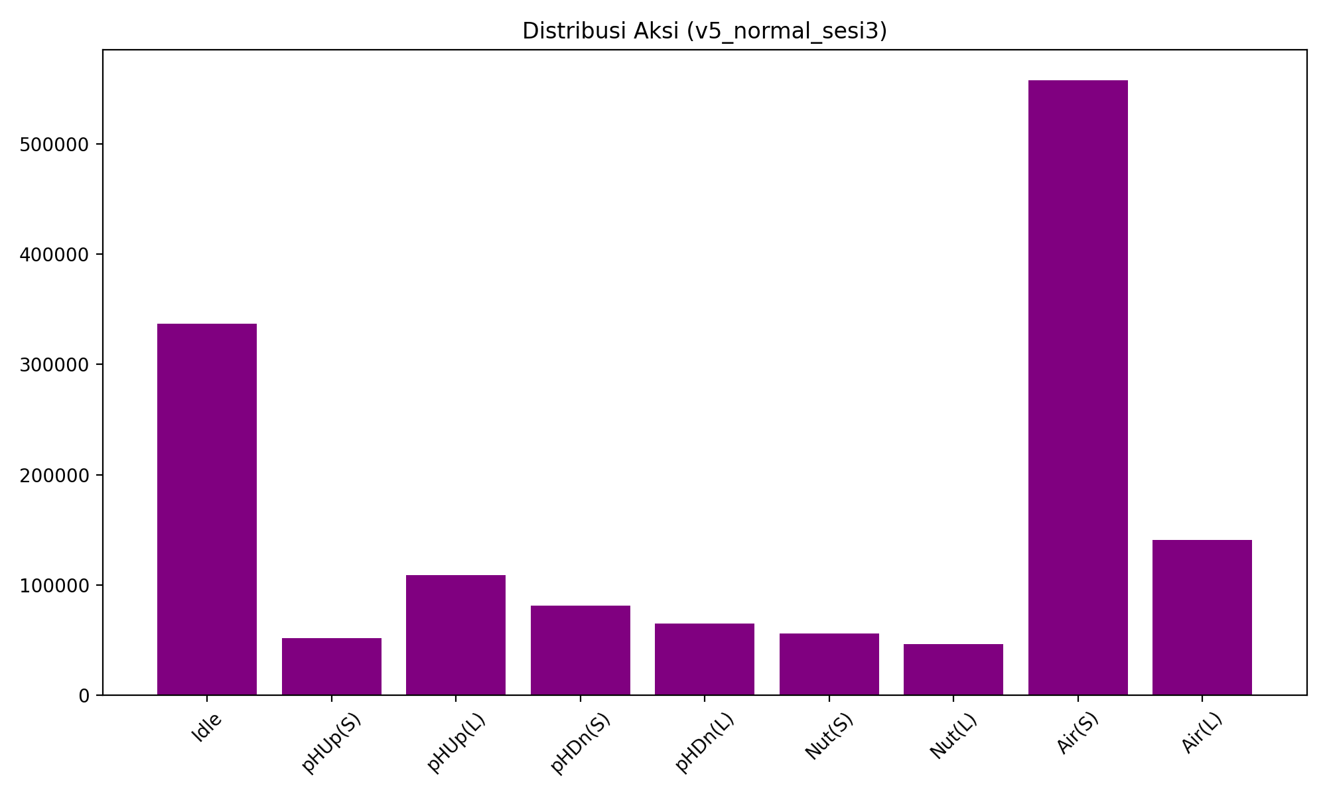
output/v5_normal_sesi3/Grafik_5_Distribusi_Aksi.png
