samuelparlindungan/ML-Q-Learning/output/v6_final/reports/Grafik_3_Alpha.png

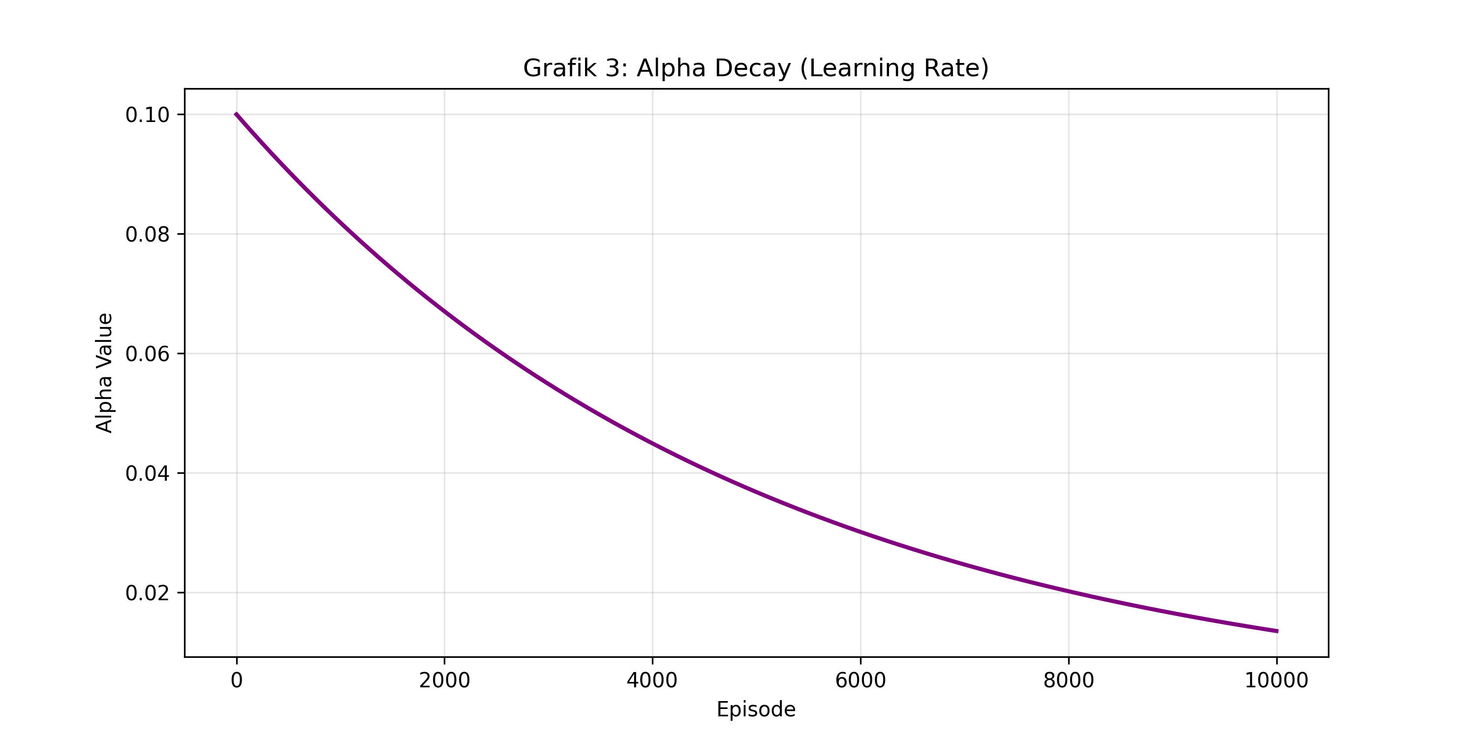
output/v6_final/reports/Grafik_3_Alpha.png
