samuelparlindungan/ML-Q-Learning/output/v6_final/reports/Grafik_4_Qmax.png

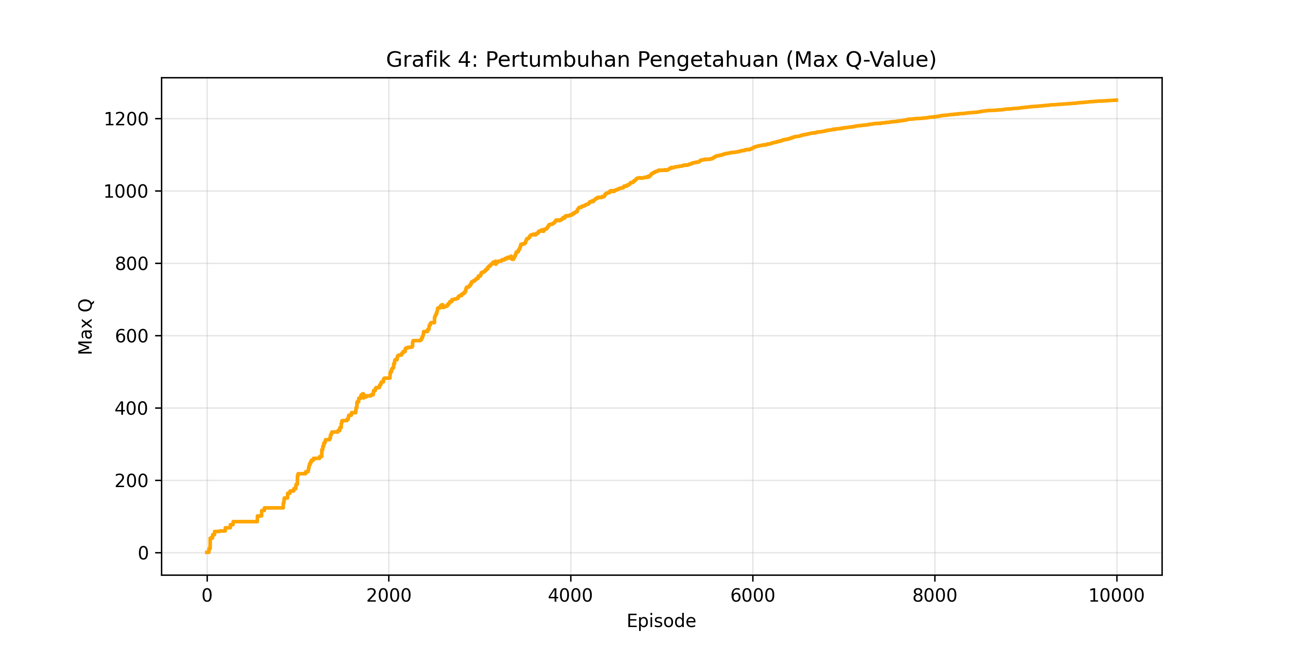
output/v6_final/reports/Grafik_4_Qmax.png
