samuelparlindungan/ML-Q-Learning/output/v6_final/reports/Grafik_5_Heatmap.png

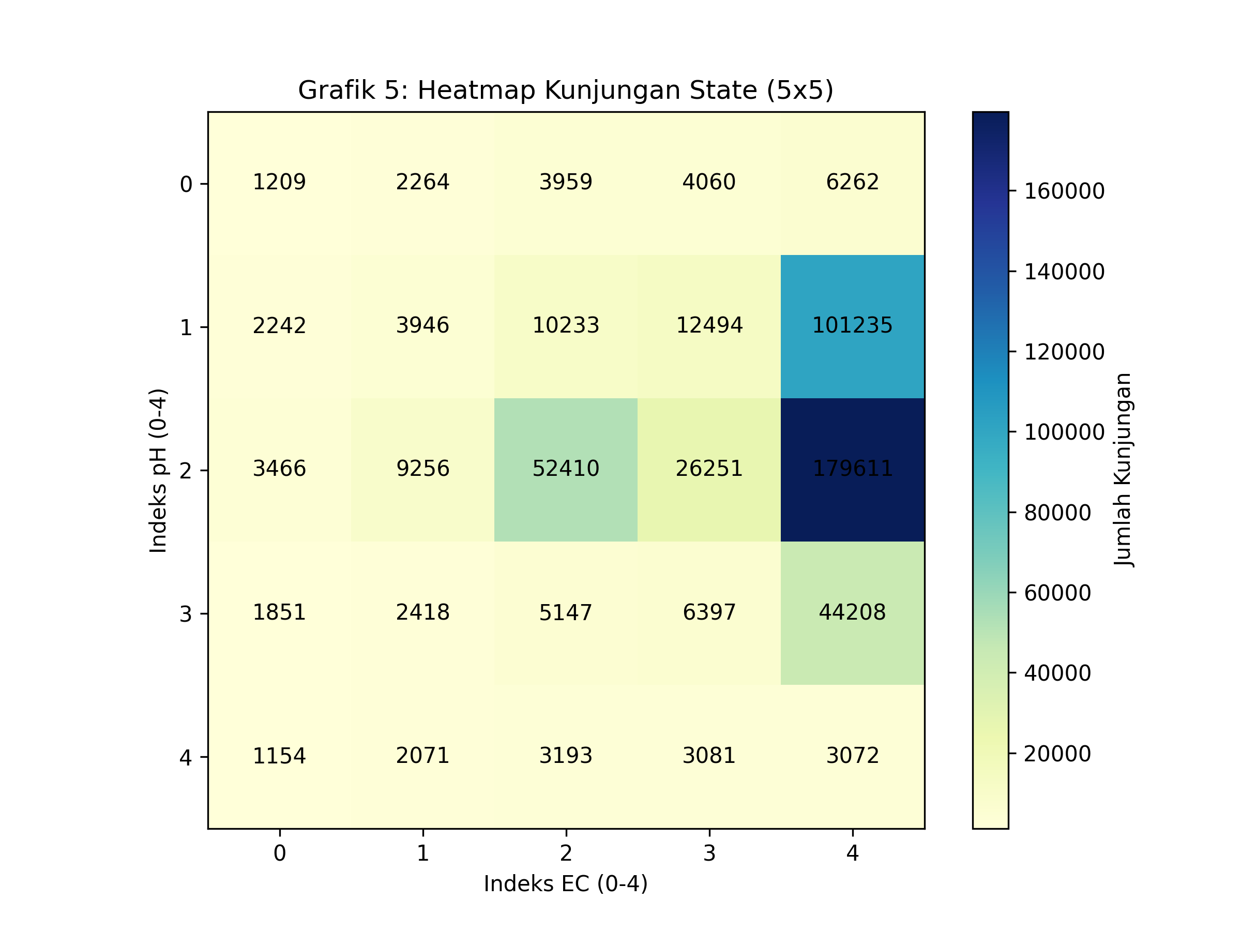
output/v6_final/reports/Grafik_5_Heatmap.png
