samuelparlindungan/ML-Q-Learning/output/v6_final/reports/Grafik_6_Actions.png

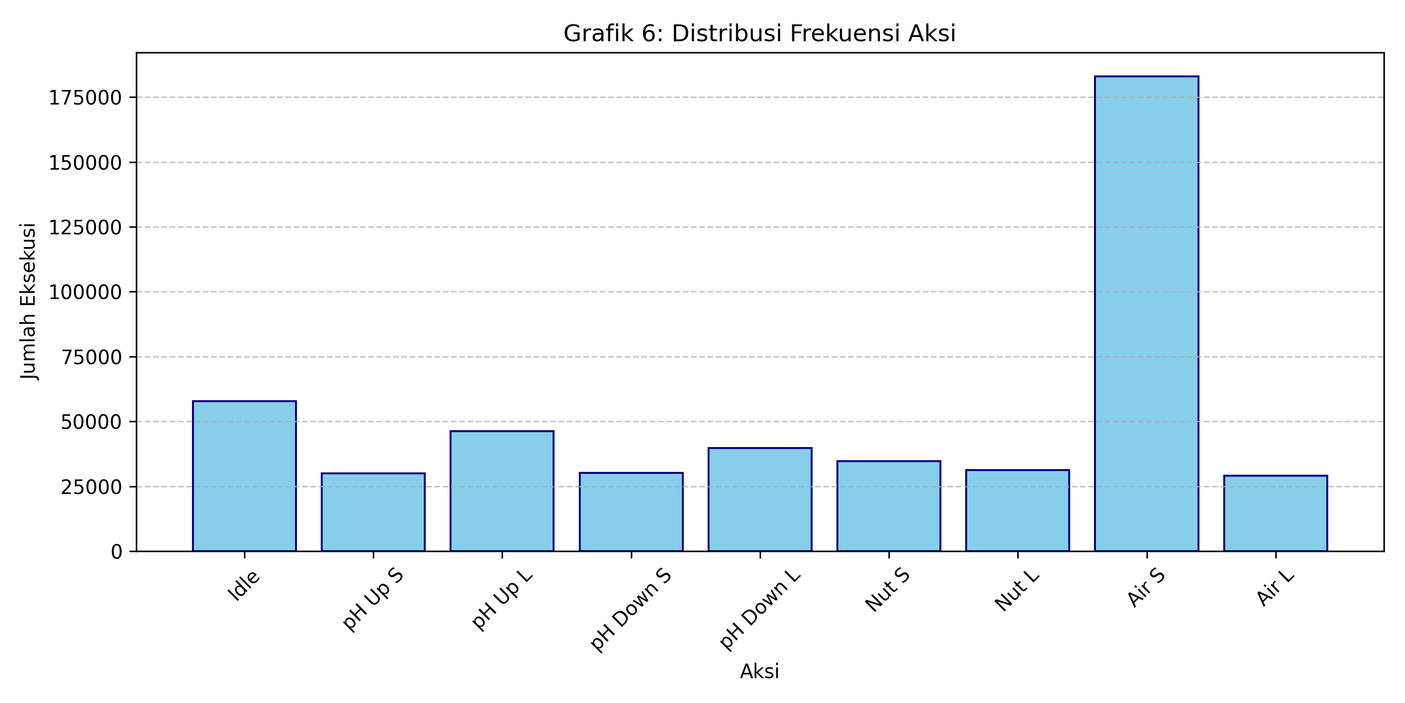
output/v6_final/reports/Grafik_6_Actions.png
