samuelparlindungan/ML-Q-Learning/output_data/Perbandingan_Sesi/4_komparasi_sesi_overlaid.png

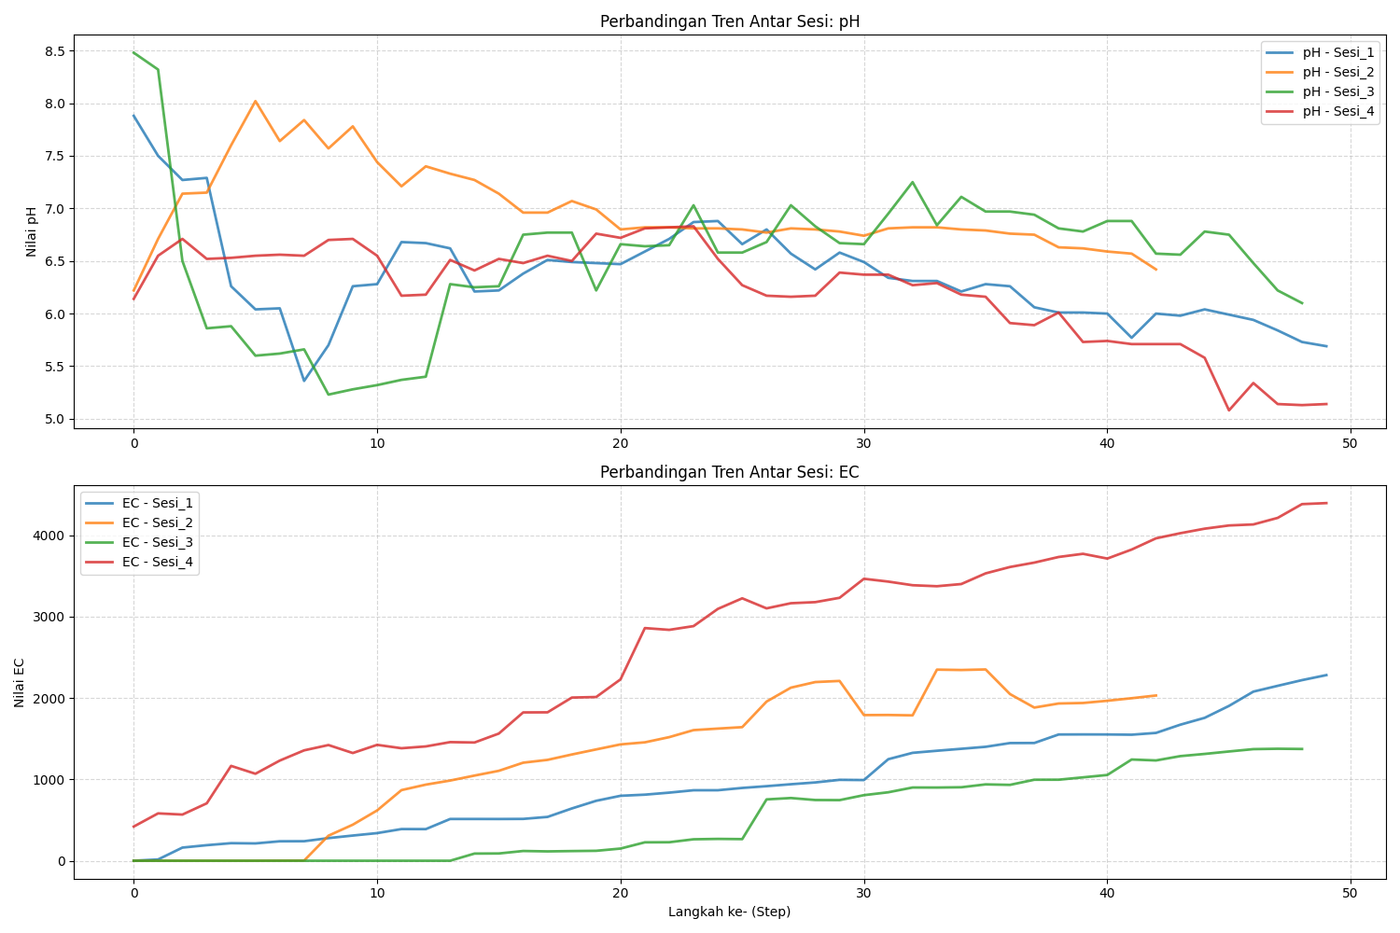
output_data/Perbandingan_Sesi/4_komparasi_sesi_overlaid.png
