samuelparlindungan/ML-Q-Learning/output_data/Semua_Sesi/1_tren_diagnostic_ph_ec.png

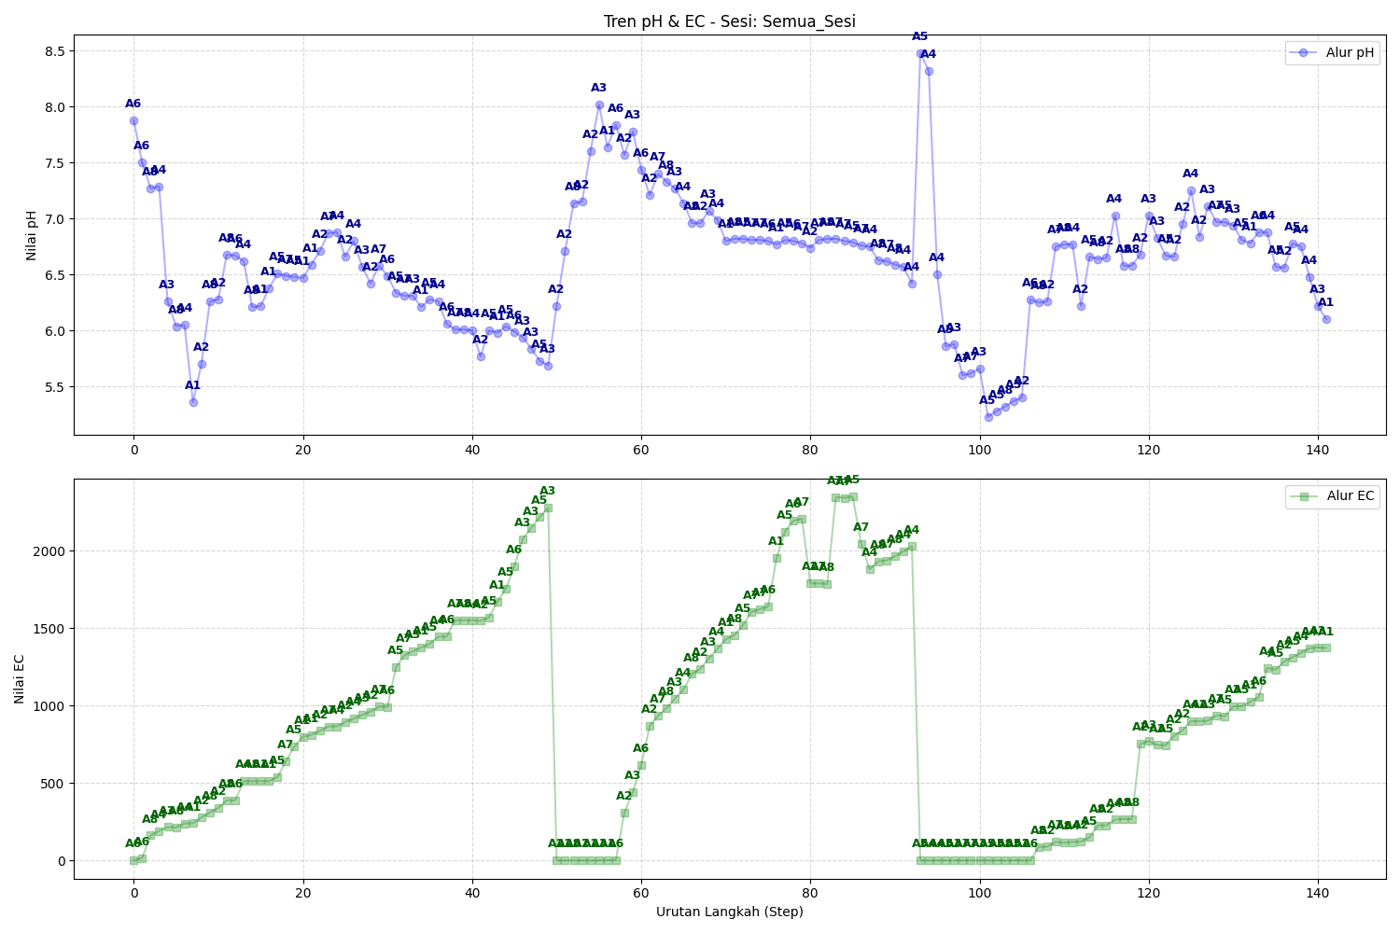
output_data/Semua_Sesi/1_tren_diagnostic_ph_ec.png
