samuelparlindungan/ML-Q-Learning/output_data/Semua_Sesi/2_distribusi_aksi.png

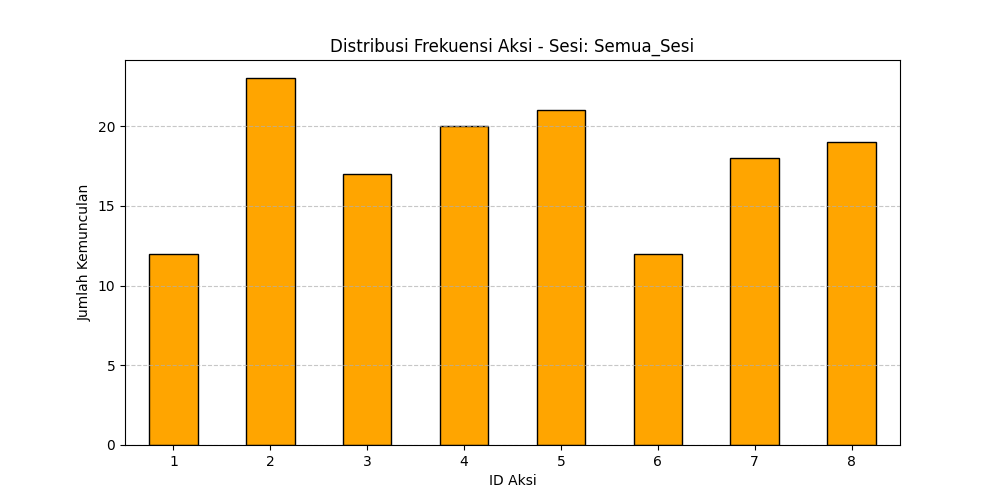
output_data/Semua_Sesi/2_distribusi_aksi.png
