samuelparlindungan/ML-Q-Learning/output_data/Semua_Sesi/3_efek_aksi_boxplot.png

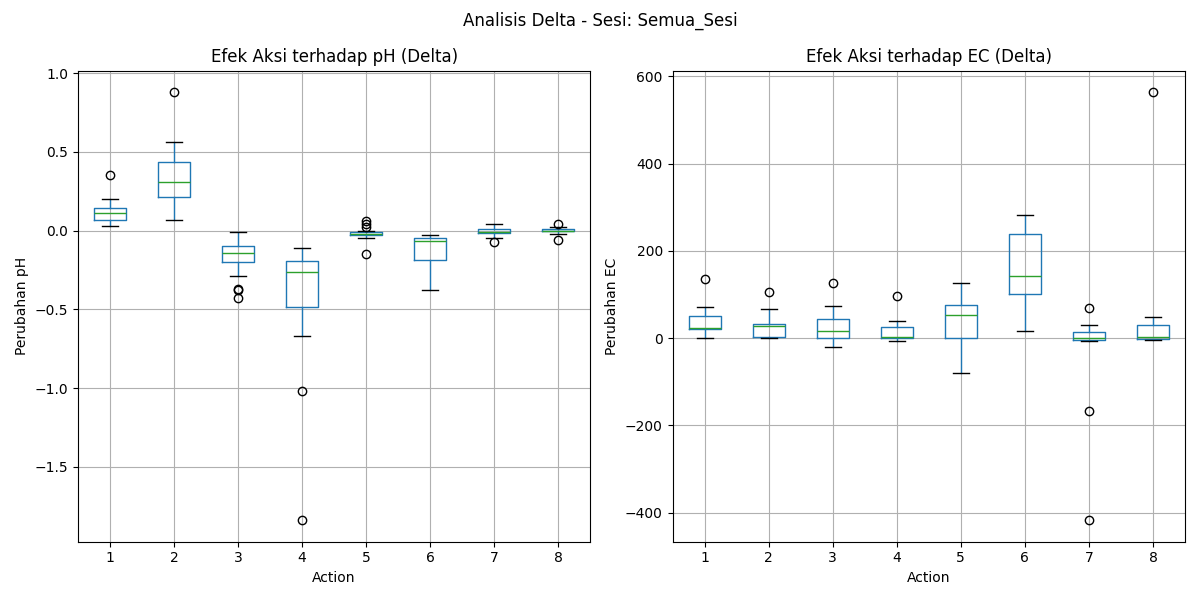
output_data/Semua_Sesi/3_efek_aksi_boxplot.png
