samuelparlindungan/ML-Q-Learning/output_data/Semua_Sesi/Semua_Sesi_2_distribusi_aksi.png

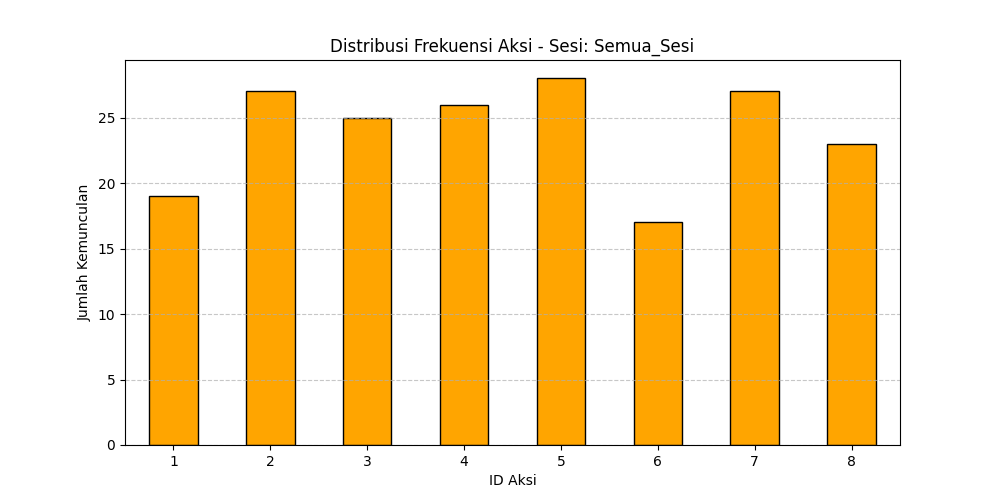
output_data/Semua_Sesi/Semua_Sesi_2_distribusi_aksi.png
