samuelparlindungan/ML-Q-Learning/output_data/Sesi_2/2_distribusi_aksi.png

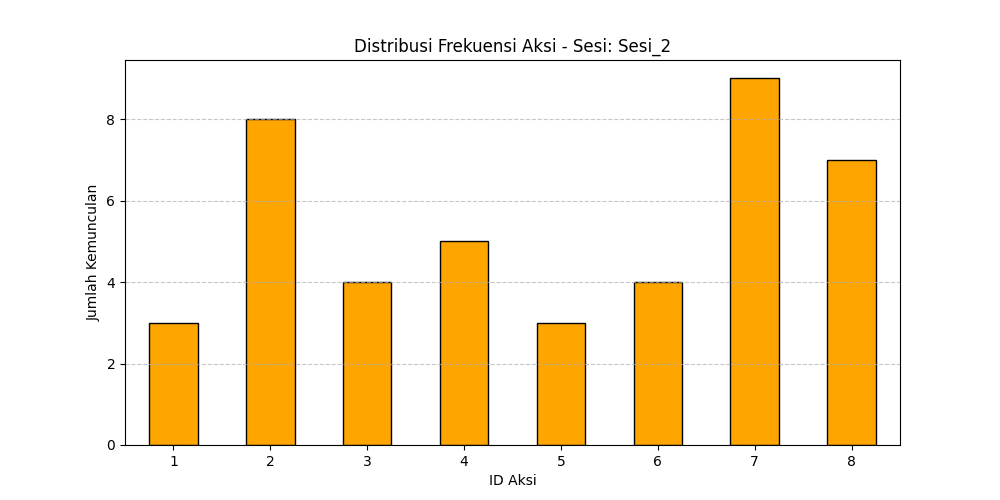
output_data/Sesi_2/2_distribusi_aksi.png
