samuelparlindungan/ML-Q-Learning/output_data/Sesi_3/1_tren_diagnostic_ph_ec.png

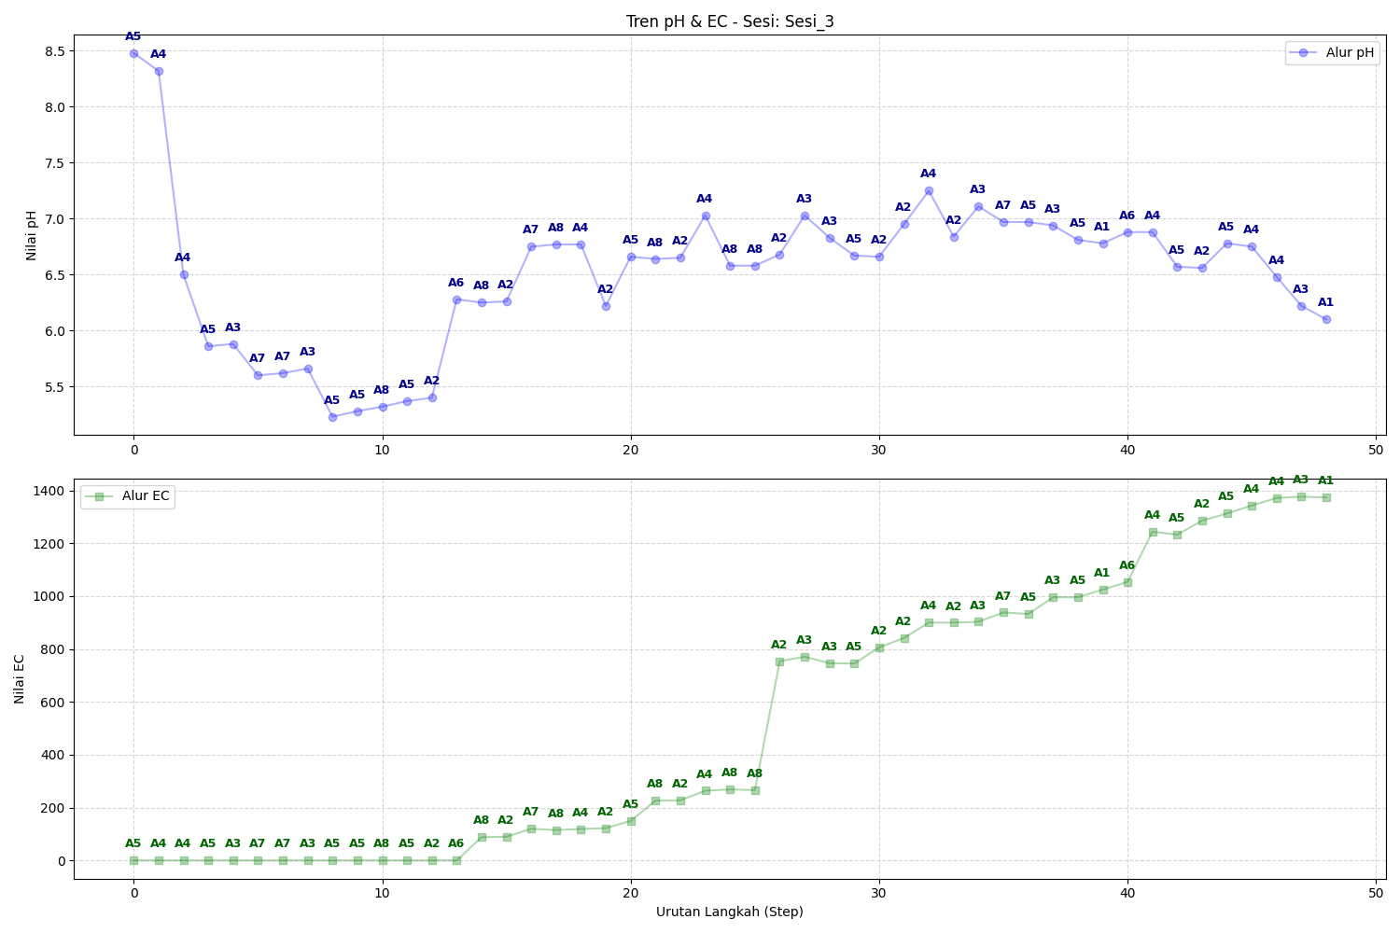
output_data/Sesi_3/1_tren_diagnostic_ph_ec.png
