samuelparlindungan/ML-Q-Learning/output_data/Sesi_3/2_distribusi_aksi.png

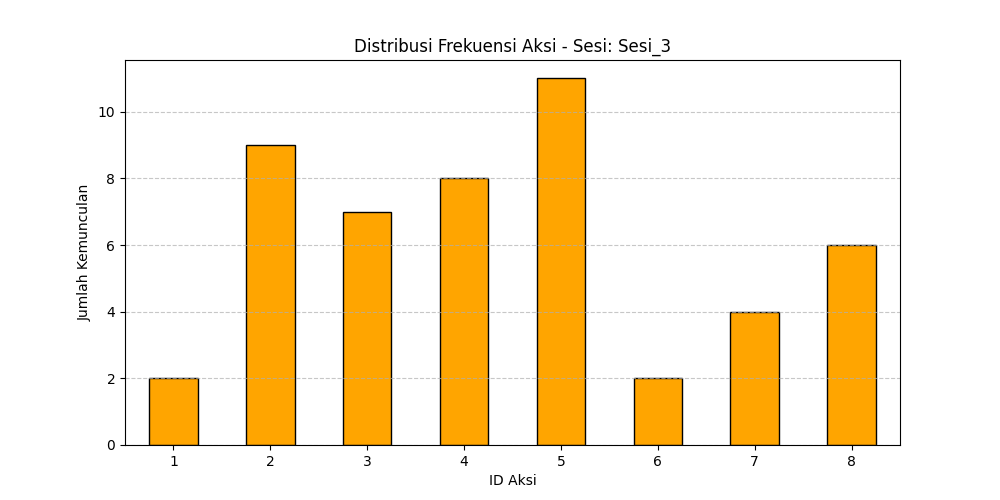
output_data/Sesi_3/2_distribusi_aksi.png
