samuelparlindungan/ML-Q-Learning/output_data/Sesi_3/3_efek_aksi_boxplot.png

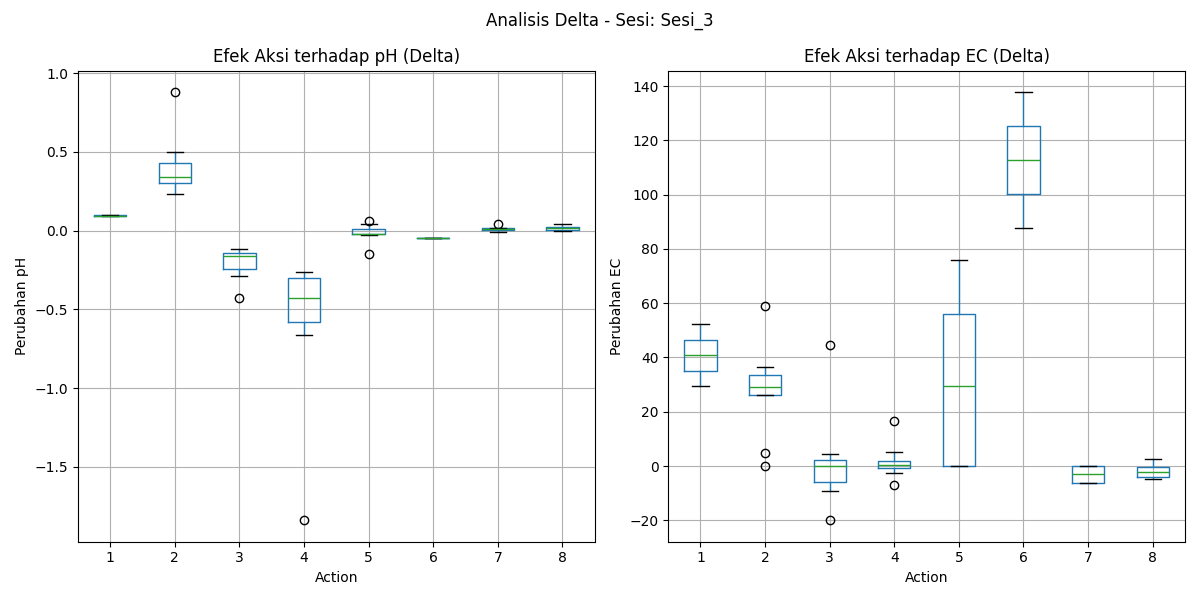
output_data/Sesi_3/3_efek_aksi_boxplot.png
