samuelparlindungan/ML-Q-Learning/output/output_grafik/gambar_4_2_steps.png

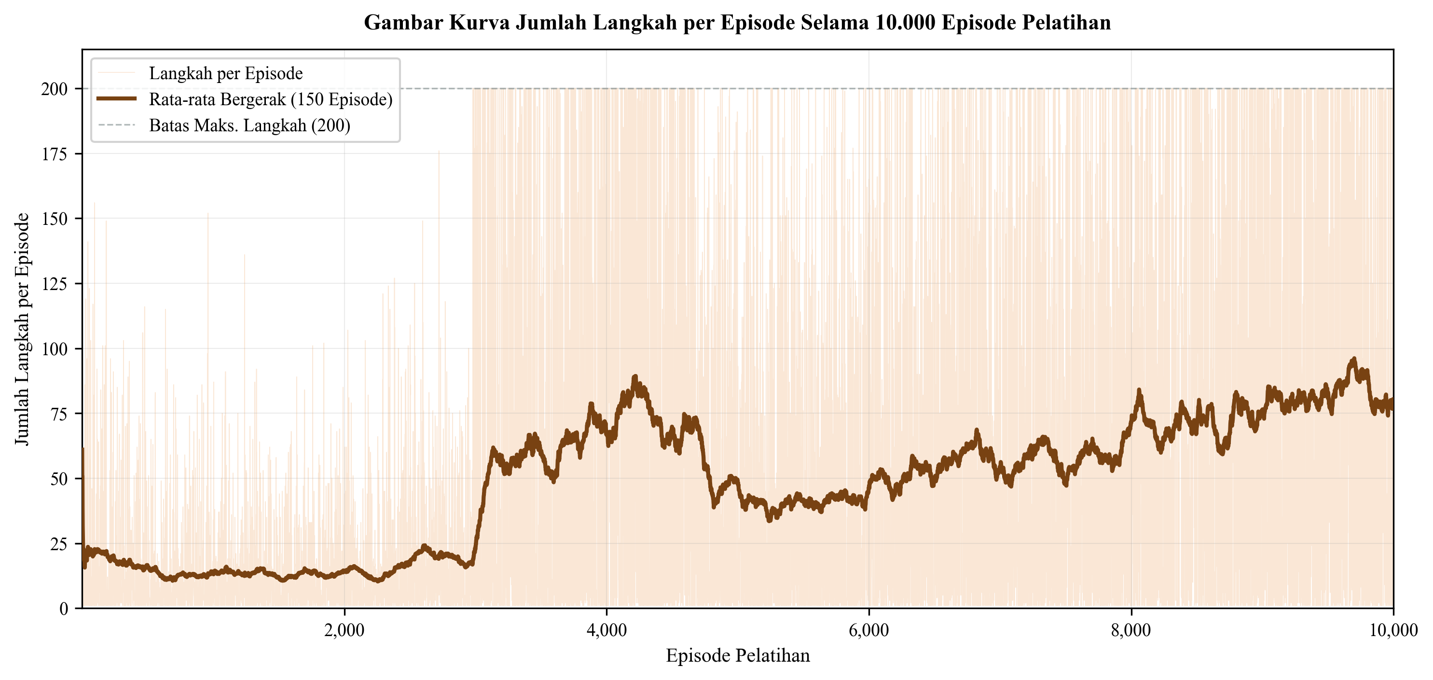
output/output_grafik/gambar_4_2_steps.png
