samuelparlindungan/ML-Q-Learning/output/Renamed_Backup/Grafik_2_Efisiensi_Steps_v6_lama.png

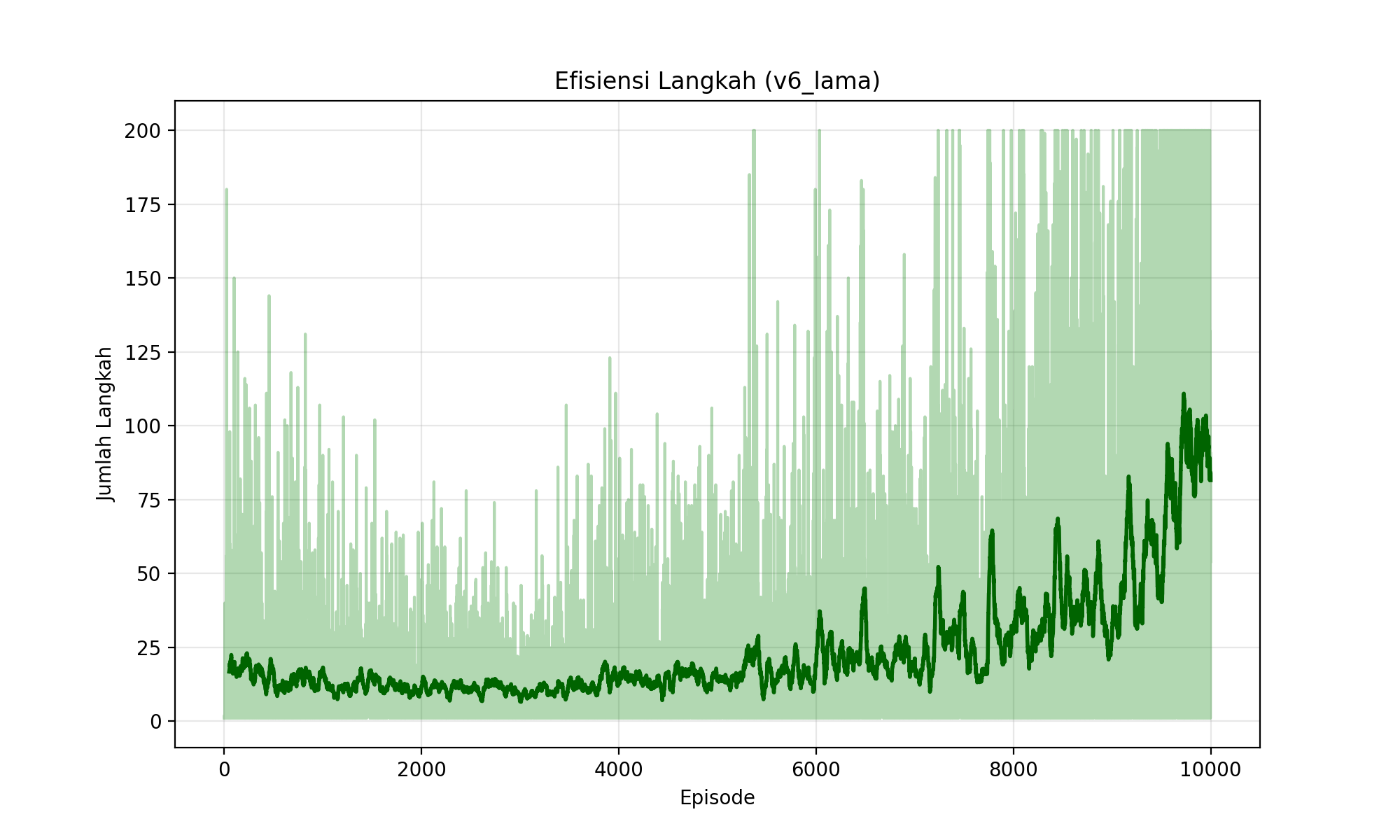
output/Renamed_Backup/Grafik_2_Efisiensi_Steps_v6_lama.png
