samuelparlindungan/ML-Q-Learning/output/v4_dataset_asli/4_step_efficiency.png

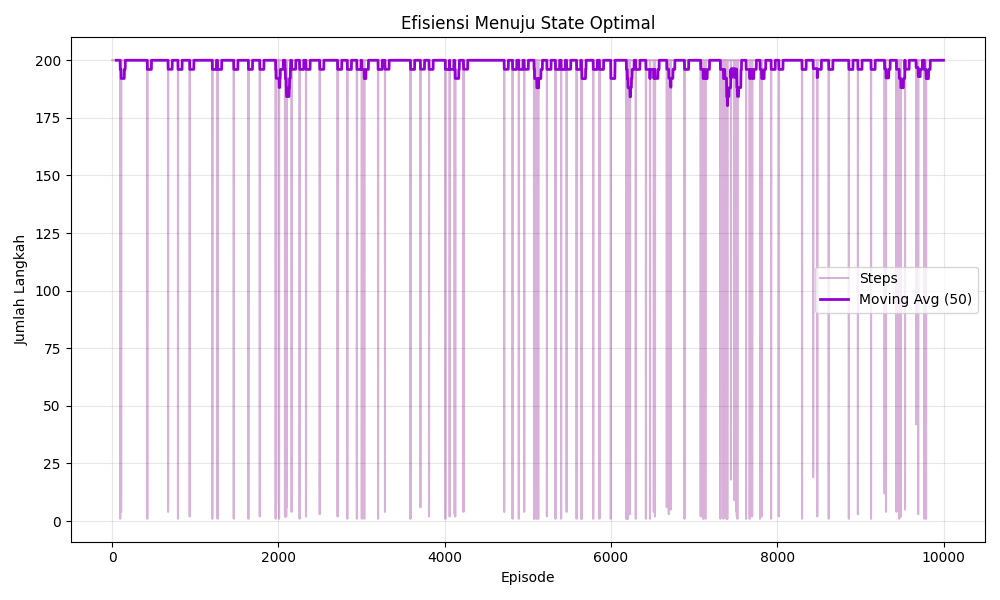
output/v4_dataset_asli/4_step_efficiency.png
