samuelparlindungan/ML-Q-Learning/output/v4_dataset_asli/Grafik_2_Efisiensi_Steps.png

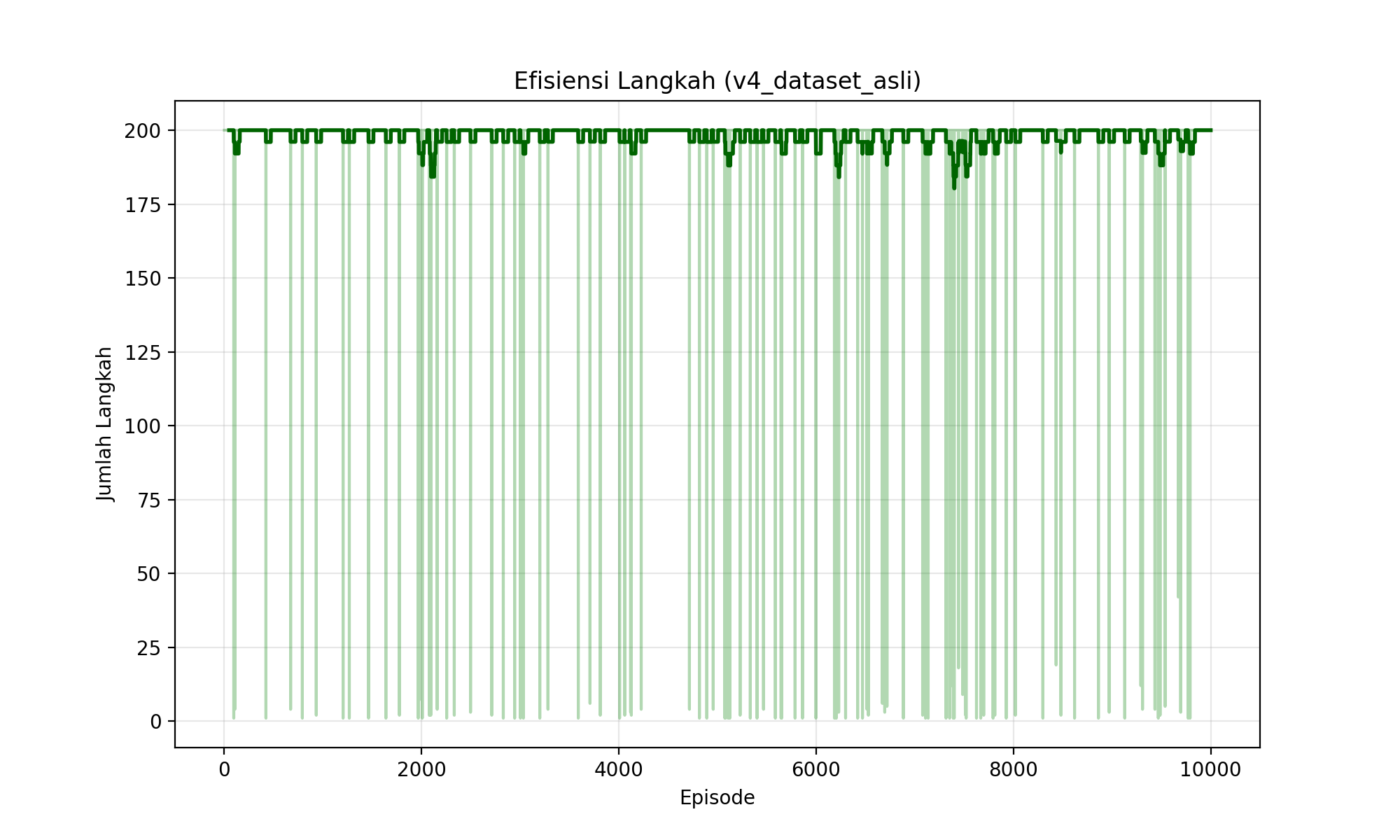
output/v4_dataset_asli/Grafik_2_Efisiensi_Steps.png
