samuelparlindungan/ML-Q-Learning/output/v5_normal_sesi3/Grafik_2_Efisiensi_Steps.png

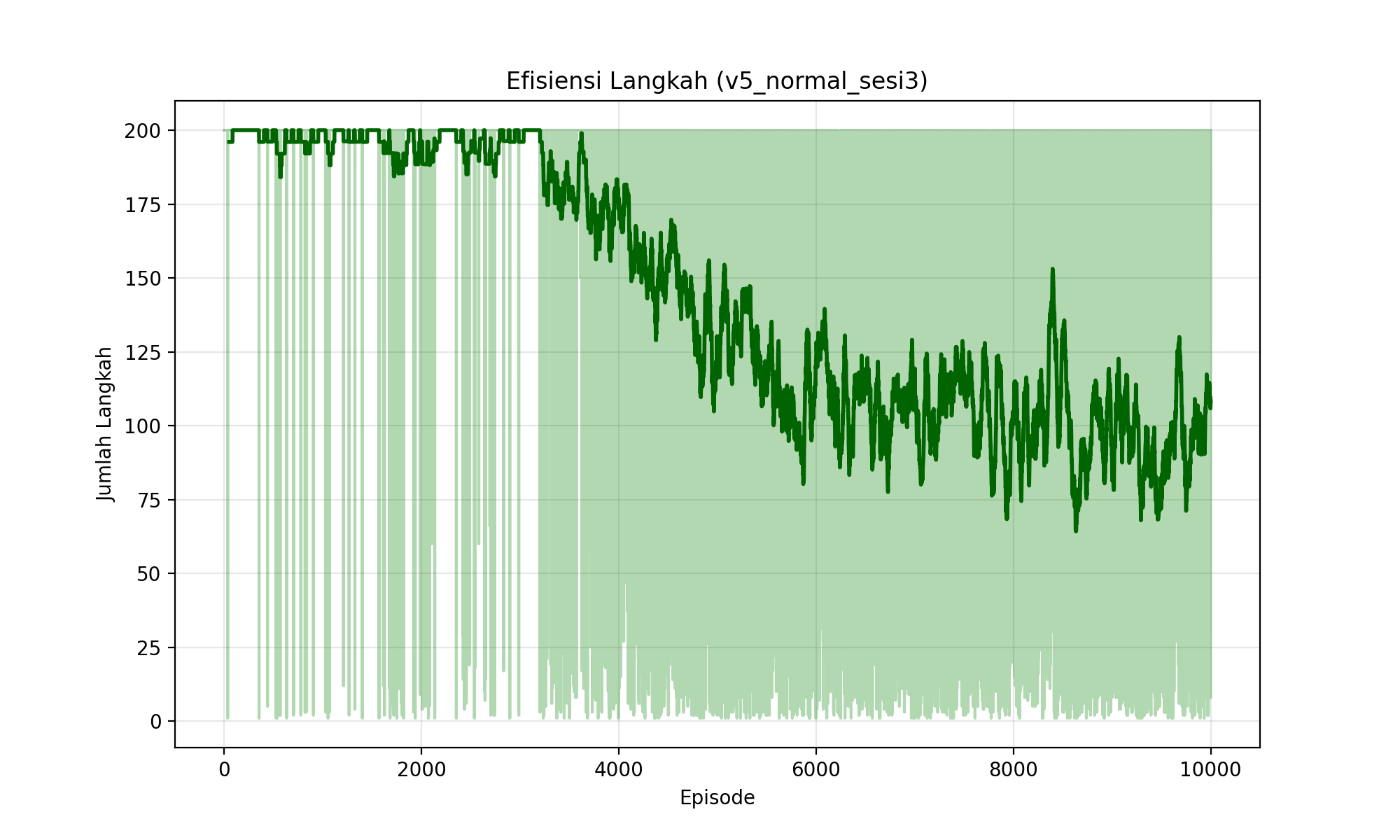
output/v5_normal_sesi3/Grafik_2_Efisiensi_Steps.png
