samuelparlindungan/ML-Q-Learning/(commit log)

2026-04-07 First commit: Implementasi Q-Learning untuk Hidroponik
    [Laporan_Q_Table_Lengkap.xlsx, data_transisi_manual.csv]
2026-04-08 Reorganize .ino files into subfolders + add duration_ms to Bypass + add sensor data CSV
    [Temperature-data-2026-04-08 10_17_39.csv, pH -data-2026-04-08 10_28_57.csv]
2026-04-11 Update actuator firmware reporting and project context master
2026-04-14 feat: stabilize sensor data, non-blocking calibration, and update project context
    [Temperature-data-2026-04-08 10_17_39.csv, pH -data-2026-04-08 10_28_57.csv]
2026-04-15 Organisasi folder kalibrasi: Menambah kalibrasi ultrasonik standalone dan perbaikan ESP32_Sensor
2026-04-15 Sinkronisasi pin Kontrol_Manual dengan ESP32_Aktuator_Bypass
2026-04-18 Update sensor firmware and add random explorer script
2026-04-18 Add ESP32 Aktuator Maintenance firmware
2026-04-20 Finalize project reorganization and data-driven environment updates
    [Laporan_Q_Table_Lengkap.xlsx]
2026-04-20 Allow and push research data for AI analysis
    [data_transisi_manual.csv, data_transisi_otomatis.csv, dataset_acak_qlearning.csv, dataset_acak_qlearning_tanpa_waktu.csv]
2026-04-21 Upload all project files: updated sensor firmware and new exploration data sessions
    [dataset_acak_qlearning.csv]
2026-04-23 Update project: include latest diagnostic graphs and Q-Table reports
    [-.csv, Laporan_Q_Table_Lengkap.xlsx, dataset_acak.csv, dataset_acak_qlearning.csv, dataset_acak_qlearning_tanpa_waktu.csv]
2026-04-28 Upload all project files: latest firmware improvements, analysis scripts, and evaluation data, excluding env_rl.
    [EC (Electrical Conductivity)-data-2026-04-27 21_48_15.csv, EC (Electrical Conductivity)-data-2026-04-27 22_00_47.csv, dataset_acak.csv, dataset_acak_qlearning.csv, dataset_acak_qlearning_tanpa_waktu.csv]
2026-05-01 Update repository: include research docs, AI control system scripts, and stability analysis results
    [EC (Electrical Conductivity)-data-2026-04-27 21_48_15.csv, EC (Electrical Conductivity)-data-2026-04-27 22_00_47.csv, dataset_acak_qlearning.csv, dataset_acak_qlearning.xlsx]
2026-05-03 Update hydroponic control system: reward shaping, deployment helpers, and reliability improvements. Fixed main_test_model.py for Windows.
    [CodeVisionAVR.msi.ino, DFRobot_EC.cpp, DFRobot_PH.cpp, ESP32_Aktuator_Maintenance.ino, env_ph_ec.py, main_auto_control.py]
2026-05-15 Update: tambah skrip analisis, grafik output, data Q-table, dan dataset terbaru
    - Tambah skrip baru: generate_grafik_bab4, generate_grafik_lampiran, generate_qtable_heatmap/tabel, visualize_results, visualize_state_transitions, export_qtable_to_excel, convert_npy_to_txt, build_project_md
    - Update skrip: ekstrak_statistik, env_ph_ec, main_auto_control, random_explorer_v1, visualize_dataset
    - Tambah grafik output lengkap: output_grafik (Bab 4), output_grafik_qtable, output_grafik_transisi, output_lampiran (4 sesi)
    - Tambah output_data per sesi (Sesi 1-4 + Semua_Sesi), hapus folder Eksplorasi_Sesi lama
    - Tambah Q-table text version, Tabel_Q_Values CSV, data_transisi_otomatis, system_log
    - Updat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
    [EC (Electrical Conductivity)-data-2026-05-03 21_33_33.csv, Tabel_Q_Values_v6_final.csv, data_transisi_otomatis.csv, dataset_acak_qlearning.csv, dataset_acak_qlearning_tanpa_waktu.csv, system_log.csv]
